MartinSchafferer/Sensorik_MarsRover/5. Fotos/Photo 02.02.19, 16 32 19.jpg

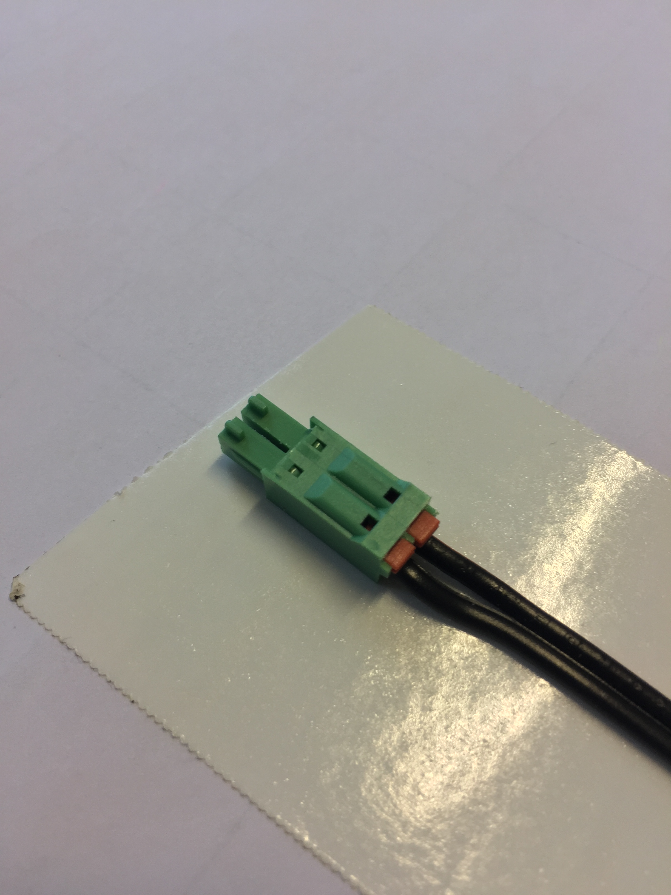
5. Fotos/Photo 02.02.19, 16 32 19.jpg
