MartinSchafferer/Sensorik_MarsRover/3. Elektronik/Rover/Datasheets_extLibraries/DCConverter/Links.txt

https://katalog.we-online.de/de/pm/MAGIC-FDSM
https://katalog.we-online.de/de/pm/MAGIC-VDRM
https://www.mouser.at/ProductDetail/Murata-Power-Solutions/OKI-78SR-5-15-W36HE-C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
https://www.mouser.at/Power/DC-DC-Converters/Non-Isolated-DC-DC-Converters/_/N-brvxx?P=1yzvr6d
