MartinSchafferer/Sensorik_MarsRover/3. Elektronik/Rover/Datasheets_extLibraries/Gyro/Links.txt

https://at.rs-online.com/web/p/products/8837948/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
https://www.invensense.com/products/motion-tracking/6-axis/mpu-6050/
https://electronics.semaf.at/Triple-Axis-Accelerometer-and-Gyro-Breakout-MPU6050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
