MartinSchafferer/Sensorik_MarsRover/3. Elektronik/Rover/Datasheets_extLibraries/Linetracker/Links.txt

http://sensorkit.en.joy-it.net/index.php?title=KY-033_Tracking_sensor_module
