MartinSchafferer/Sensorik_MarsRover/3. Elektronik/Rover/Datasheets_extLibraries/Capacitors/DCConverter/Links.txt

https://katalog.we-online.de/de/pbs/WCAP-CSGP-1210/885012109009?sid=e49973b58e#vs_ct:3
https://katalog.we-online.de/de/pbs/WCAP-ASLU/865090245005?sid=fa7994bd28
https://katalog.we-online.de/de/pbs/WCAP-CSGP-1210/885012109013?sid=c01c210bf1#vs_ct:4
https://katalog.we-online.de/de/pbs/search/capacitors/1290754
