MartinSchafferer/Sensorik_MarsRover/3. Elektronik/Rover/Datasheets_extLibraries/DCSupplyConnector/Links.txt

https://katalog.we-online.de/de/em/TBL_5_00_102_6911027100XX
