MartinSchafferer/Sensorik_MarsRover/3. Elektronik/Rover/Datasheets_extLibraries/Resistors/DCConverter/Links.txt

https://katalog.we-online.de/de/pbs/WRIS-KSKE#vs_t1:1_ct:3
