MartinSchafferer/Sensorik_MarsRover/5. Fotos/Blockschaltbild_01.jpg

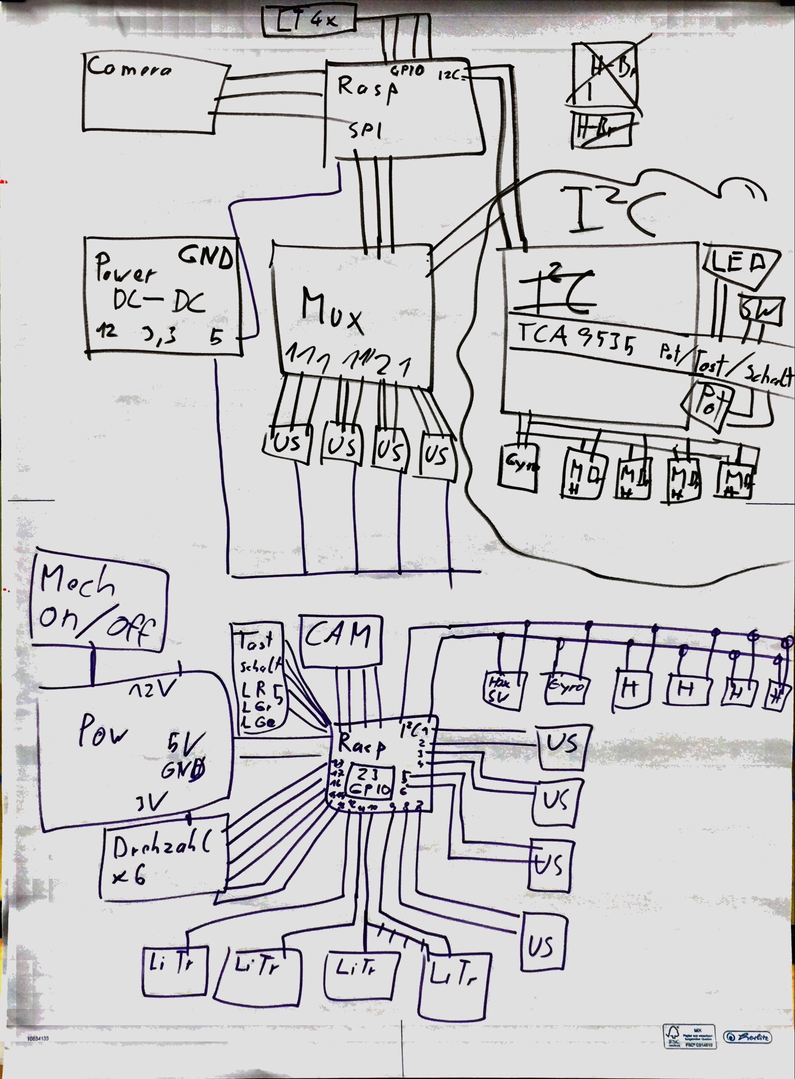
5. Fotos/Blockschaltbild_01.jpg
