MartinSchafferer/Sensorik_MarsRover/5. Fotos/Flipchart_01.jpg

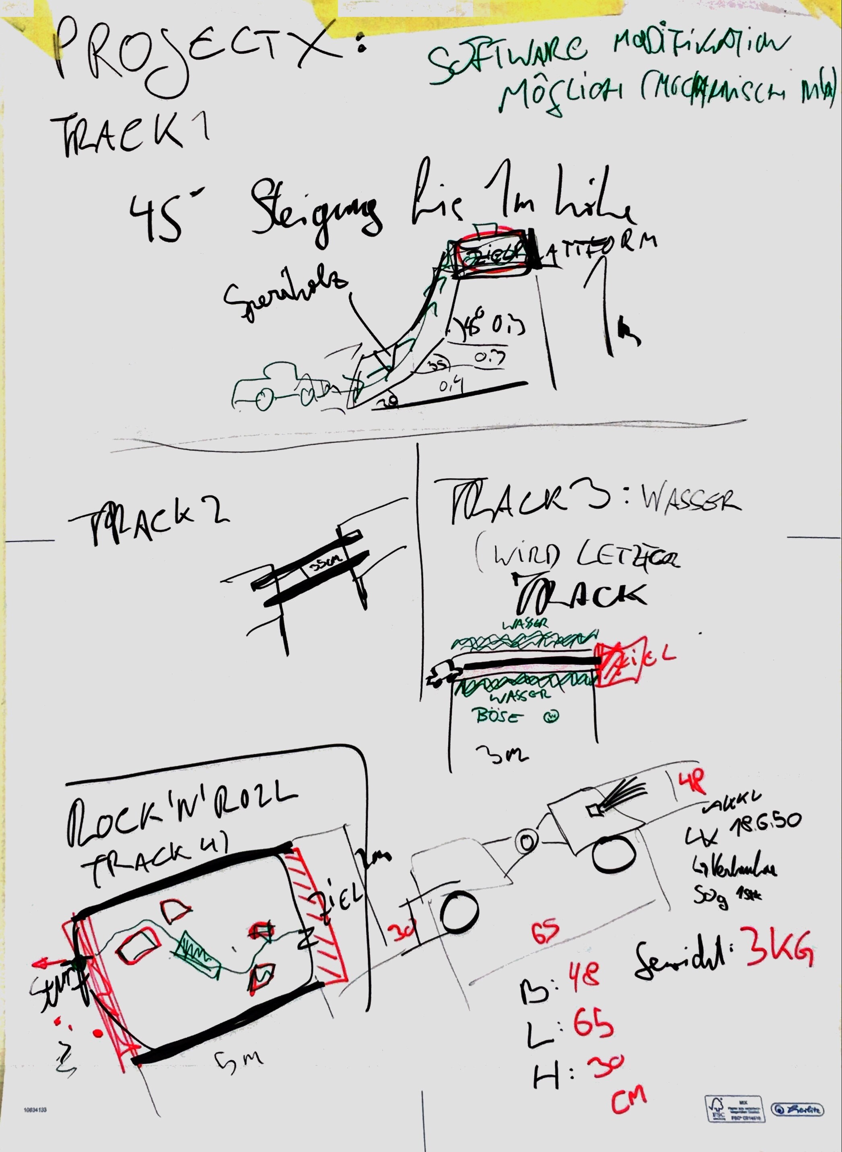
5. Fotos/Flipchart_01.jpg
