MartinSchafferer/Sensorik_MarsRover/5. Fotos/Flipchart_02.jpg

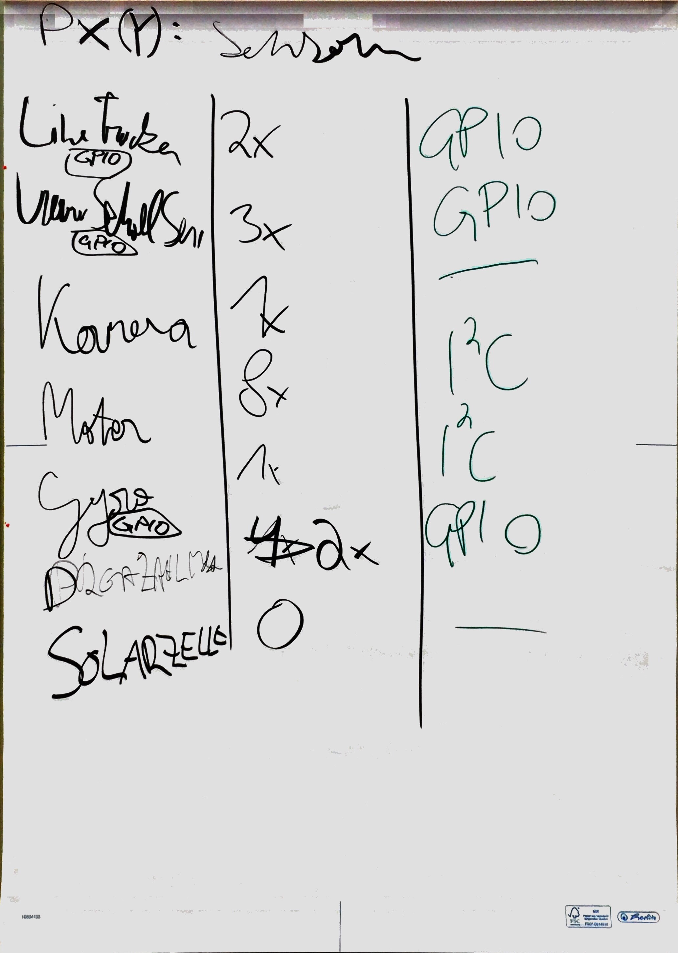
5. Fotos/Flipchart_02.jpg
