MartinSchafferer/Sensorik_MarsRover/5. Fotos/Flipchart_04.jpg

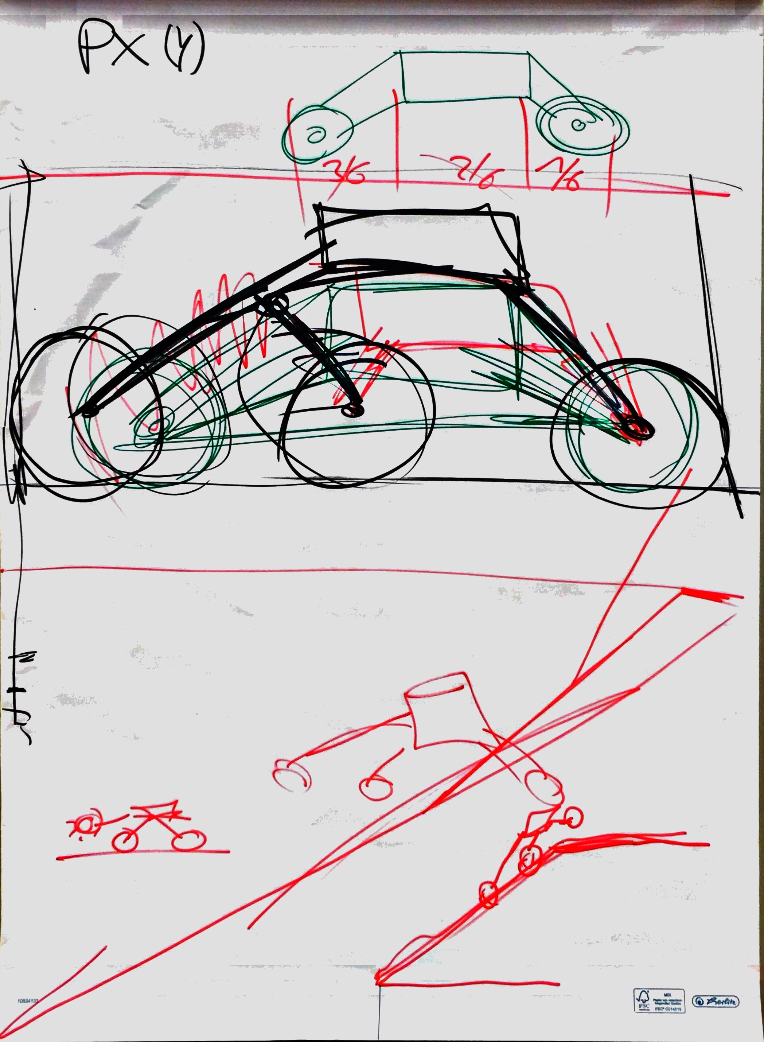
5. Fotos/Flipchart_04.jpg
