MartinSchafferer/Sensorik_MarsRover/5. Fotos/MarsRoverGesamt.PNG

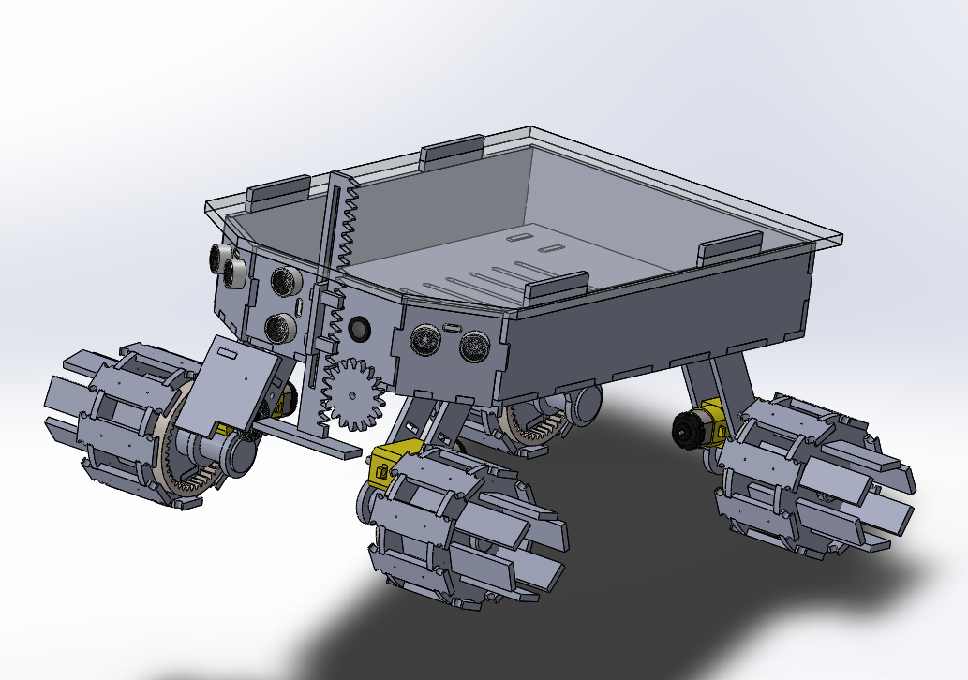
5. Fotos/MarsRoverGesamt.PNG
