MartinSchafferer/Sensorik_MarsRover/5. Fotos/Photo 02.02.19, 16 26 04.jpg

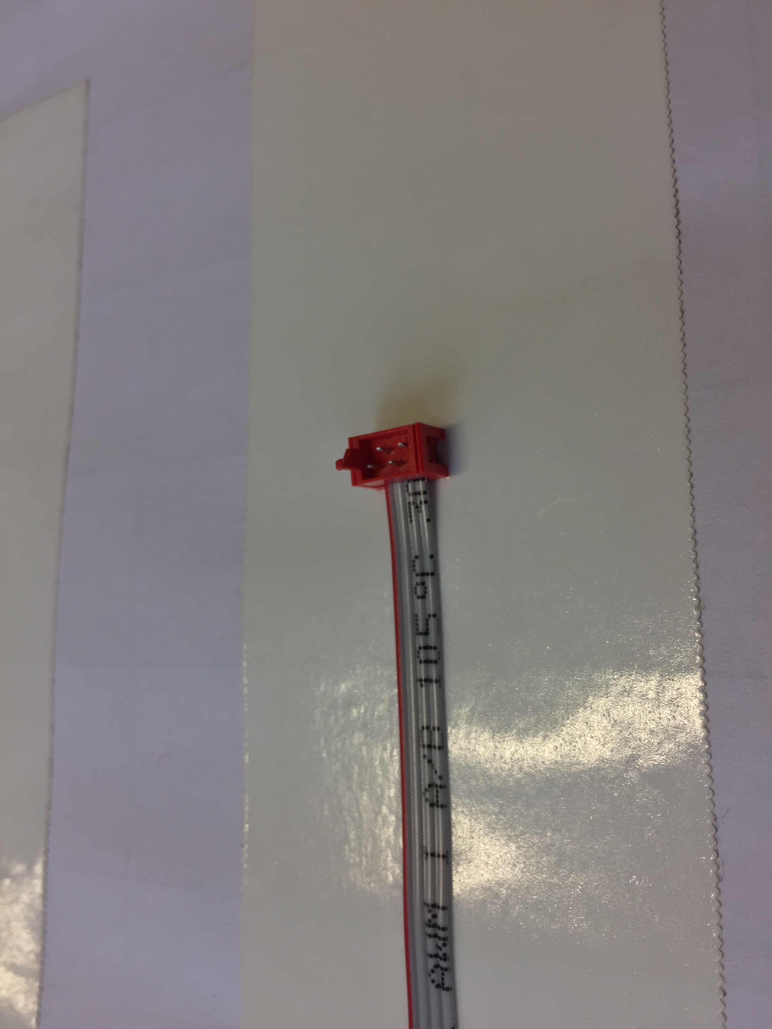
5. Fotos/Photo 02.02.19, 16 26 04.jpg
