MartinSchafferer/Sensorik_MarsRover/5. Fotos/Photo 02.02.19, 16 36 40.jpg

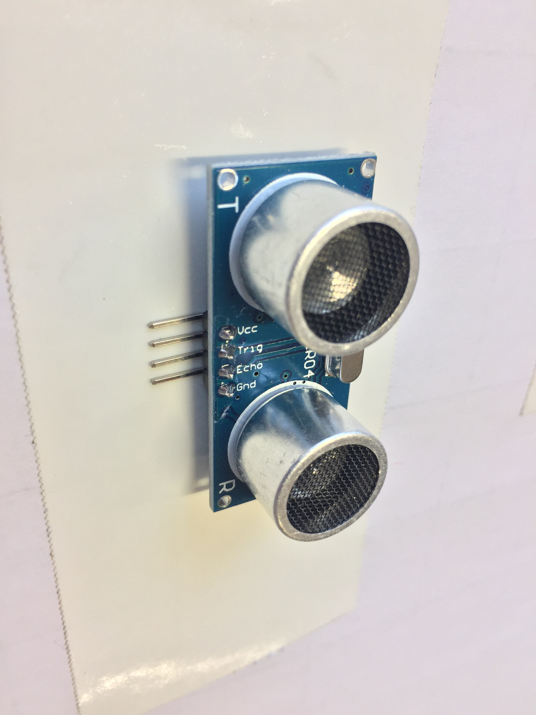
5. Fotos/Photo 02.02.19, 16 36 40.jpg
