MartinSchafferer/Sensorik_MarsRover/5. Fotos/Photo 02.02.19, 18 21 54.jpg

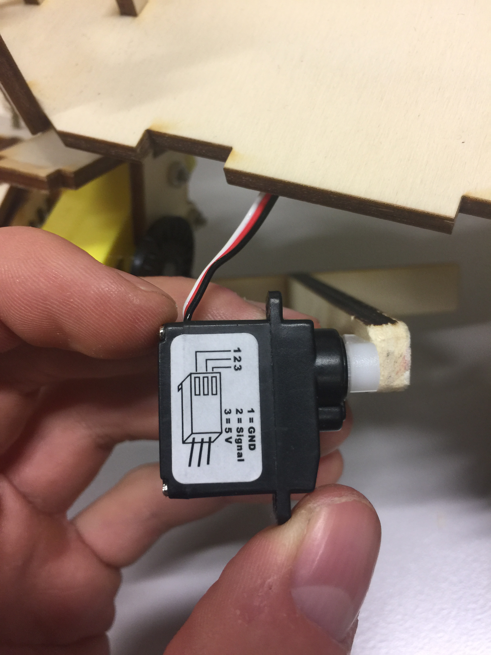
5. Fotos/Photo 02.02.19, 18 21 54.jpg
