MartinSchafferer/Sensorik_MarsRover/5. Fotos/WhatsApp Image 2019-01-25 at 15.22.44.jpeg

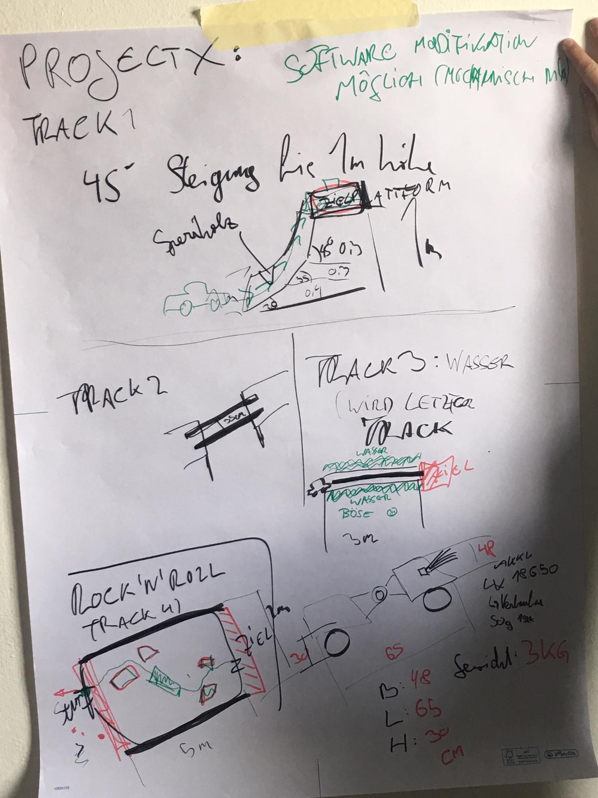
5. Fotos/WhatsApp Image 2019-01-25 at 15.22.44.jpeg
