MartinSchafferer/Sensorik_MarsRover/5. Fotos/WhatsApp Image 2019-02-08 at 19.00.05.jpeg

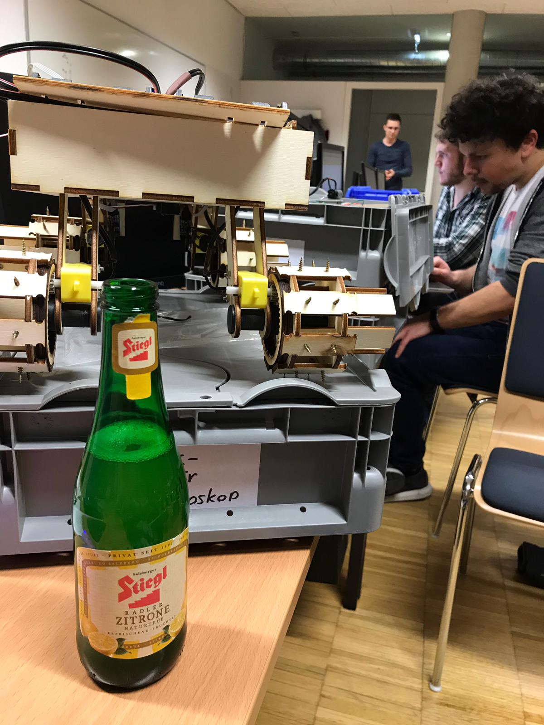
5. Fotos/WhatsApp Image 2019-02-08 at 19.00.05.jpeg
