MartinSchafferer/Sensorik_MarsRover/2. Konstruktion/CAD/Track 2.SLDASM

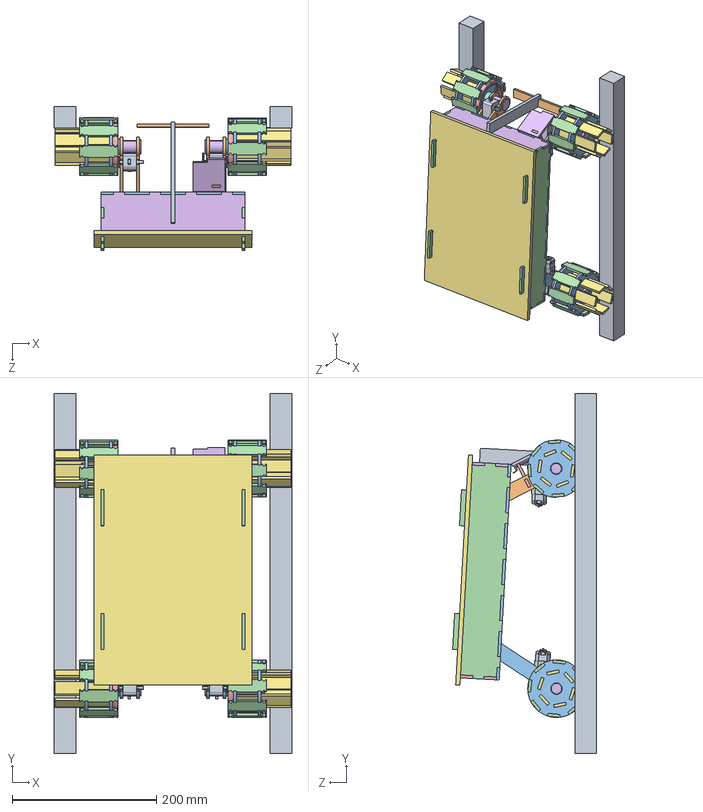
[picture p39: CAD file, 2019-12-10]
2. Konstruktion/CAD/Track 2.SLDASM
330.0 x 500.0 x 199.7 mm
Brücke
Radaufhängung x 4
Radfelge x 8
Radauflager x 32
internal spur gear_iso x 4
Lagerbolzen x 4
Radverlängerung x 24
Abstandshülse x 4
Motor x 4
Zahnrad_klein x 4
Gehäuseunterteil
Gehäuse_seite x 2
Gehause_hinten
Gehause_vorne
Optoacoplador LM393
Lochscheibe
Linetracker_Stange
Linetrackerhalter
Radaufhängung_hinten x 4
Antriebswelle
Distanzhalter
Wasserschutz
Deckel
