MartinSchafferer/Sensorik_MarsRover/2. Konstruktion/CAD/Bewegungsaufbau.SLDASM

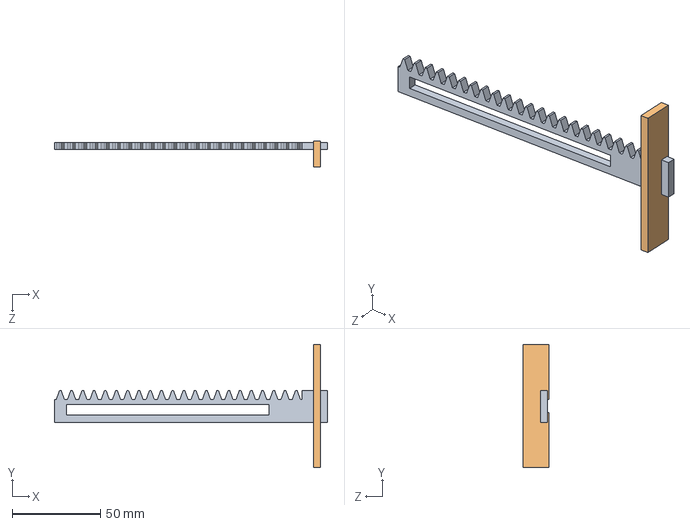
[picture p40: CAD file, 2019-12-10]
2. Konstruktion/CAD/Bewegungsaufbau.SLDASM
155.0 x 70.0 x 15.0 mm
Bewegungsstange
Linetrackerhalter
