MartinSchafferer/Sensorik_MarsRover/2. Konstruktion/CAD/Track 1.SLDASM

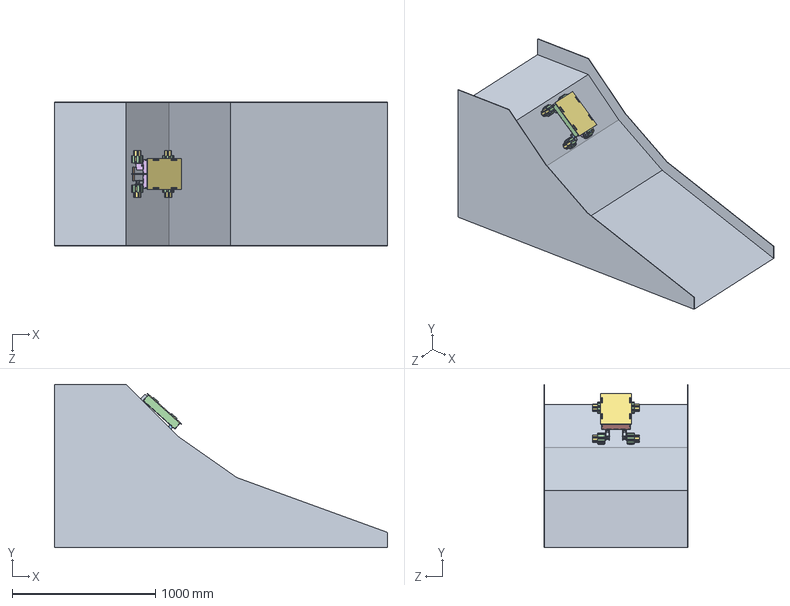
[picture p41: CAD file, 2019-12-10]
2. Konstruktion/CAD/Track 1.SLDASM
2327.4 x 1141.4 x 1008.0 mm
Rampe_Track1
Radaufhängung x 4
Radfelge x 8
Radauflager x 32
internal spur gear_iso x 4
Lagerbolzen x 4
Radverlängerung x 24
Abstandshülse x 4
Motor x 4
Zahnrad_klein x 4
Gehäuseunterteil
Gehäuse_seite x 2
Gehause_hinten
Gehause_vorne
Optoacoplador LM393
Lochscheibe
Linetracker_Stange
Linetrackerhalter
Radaufhängung_hinten x 4
Antriebswelle
Distanzhalter
Wasserschutz
Deckel
