MartinSchafferer/Sensorik_MarsRover/2. Konstruktion/CAD/Gehäuse.SLDASM

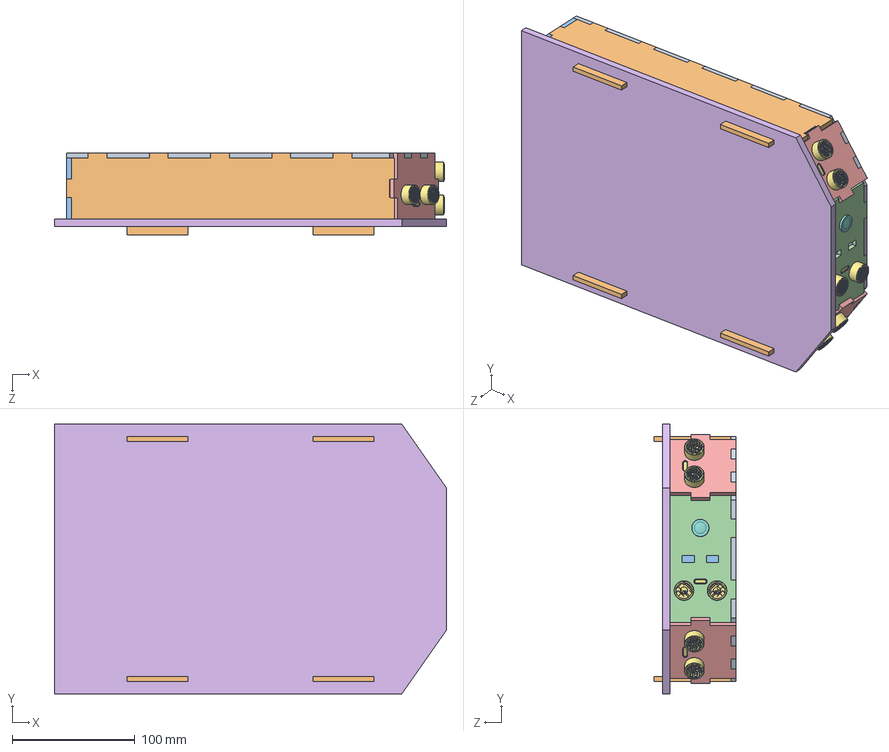
[picture p42: CAD file, 2019-12-10]
2. Konstruktion/CAD/Gehäuse.SLDASM
320.0 x 220.0 x 67.0 mm
Gehäuseunterteil
Gehäuse_seite x 2
Gehause_hinten
Gehause_vorne
Seitenteil_Gehäuse x 2
Deckel
Ultrasonic HCSR04 x 3
CAMERA PI COM LENTE
