MartinSchafferer/Sensorik_MarsRover/2. Konstruktion/CAD/Rad_gesamt.SLDASM

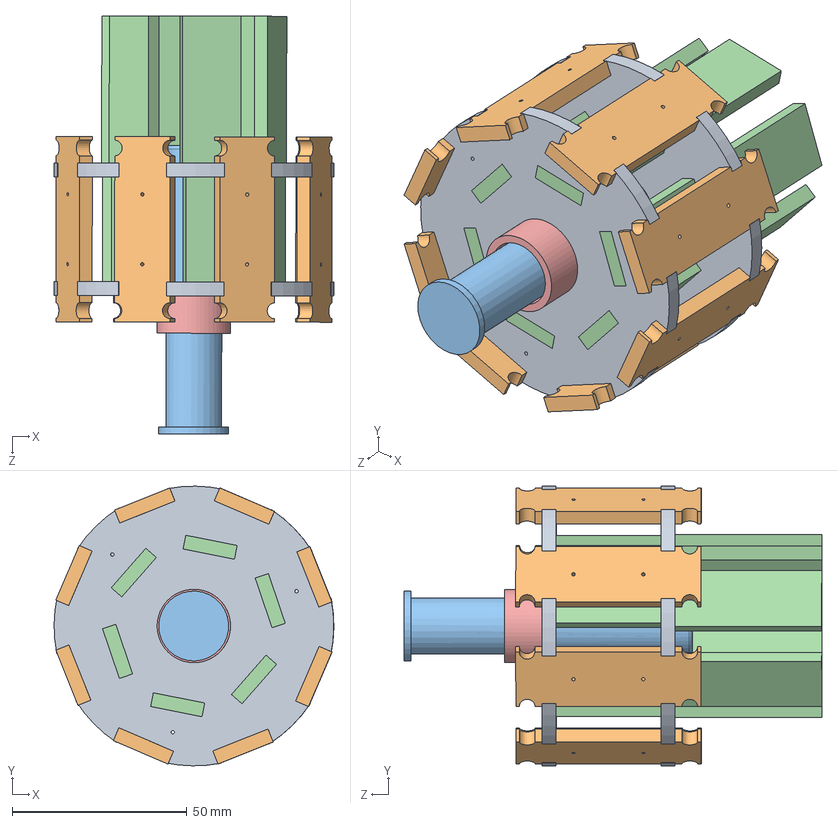
[picture p43: CAD file, 2019-12-10]
2. Konstruktion/CAD/Rad_gesamt.SLDASM
80.1 x 80.0 x 119.6 mm
Radfelge x 2
Radauflager x 8
Lagerbolzen
Radverlängerung x 6
Abstandshülse
