MartinSchafferer/Sensorik_MarsRover/2. Konstruktion/CAD/Linetracker_gesamt.SLDASM

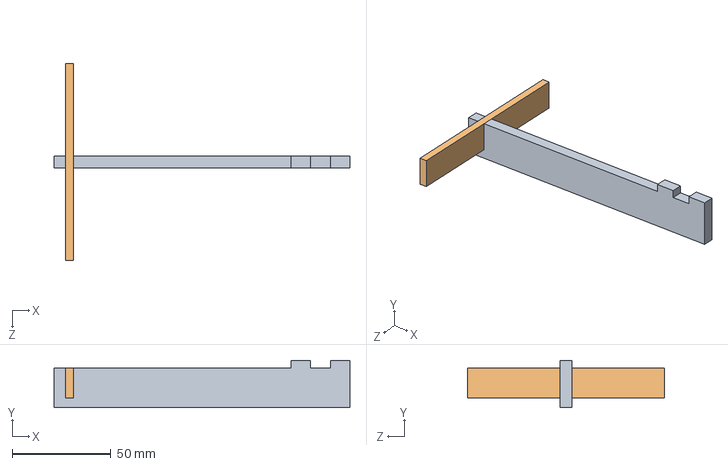
[picture p44: CAD file, 2019-12-10]
2. Konstruktion/CAD/Linetracker_gesamt.SLDASM
150.0 x 24.0 x 100.0 mm
Linetracker_Stange
Linetrackerhalter
