MartinSchafferer/Sensorik_MarsRover/2. Konstruktion/CAD/DXF Datei/Passlehre/Passungslehre.DXF

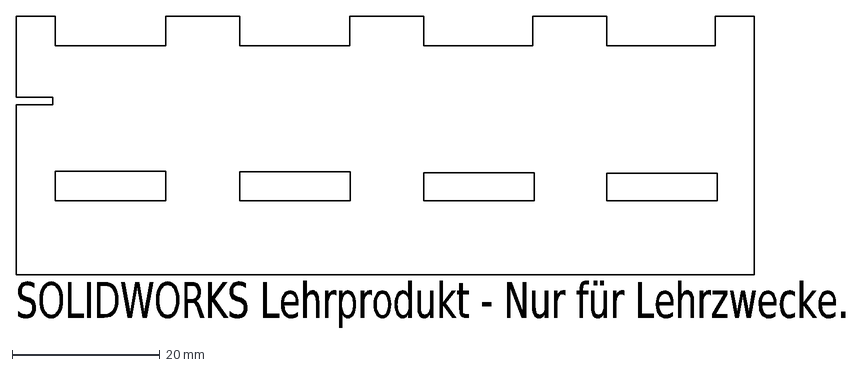
[picture p45: CAD file, 2019-12-10]
2. Konstruktion/CAD/DXF Datei/Passlehre/Passungslehre.DXF
SOLIDWORKS Lehrprodukt - Nur für Lehrzwecke.
