MartinSchafferer/Sensorik_MarsRover/2. Konstruktion/CAD/DXF Datei/Radaufhängung_hinten.DXF

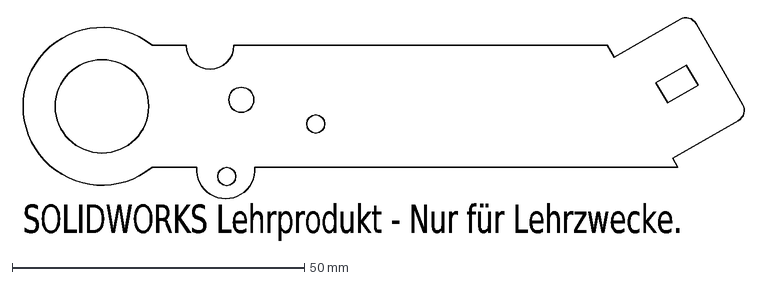
[picture p46: CAD file, 2019-12-10]
2. Konstruktion/CAD/DXF Datei/Radaufhängung_hinten.DXF
SOLIDWORKS Lehrprodukt - Nur für Lehrzwecke.
