MartinSchafferer/Sensorik_MarsRover/2. Konstruktion/CAD/Führungsstifte.SLDPRT

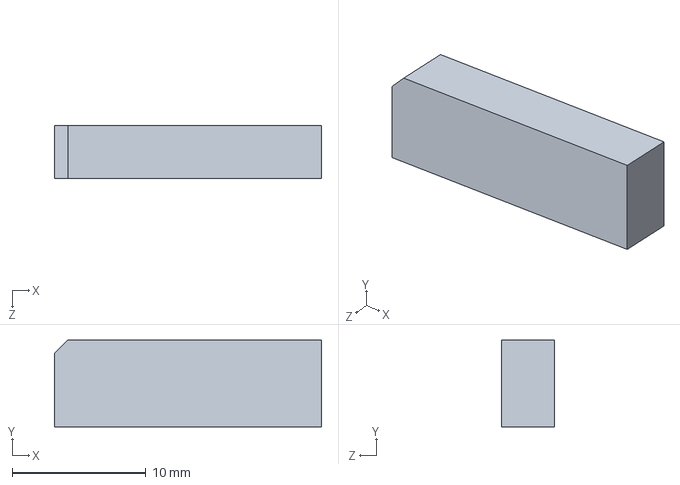
[picture p47: CAD file, 2019-12-10]
2. Konstruktion/CAD/Führungsstifte.SLDPRT
20.0 x 6.50 x 4.00 mm
