MartinSchafferer/Sensorik_MarsRover/2. Konstruktion/CAD/DXF Datei/Passlehre/Passungslehre2.DXF

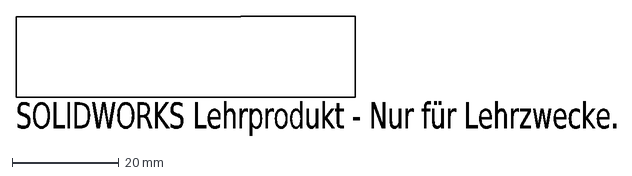
[picture p48: CAD file, 2019-12-10]
2. Konstruktion/CAD/DXF Datei/Passlehre/Passungslehre2.DXF
SOLIDWORKS Lehrprodukt - Nur für Lehrzwecke.
