MartinSchafferer/Sensorik_MarsRover/2. Konstruktion/CAD/DXF Datei/Radauflager.DXF

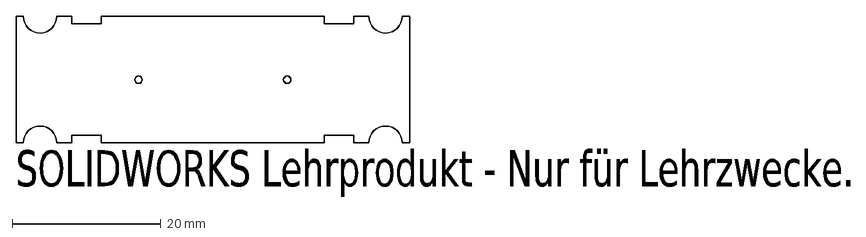
[picture p49: CAD file, 2019-12-10]
2. Konstruktion/CAD/DXF Datei/Radauflager.DXF
SOLIDWORKS Lehrprodukt - Nur für Lehrzwecke.
