MartinSchafferer/Sensorik_MarsRover/2. Konstruktion/CAD/Führungsschiene.SLDPRT

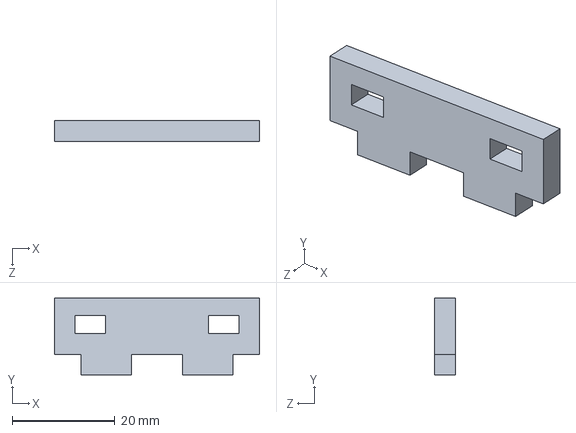
[picture p50: CAD file, 2019-12-10]
2. Konstruktion/CAD/Führungsschiene.SLDPRT
40.0 x 15.0 x 4.00 mm
