MartinSchafferer/Sensorik_MarsRover/2. Konstruktion/CAD/DXF Datei/Gehause_hinten.DXF

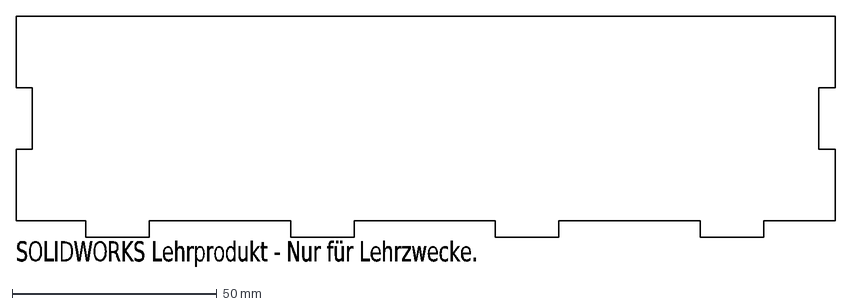
[picture p51: CAD file, 2019-12-10]
2. Konstruktion/CAD/DXF Datei/Gehause_hinten.DXF
SOLIDWORKS Lehrprodukt - Nur für Lehrzwecke.
