MartinSchafferer/Sensorik_MarsRover/2. Konstruktion/CAD/DXF Datei/Passlehre/Passungslehre3.DXF

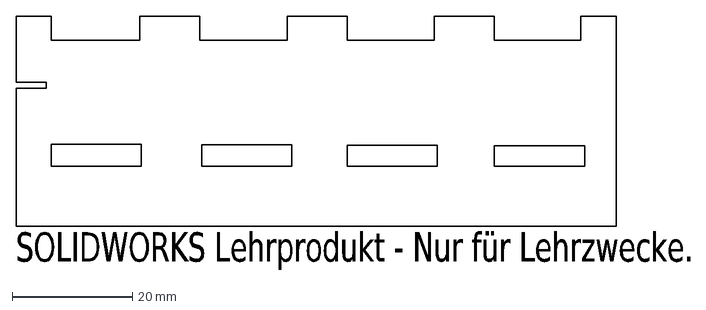
[picture p52: CAD file, 2019-12-10]
2. Konstruktion/CAD/DXF Datei/Passlehre/Passungslehre3.DXF
SOLIDWORKS Lehrprodukt - Nur für Lehrzwecke.
