MartinSchafferer/Sensorik_MarsRover/2. Konstruktion/CAD/Rampe_Track1.SLDPRT

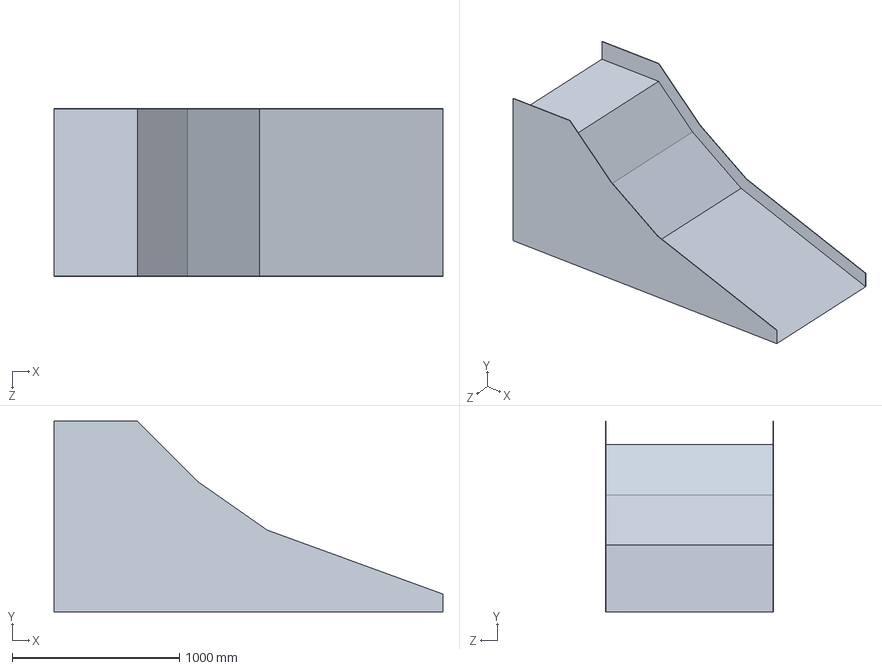
[picture p53: CAD file, 2019-12-10]
2. Konstruktion/CAD/Rampe_Track1.SLDPRT
2327.4 x 1141.4 x 1008.0 mm
