MartinSchafferer/Sensorik_MarsRover/2. Konstruktion/CAD/DXF Datei/Führungsschiene.DXF

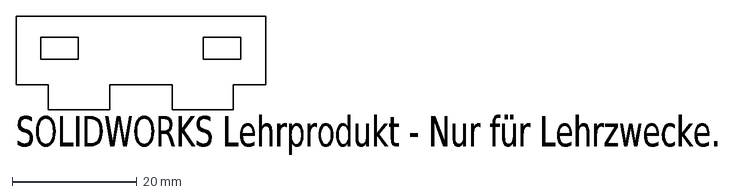
[picture p54: CAD file, 2019-12-10]
2. Konstruktion/CAD/DXF Datei/Führungsschiene.DXF
SOLIDWORKS Lehrprodukt - Nur für Lehrzwecke.
