MartinSchafferer/Sensorik_MarsRover/2. Konstruktion/CAD/Optoacoplador LM393.SLDPRT

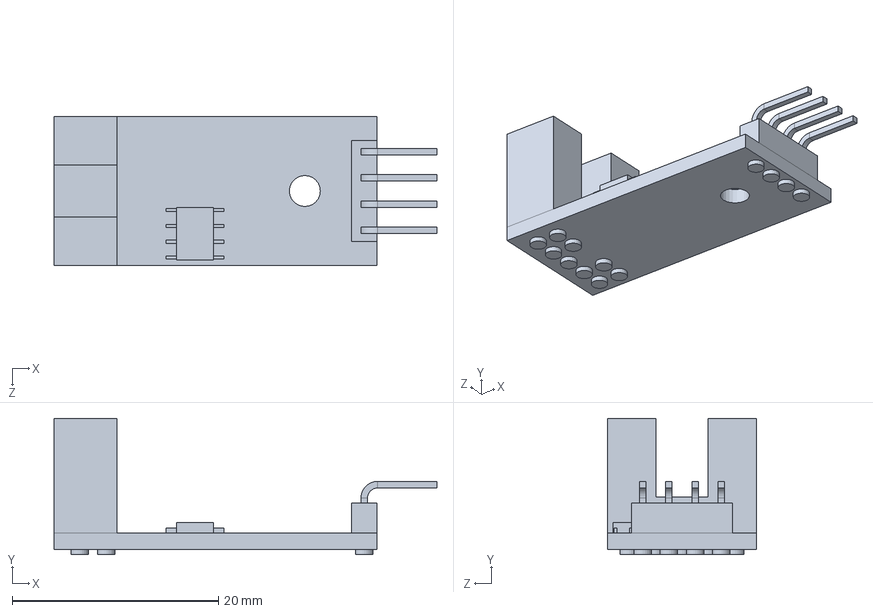
[picture p55: CAD file, 2019-12-10]
2. Konstruktion/CAD/Optoacoplador LM393.SLDPRT
37.1 x 13.2 x 14.4 mm
