MartinSchafferer/Sensorik_MarsRover/2. Konstruktion/CAD/DXF Datei/Seitenteil_Gehäuse.DXF

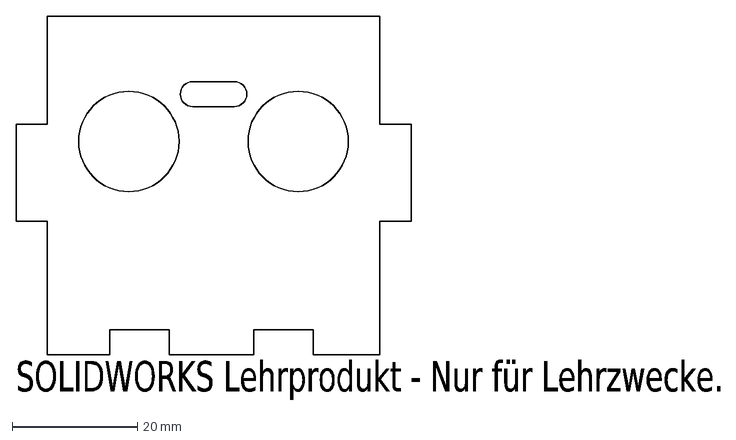
[picture p56: CAD file, 2019-12-10]
2. Konstruktion/CAD/DXF Datei/Seitenteil_Gehäuse.DXF
SOLIDWORKS Lehrprodukt - Nur für Lehrzwecke.
