MartinSchafferer/Sensorik_MarsRover/2. Konstruktion/CAD/Motor.SLDPRT

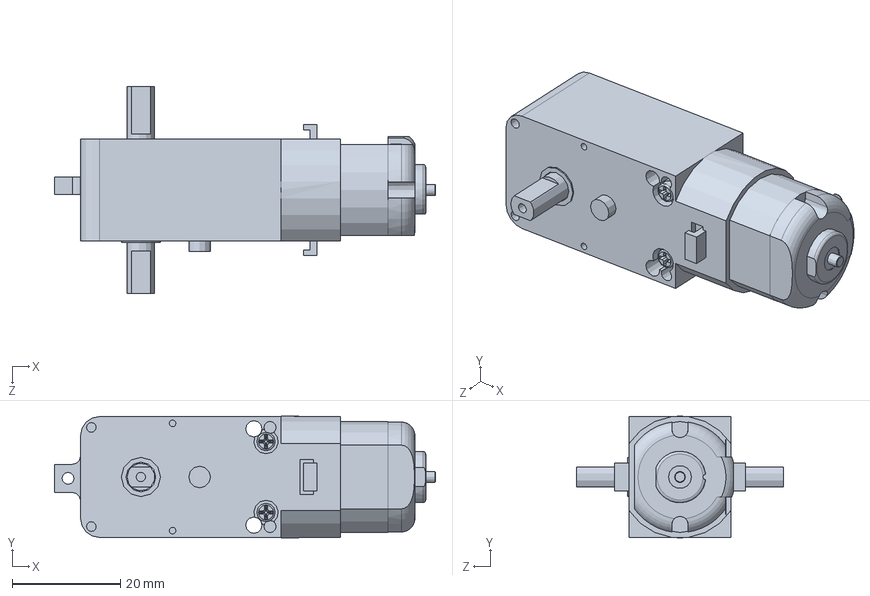
[picture p57: CAD file, 2019-12-10]
2. Konstruktion/CAD/Motor.SLDPRT
70.3 x 22.5 x 38.2 mm
