MartinSchafferer/Sensorik_MarsRover/2. Konstruktion/CAD/DXF Datei/Linetracker_Stange.DXF

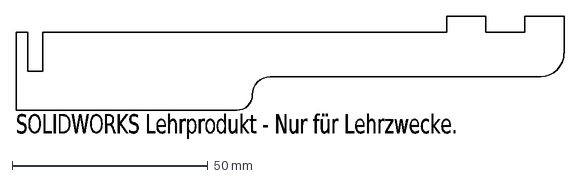
[picture p58: CAD file, 2019-12-10]
2. Konstruktion/CAD/DXF Datei/Linetracker_Stange.DXF
SOLIDWORKS Lehrprodukt - Nur für Lehrzwecke.
