MartinSchafferer/Sensorik_MarsRover/2. Konstruktion/CAD/Radaufhängung_hinten.SLDPRT

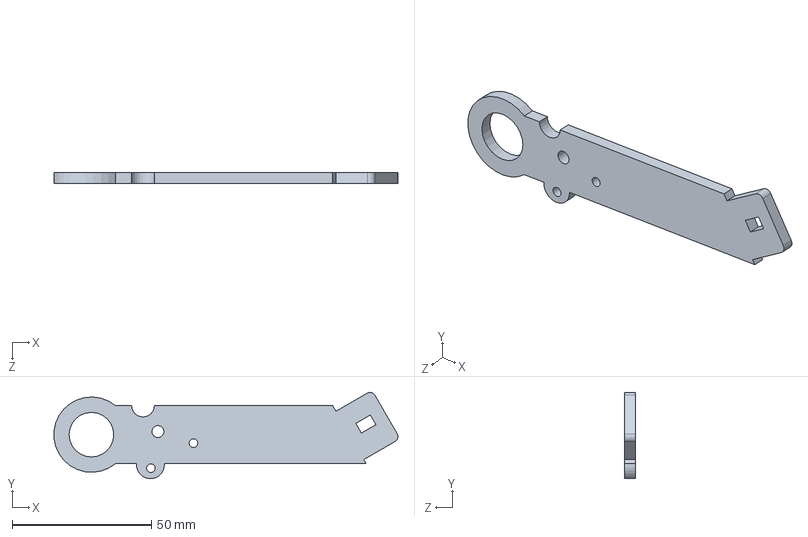
[picture p59: CAD file, 2019-12-10]
2. Konstruktion/CAD/Radaufhängung_hinten.SLDPRT
123.4 x 30.9 x 4.00 mm
