MartinSchafferer/Sensorik_MarsRover/2. Konstruktion/CAD/DXF Datei/Linetrackerhalter.DXF

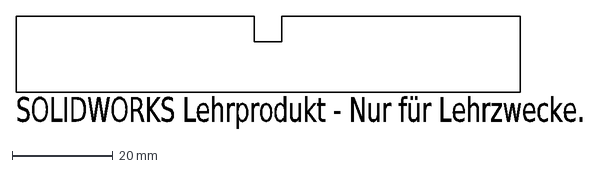
[picture p60: CAD file, 2019-12-10]
2. Konstruktion/CAD/DXF Datei/Linetrackerhalter.DXF
SOLIDWORKS Lehrprodukt - Nur für Lehrzwecke.
