MartinSchafferer/Sensorik_MarsRover/2. Konstruktion/CAD/ZweiterBoden.SLDPRT

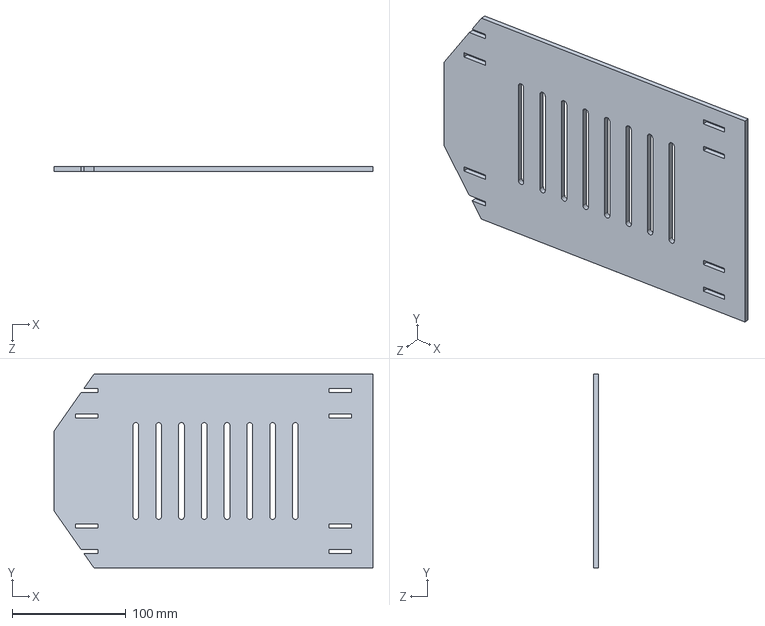
[picture p61: CAD file, 2019-12-10]
2. Konstruktion/CAD/ZweiterBoden.SLDPRT
280.0 x 170.0 x 4.00 mm
