MartinSchafferer/Sensorik_MarsRover/2. Konstruktion/CAD/DXF Datei/Gehause_vorne.DXF

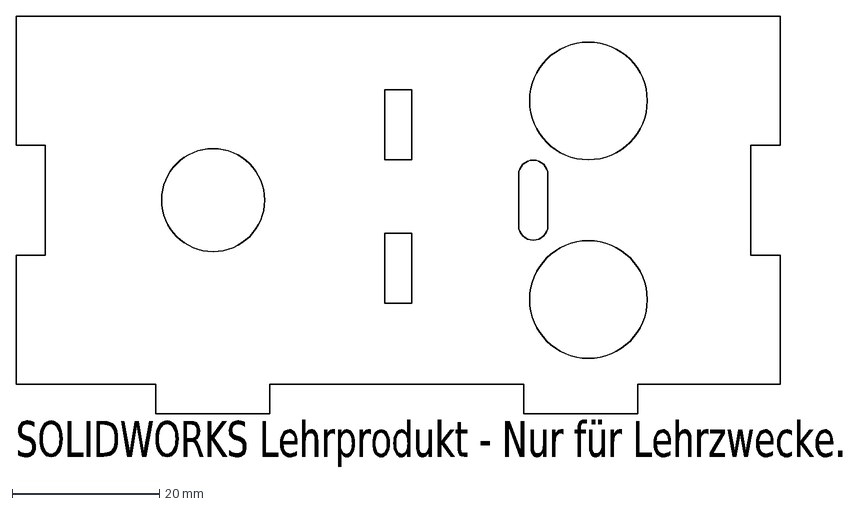
[picture p62: CAD file, 2019-12-10]
2. Konstruktion/CAD/DXF Datei/Gehause_vorne.DXF
SOLIDWORKS Lehrprodukt - Nur für Lehrzwecke.
