MartinSchafferer/Sensorik_MarsRover/2. Konstruktion/CAD/DXF Datei/Deckel.DXF

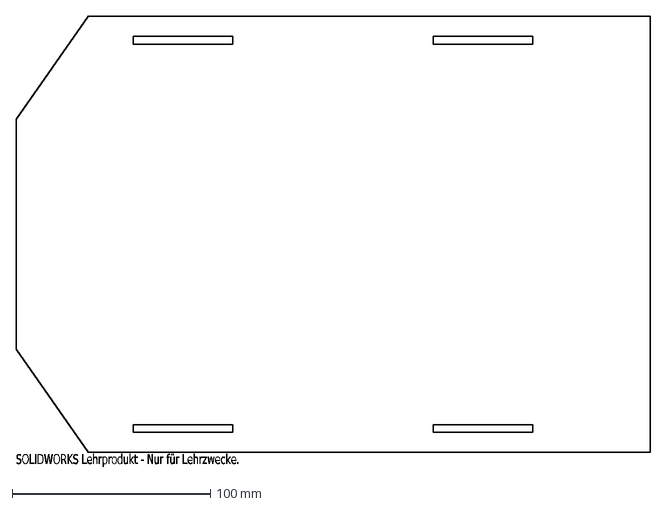
[picture p63: CAD file, 2019-12-10]
2. Konstruktion/CAD/DXF Datei/Deckel.DXF
SOLIDWORKS Lehrprodukt - Nur für Lehrzwecke.
