MartinSchafferer/Sensorik_MarsRover/2. Konstruktion/CAD/Ultrasonic HCSR04.SLDPRT

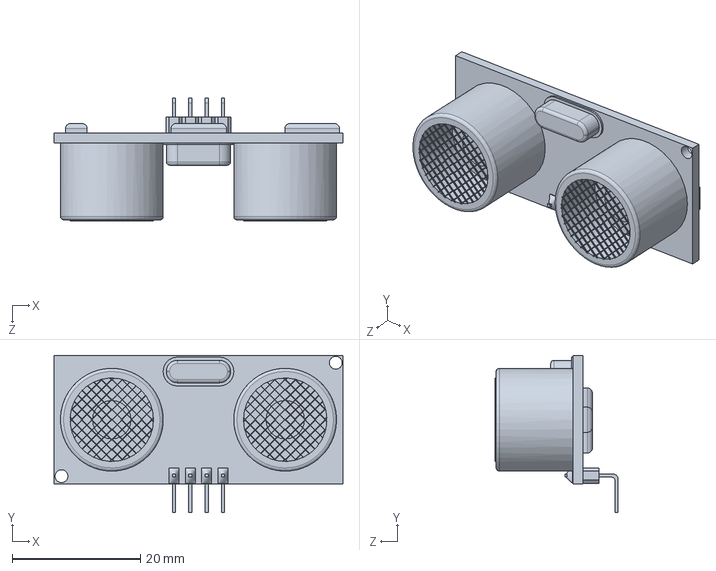
[picture p64: CAD file, 2019-12-10]
2. Konstruktion/CAD/Ultrasonic HCSR04.SLDPRT
45.0 x 24.5 x 19.2 mm
