MartinSchafferer/Sensorik_MarsRover/2. Konstruktion/CAD/DXF Datei/Innenzahnrad.DXF

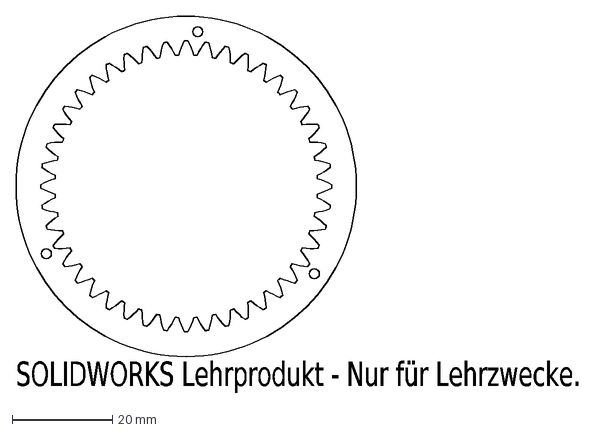
[picture p65: CAD file, 2019-12-10]
2. Konstruktion/CAD/DXF Datei/Innenzahnrad.DXF
SOLIDWORKS Lehrprodukt - Nur für Lehrzwecke.
