MartinSchafferer/Sensorik_MarsRover/2. Konstruktion/CAD/Deckel.SLDPRT

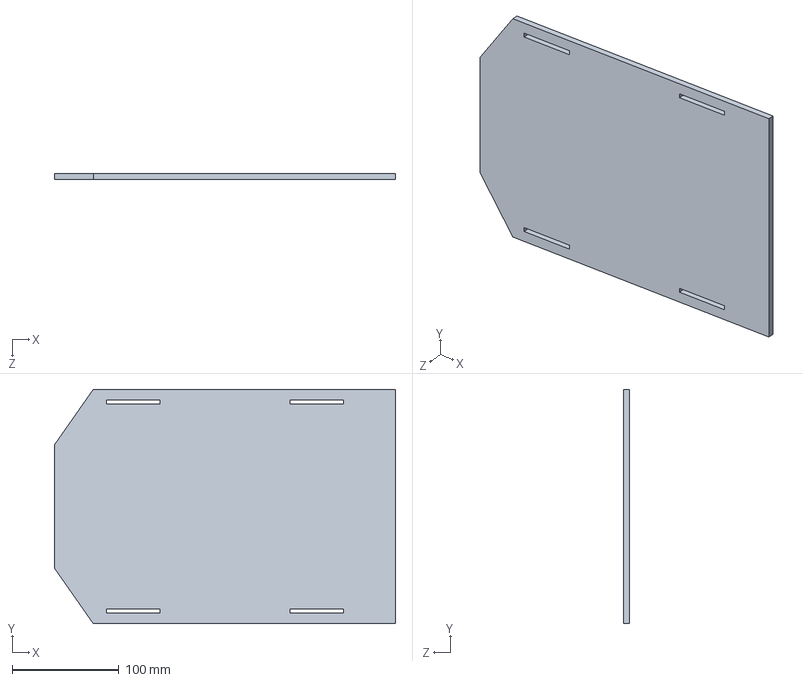
[picture p66: CAD file, 2019-12-10]
2. Konstruktion/CAD/Deckel.SLDPRT
320.0 x 220.0 x 6.00 mm
