MartinSchafferer/Sensorik_MarsRover/2. Konstruktion/CAD/DXF Datei/Radaufhaengung.DXF

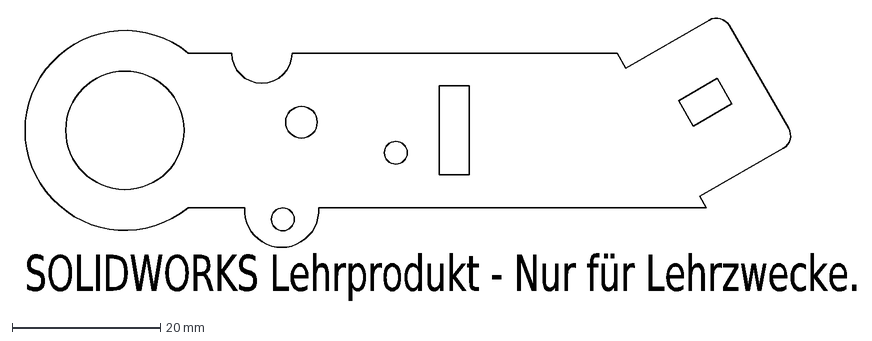
[picture p67: CAD file, 2019-12-10]
2. Konstruktion/CAD/DXF Datei/Radaufhaengung.DXF
SOLIDWORKS Lehrprodukt - Nur für Lehrzwecke.
