MartinSchafferer/Sensorik_MarsRover/2. Konstruktion/CAD/DXF Datei/PassHalterung.DXF

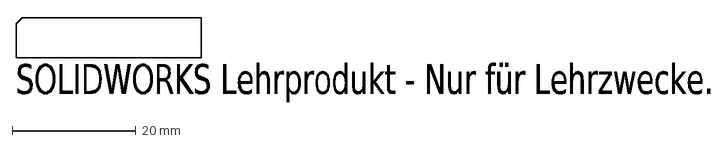
[picture p68: CAD file, 2019-12-10]
2. Konstruktion/CAD/DXF Datei/PassHalterung.DXF
SOLIDWORKS Lehrprodukt - Nur für Lehrzwecke.
