MartinSchafferer/Sensorik_MarsRover/2. Konstruktion/CAD/Passungslehre.SLDPRT

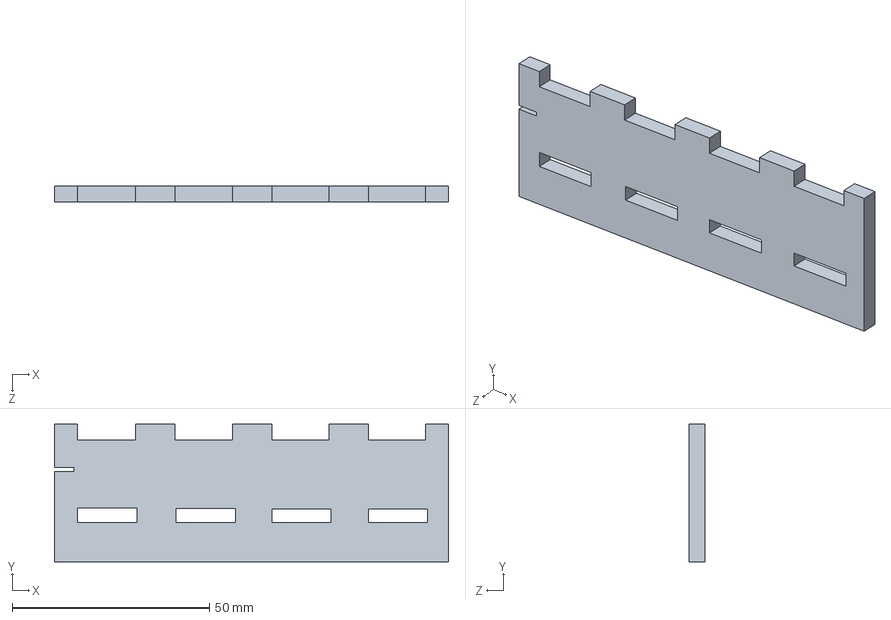
[picture p69: CAD file, 2019-12-10]
2. Konstruktion/CAD/Passungslehre.SLDPRT
100.0 x 35.0 x 4.00 mm
