MartinSchafferer/Sensorik_MarsRover/2. Konstruktion/CAD/DXF Datei/Radaufhängung.DXF

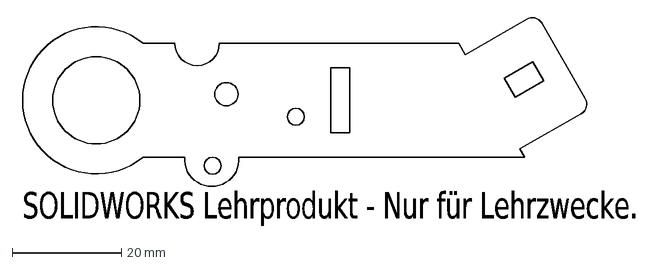
[picture p70: CAD file, 2019-12-10]
2. Konstruktion/CAD/DXF Datei/Radaufhängung.DXF
SOLIDWORKS Lehrprodukt - Nur für Lehrzwecke.
