MartinSchafferer/Sensorik_MarsRover/2. Konstruktion/CAD/Linetrackerhalter.SLDPRT

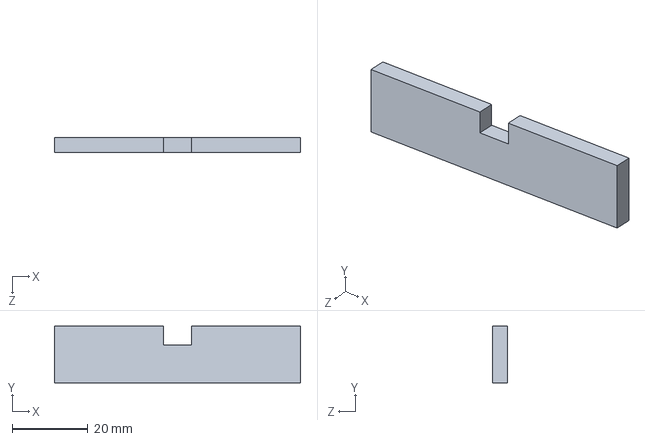
[picture p71: CAD file, 2019-12-10]
2. Konstruktion/CAD/Linetrackerhalter.SLDPRT
65.0 x 15.0 x 4.00 mm
