MartinSchafferer/Sensorik_MarsRover/2. Konstruktion/CAD/DXF Datei/Zahnrad_Sensoren.DXF

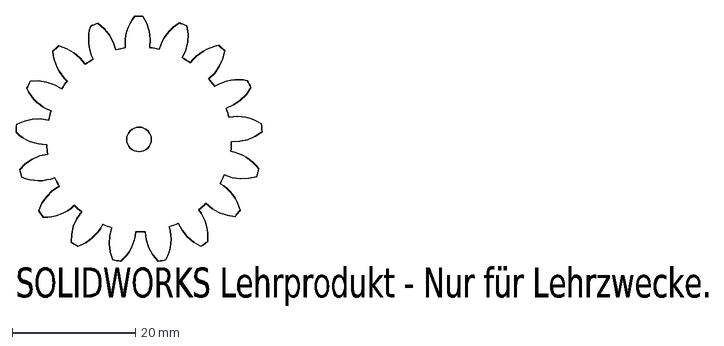
[picture p72: CAD file, 2019-12-10]
2. Konstruktion/CAD/DXF Datei/Zahnrad_Sensoren.DXF
SOLIDWORKS Lehrprodukt - Nur für Lehrzwecke.
