MartinSchafferer/Sensorik_MarsRover/2. Konstruktion/CAD/Maximalmasse.SLDPRT

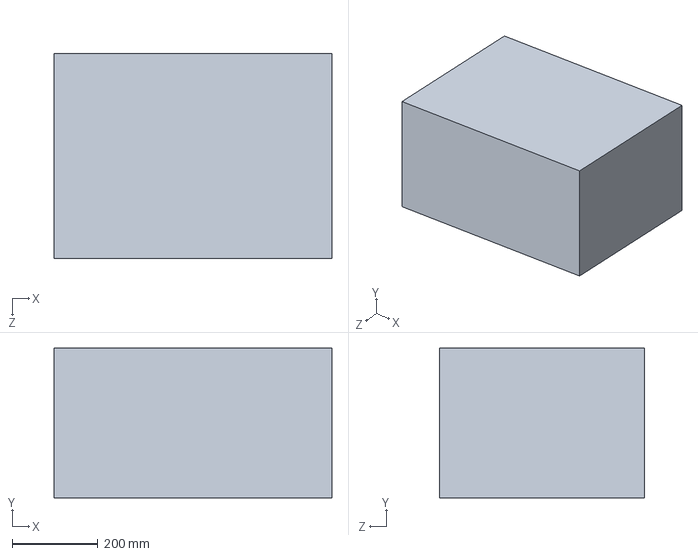
[picture p73: CAD file, 2019-12-10]
2. Konstruktion/CAD/Maximalmasse.SLDPRT
650.0 x 350.0 x 480.0 mm
