MartinSchafferer/Sensorik_MarsRover/2. Konstruktion/CAD/Bewegungsstange.SLDPRT

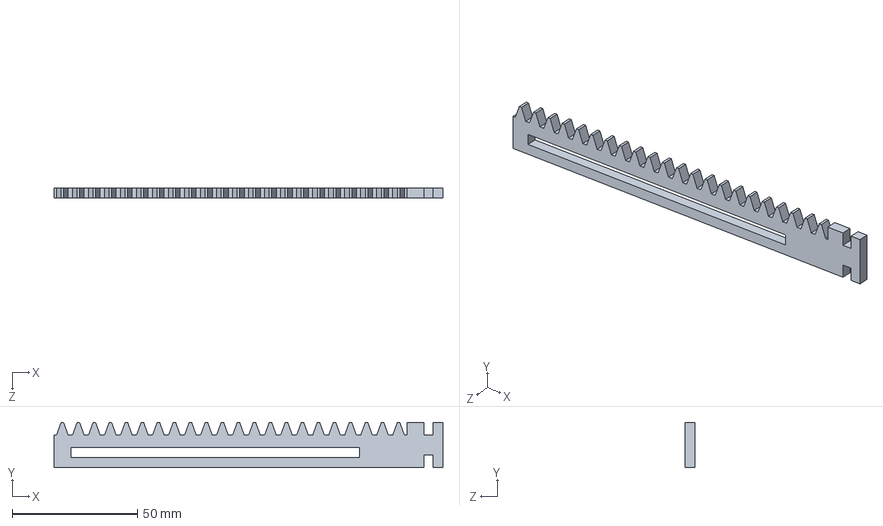
[picture p74: CAD file, 2019-12-10]
2. Konstruktion/CAD/Bewegungsstange.SLDPRT
155.0 x 18.0 x 4.00 mm
