MartinSchafferer/Sensorik_MarsRover/2. Konstruktion/CAD/DXF Datei/Radfelge.DXF

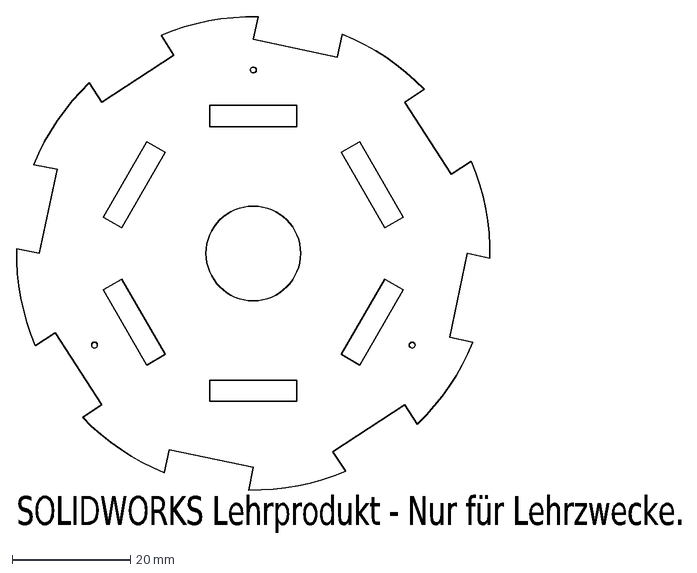
[picture p75: CAD file, 2019-12-10]
2. Konstruktion/CAD/DXF Datei/Radfelge.DXF
SOLIDWORKS Lehrprodukt - Nur für Lehrzwecke.
