MartinSchafferer/Sensorik_MarsRover/2. Konstruktion/CAD/DXF Datei/Zahnrad_klein.DXF

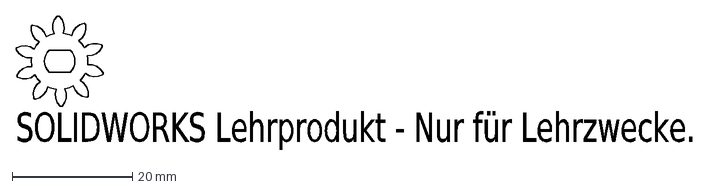
[picture p76: CAD file, 2019-12-10]
2. Konstruktion/CAD/DXF Datei/Zahnrad_klein.DXF
SOLIDWORKS Lehrprodukt - Nur für Lehrzwecke.
