MartinSchafferer/Sensorik_MarsRover/2. Konstruktion/CAD/PassHalterung.SLDPRT

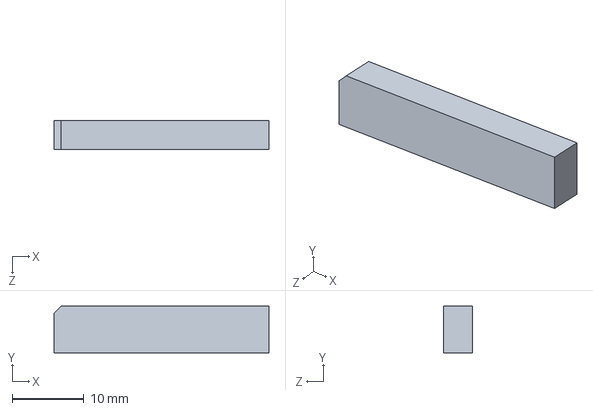
[picture p77: CAD file, 2019-12-10]
2. Konstruktion/CAD/PassHalterung.SLDPRT
30.0 x 6.50 x 4.00 mm
