MartinSchafferer/Sensorik_MarsRover/2. Konstruktion/CAD/DXF Datei/Distanzhalter.DXF

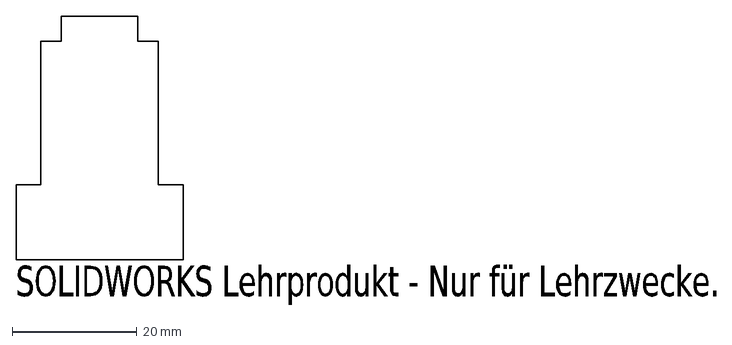
[picture p78: CAD file, 2019-12-10]
2. Konstruktion/CAD/DXF Datei/Distanzhalter.DXF
SOLIDWORKS Lehrprodukt - Nur für Lehrzwecke.
