MartinSchafferer/Sensorik_MarsRover/2. Konstruktion/CAD/Gehause_vorne.SLDPRT

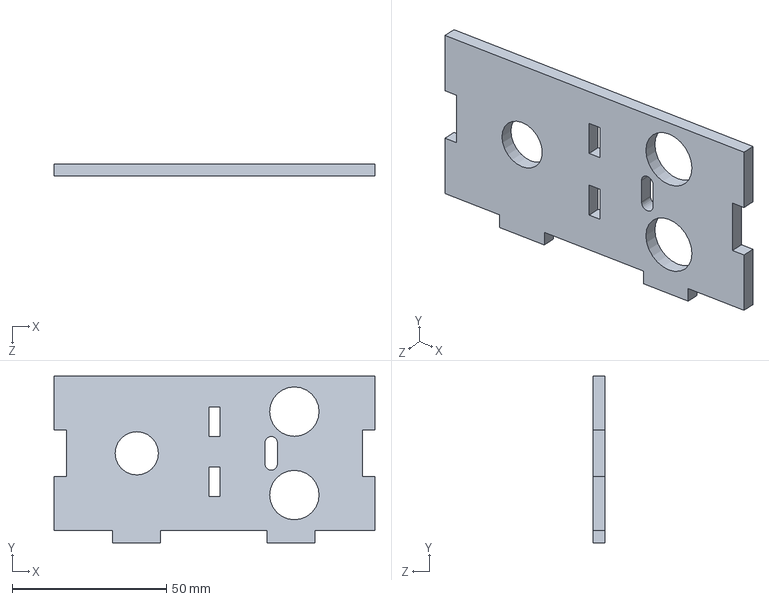
[picture p79: CAD file, 2019-12-10]
2. Konstruktion/CAD/Gehause_vorne.SLDPRT
103.9 x 54.0 x 4.00 mm
