MartinSchafferer/Sensorik_MarsRover/2. Konstruktion/CAD/DXF Datei/Führungsstifte.DXF

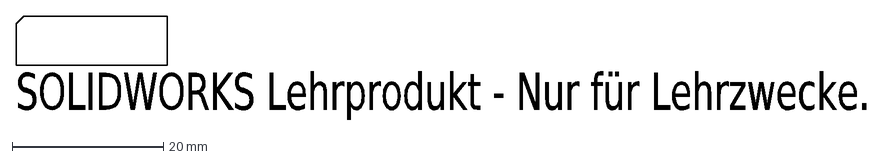
[picture p80: CAD file, 2019-12-10]
2. Konstruktion/CAD/DXF Datei/Führungsstifte.DXF
SOLIDWORKS Lehrprodukt - Nur für Lehrzwecke.
