MartinSchafferer/Sensorik_MarsRover/2. Konstruktion/CAD/DXF Datei/Linetrackerhalter_klein.DXF

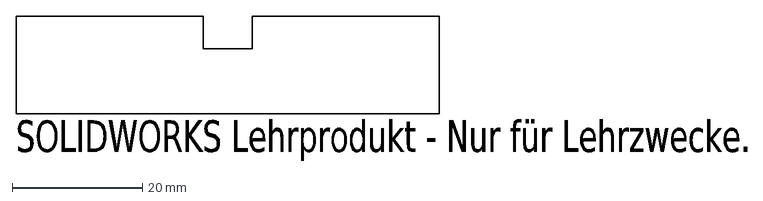
[picture p81: CAD file, 2019-12-10]
2. Konstruktion/CAD/DXF Datei/Linetrackerhalter_klein.DXF
SOLIDWORKS Lehrprodukt - Nur für Lehrzwecke.
