MartinSchafferer/Sensorik_MarsRover/2. Konstruktion/CAD/Lagerbolzen.SLDPRT

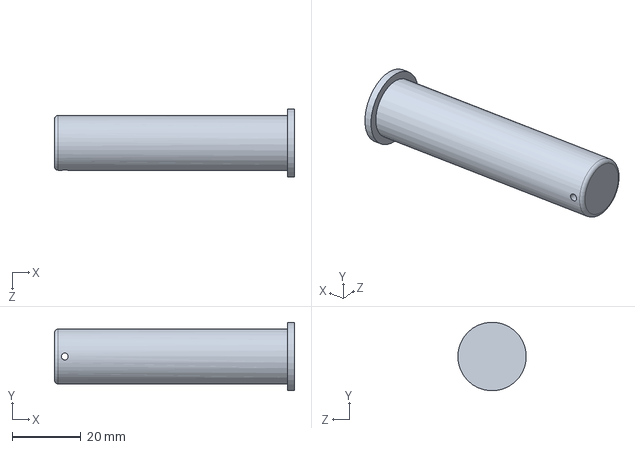
[picture p82: CAD file, 2019-12-10]
2. Konstruktion/CAD/Lagerbolzen.SLDPRT
70.0 x 20.0 x 20.0 mm
