MartinSchafferer/Sensorik_MarsRover/2. Konstruktion/CAD/Antriebswelle.SLDPRT

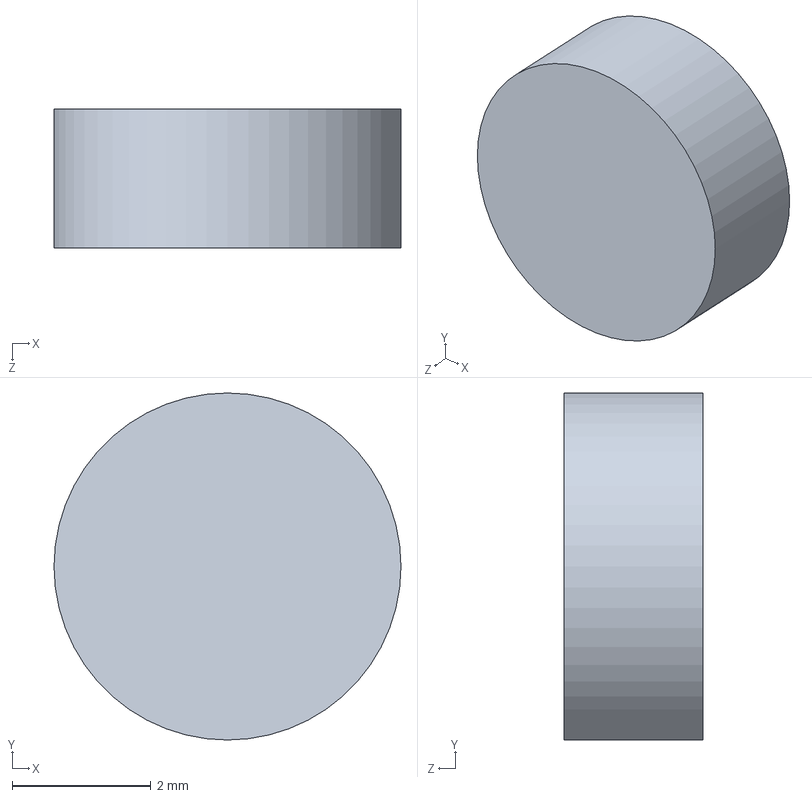
[picture p83: CAD file, 2019-12-10]
2. Konstruktion/CAD/Antriebswelle.SLDPRT
5.00 x 5.00 x 2.00 mm
