MartinSchafferer/Sensorik_MarsRover/2. Konstruktion/CAD/DXF Datei/Radverlängerung.DXF

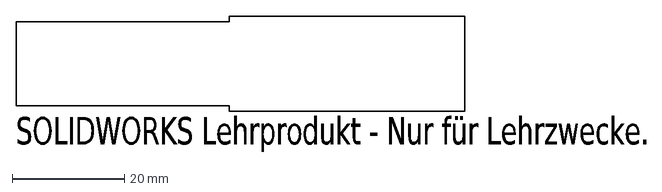
[picture p84: CAD file, 2019-12-10]
2. Konstruktion/CAD/DXF Datei/Radverlängerung.DXF
SOLIDWORKS Lehrprodukt - Nur für Lehrzwecke.
