MartinSchafferer/Sensorik_MarsRover/2. Konstruktion/CAD/Distanzhalter.SLDPRT

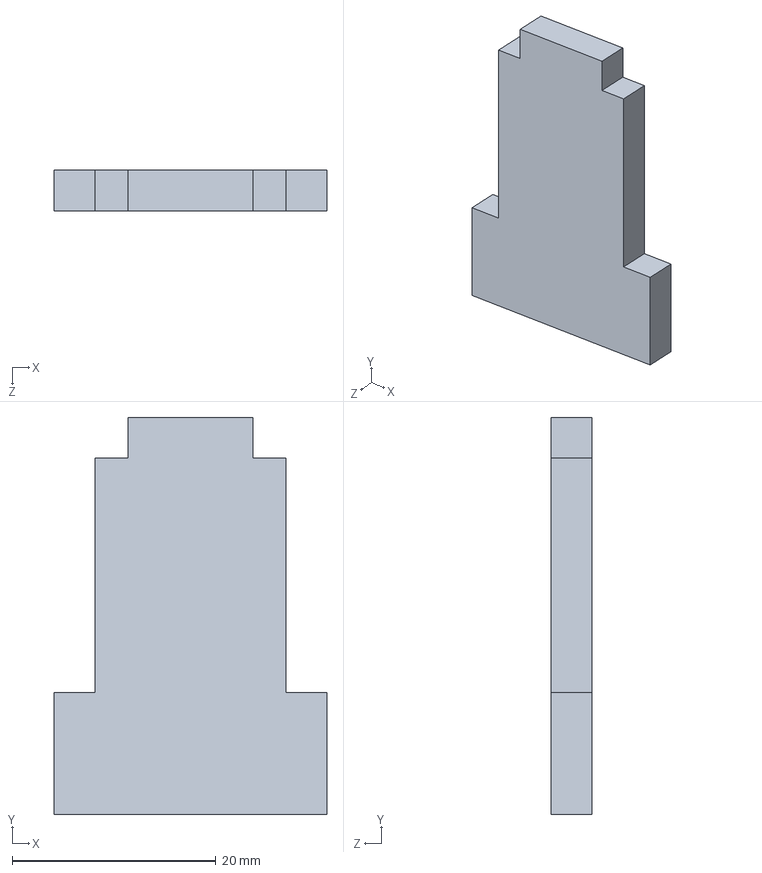
[picture p85: CAD file, 2019-12-10]
2. Konstruktion/CAD/Distanzhalter.SLDPRT
26.8 x 39.0 x 4.00 mm
