MartinSchafferer/Sensorik_MarsRover/2. Konstruktion/CAD/DXF Datei/Bewegungsstange.DXF

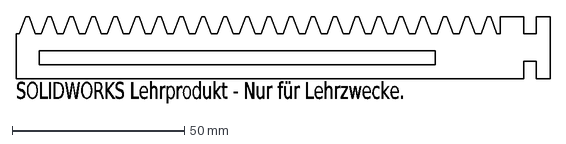
[picture p86: CAD file, 2019-12-10]
2. Konstruktion/CAD/DXF Datei/Bewegungsstange.DXF
SOLIDWORKS Lehrprodukt - Nur für Lehrzwecke.
