MartinSchafferer/Sensorik_MarsRover/2. Konstruktion/CAD/DXF Datei/Gehäuse_seite.DXF

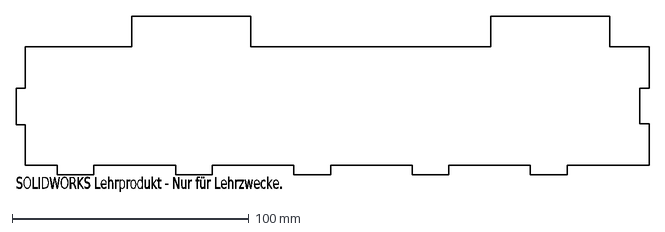
[picture p87: CAD file, 2019-12-10]
2. Konstruktion/CAD/DXF Datei/Gehäuse_seite.DXF
SOLIDWORKS Lehrprodukt - Nur für Lehrzwecke.
