MartinSchafferer/Sensorik_MarsRover/2. Konstruktion/CAD/Linetracker_Stange.SLDPRT

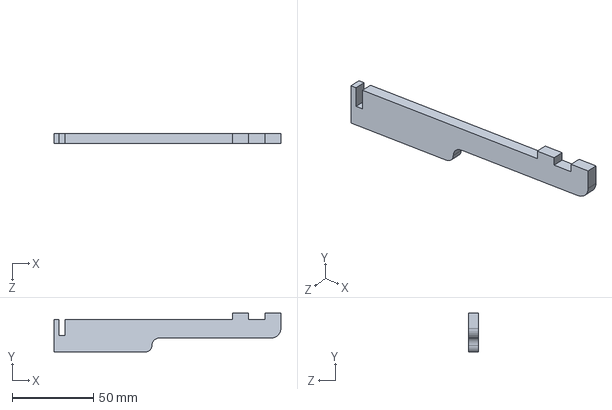
[picture p88: CAD file, 2019-12-10]
2. Konstruktion/CAD/Linetracker_Stange.SLDPRT
140.0 x 24.0 x 6.00 mm
