MartinSchafferer/Sensorik_MarsRover/2. Konstruktion/CAD/DXF Datei/Gehäuseunterteil.DXF

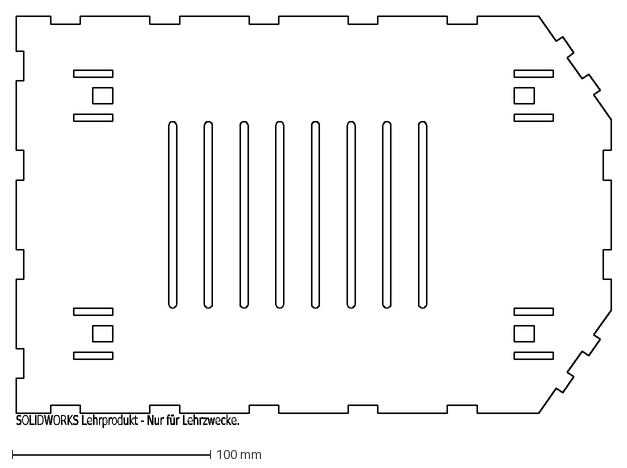
[picture p89: CAD file, 2019-12-10]
2. Konstruktion/CAD/DXF Datei/Gehäuseunterteil.DXF
SOLIDWORKS Lehrprodukt - Nur für Lehrzwecke.
