MartinSchafferer/Sensorik_MarsRover/2. Konstruktion/CAD/Innenzahnrad.SLDPRT

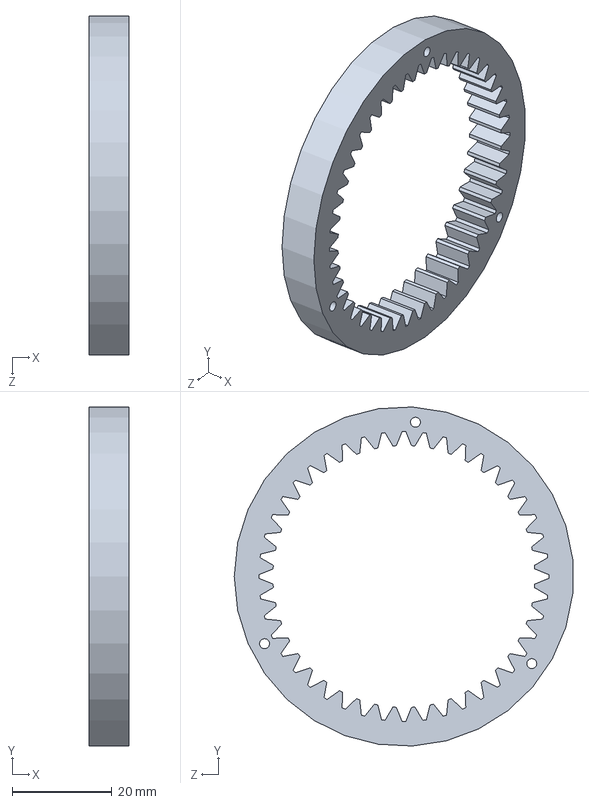
[picture p90: CAD file, 2019-12-10]
2. Konstruktion/CAD/Innenzahnrad.SLDPRT
8.00 x 67.9 x 67.8 mm
