MartinSchafferer/Sensorik_MarsRover/2. Konstruktion/CAD/DXF Datei/ZweiterBoden.DXF

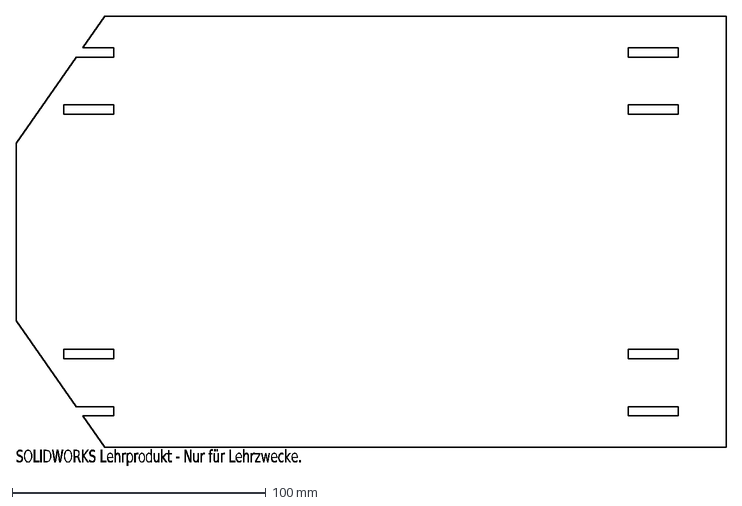
[picture p91: CAD file, 2019-12-10]
2. Konstruktion/CAD/DXF Datei/ZweiterBoden.DXF
SOLIDWORKS Lehrprodukt - Nur für Lehrzwecke.
