MartinSchafferer/Sensorik_MarsRover/2. Konstruktion/CAD/DXF Datei/Wasserschutz.DXF

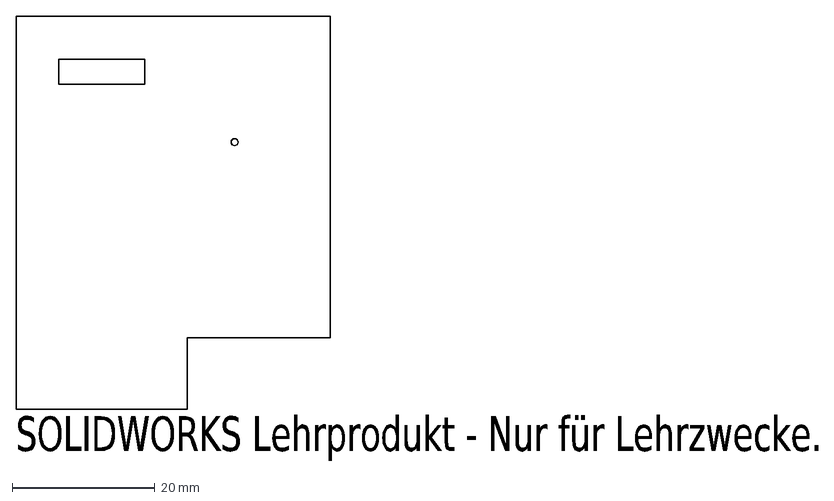
[picture p92: CAD file, 2019-12-10]
2. Konstruktion/CAD/DXF Datei/Wasserschutz.DXF
SOLIDWORKS Lehrprodukt - Nur für Lehrzwecke.
