MartinSchafferer/Sensorik_MarsRover/2. Konstruktion/CAD/Gehause_hinten.SLDPRT

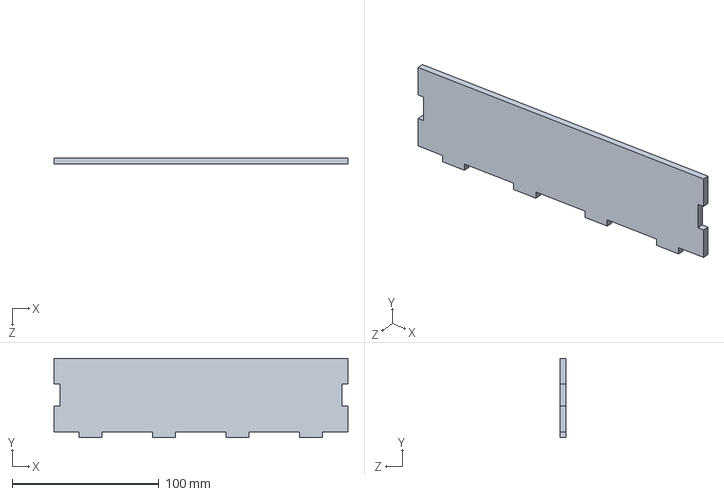
[picture p93: CAD file, 2019-12-10]
2. Konstruktion/CAD/Gehause_hinten.SLDPRT
200.0 x 54.0 x 4.00 mm
