MartinSchafferer/Sensorik_MarsRover/2. Konstruktion/CAD/Abstandshülse.SLDPRT

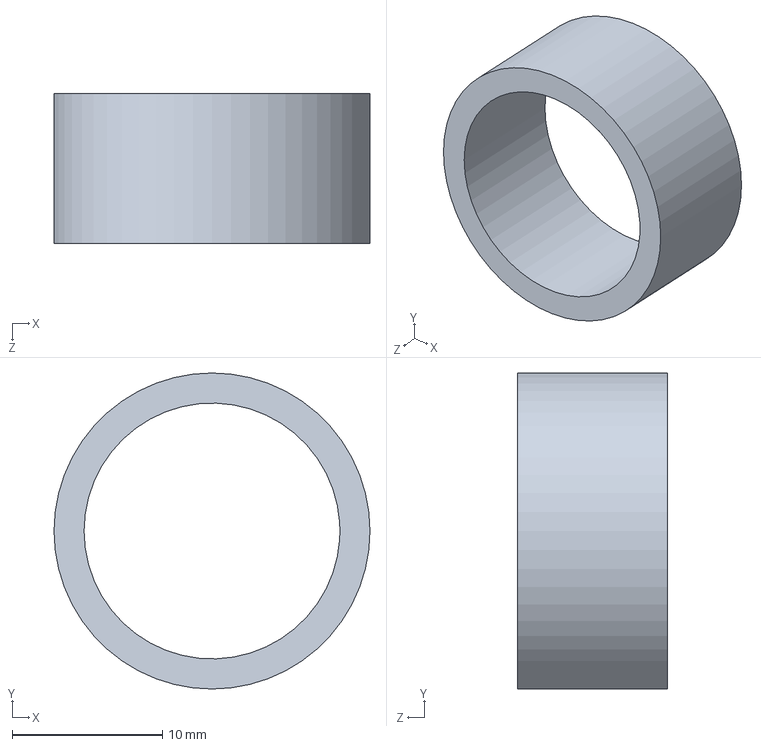
[picture p94: CAD file, 2019-12-10]
2. Konstruktion/CAD/Abstandshülse.SLDPRT
21.0 x 21.0 x 10.0 mm
