MartinSchafferer/Sensorik_MarsRover/2. Konstruktion/CAD/Radfelge.SLDPRT

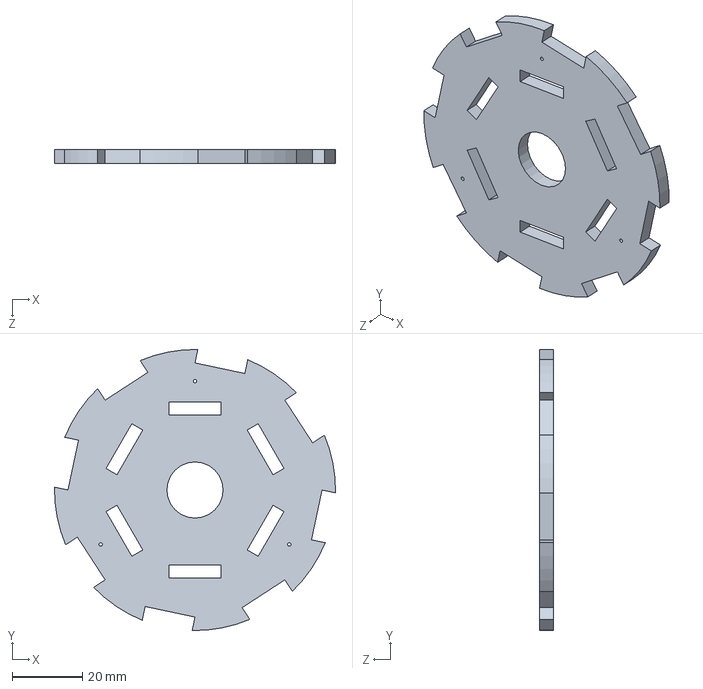
[picture p95: CAD file, 2019-12-10]
2. Konstruktion/CAD/Radfelge.SLDPRT
80.0 x 80.0 x 4.00 mm
