MartinSchafferer/Sensorik_MarsRover/2. Konstruktion/CAD/Wasserschutz.SLDPRT

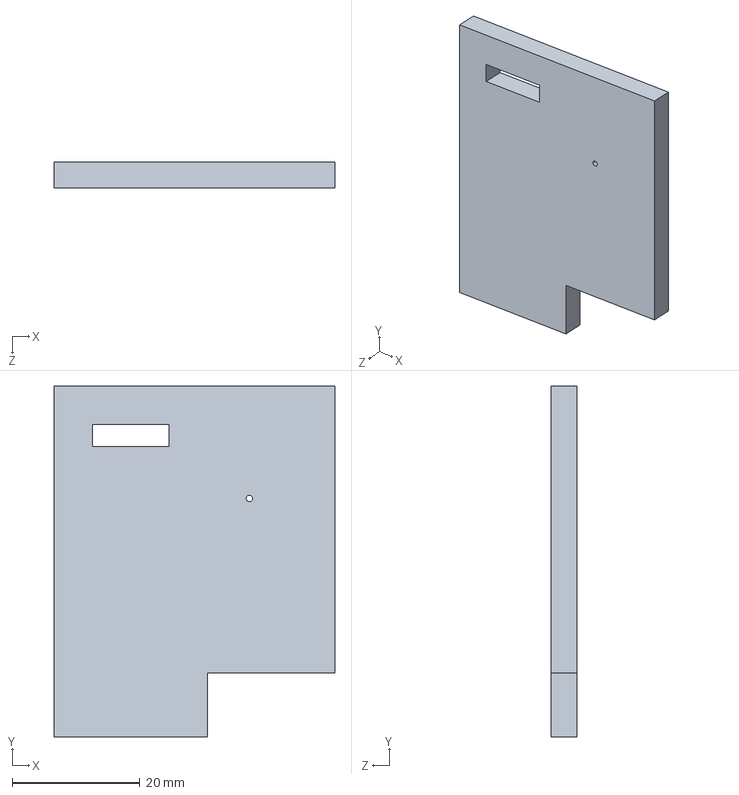
[picture p96: CAD file, 2019-12-10]
2. Konstruktion/CAD/Wasserschutz.SLDPRT
44.0 x 55.0 x 4.00 mm
