MartinSchafferer/Sensorik_MarsRover/2. Konstruktion/CAD/Gehäuse_seite.SLDPRT

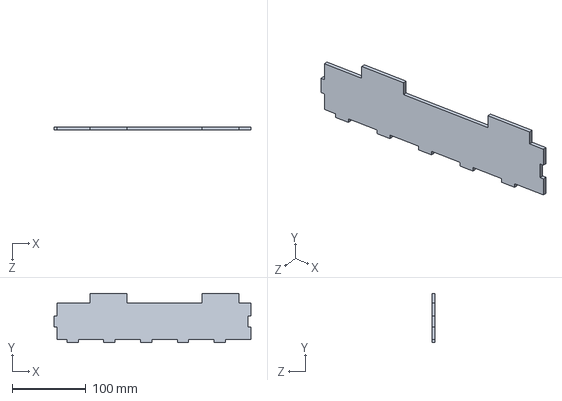
[picture p97: CAD file, 2019-12-10]
2. Konstruktion/CAD/Gehäuse_seite.SLDPRT
267.6 x 67.0 x 4.00 mm
