MartinSchafferer/Sensorik_MarsRover/2. Konstruktion/CAD/CAMERA PI COM LENTE.SLDPRT

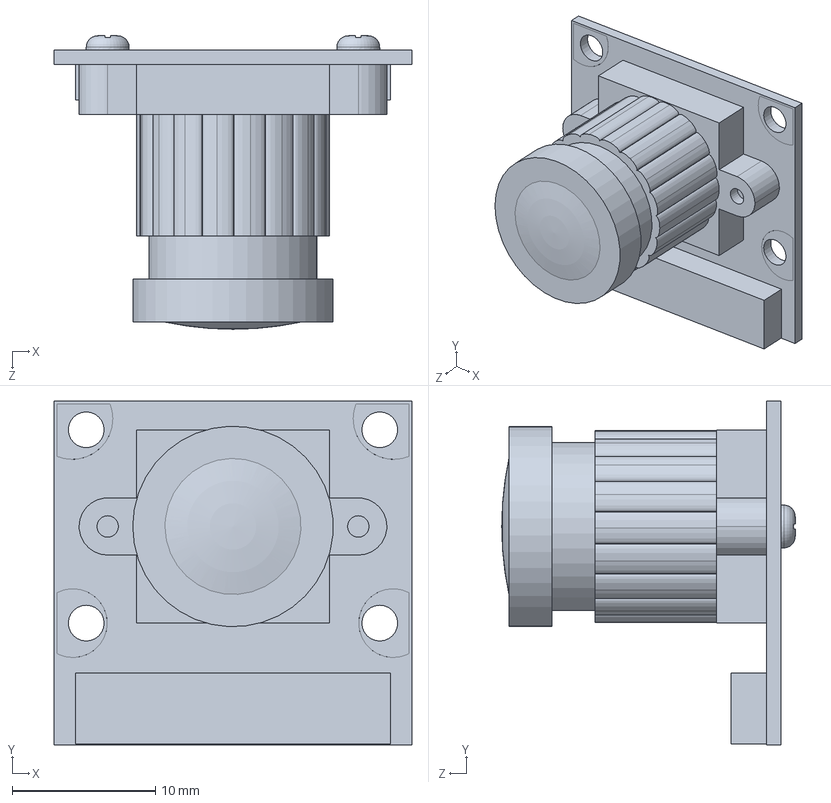
[picture p98: CAD file, 2019-12-10]
2. Konstruktion/CAD/CAMERA PI COM LENTE.SLDPRT
25.0 x 24.0 x 20.5 mm
