MartinSchafferer/Sensorik_MarsRover/2. Konstruktion/CAD/Gehäuseunterteil.SLDPRT

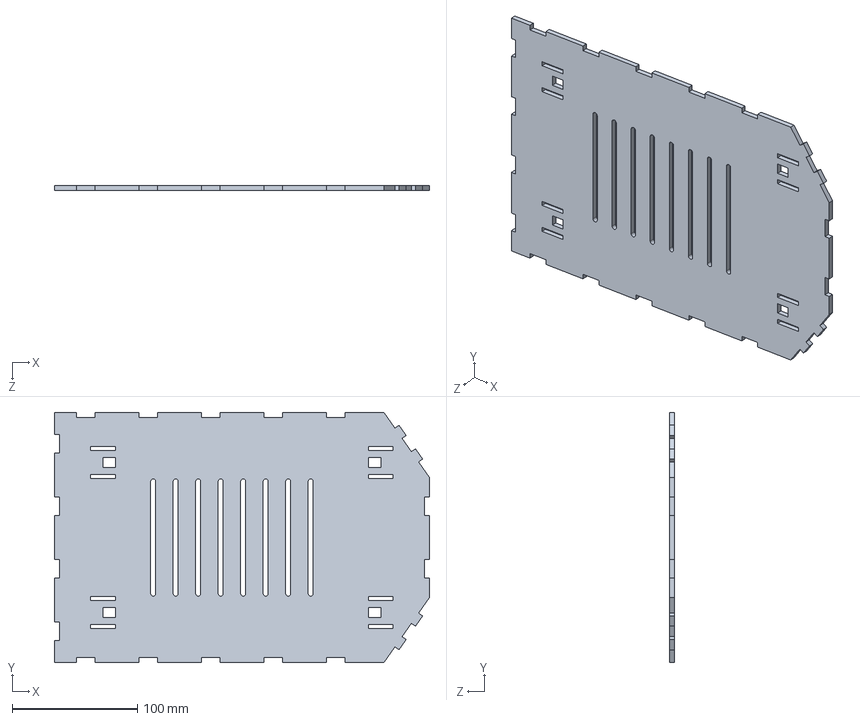
[picture p99: CAD file, 2019-12-10]
2. Konstruktion/CAD/Gehäuseunterteil.SLDPRT
300.0 x 200.0 x 4.00 mm
