MartinSchafferer/Sensorik_MarsRover/2. Konstruktion/CAD/spur gear_iso_geaendert.sldprt

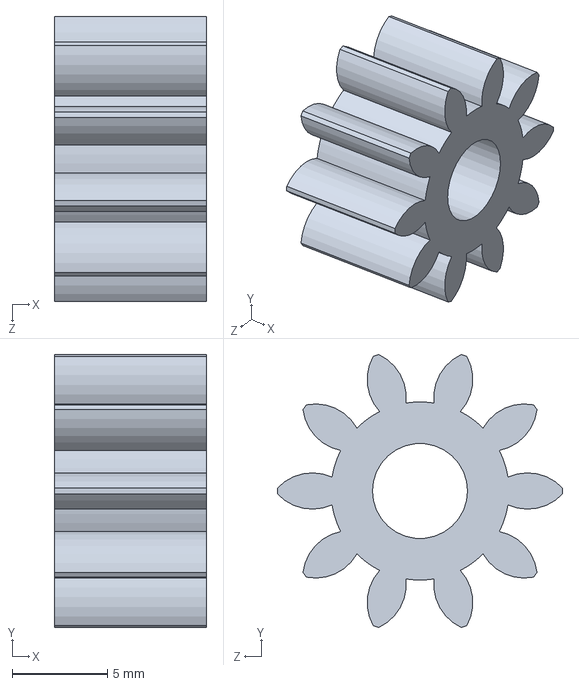
[picture p100: CAD file, 2019-12-10]
2. Konstruktion/CAD/spur gear_iso_geaendert.sldprt
8.00 x 14.4 x 15.0 mm
