MartinSchafferer/Sensorik_MarsRover/2. Konstruktion/CAD/Lochscheibe.SLDPRT

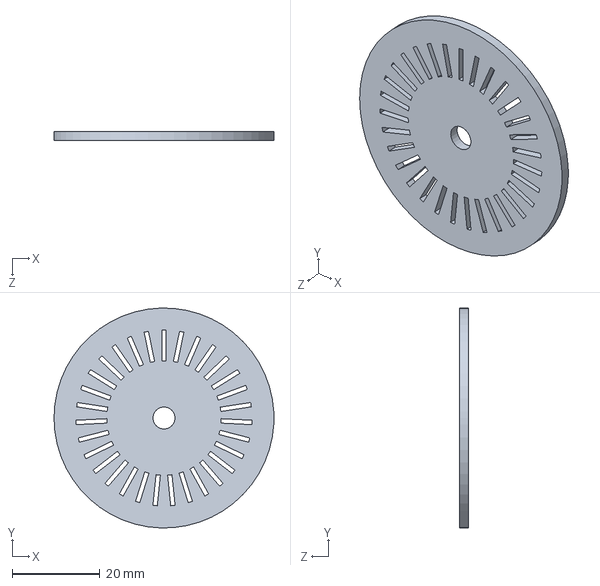
[picture p101: CAD file, 2019-12-10]
2. Konstruktion/CAD/Lochscheibe.SLDPRT
50.0 x 50.0 x 2.00 mm
