MartinSchafferer/Sensorik_MarsRover/2. Konstruktion/CAD/Radauflager.SLDPRT

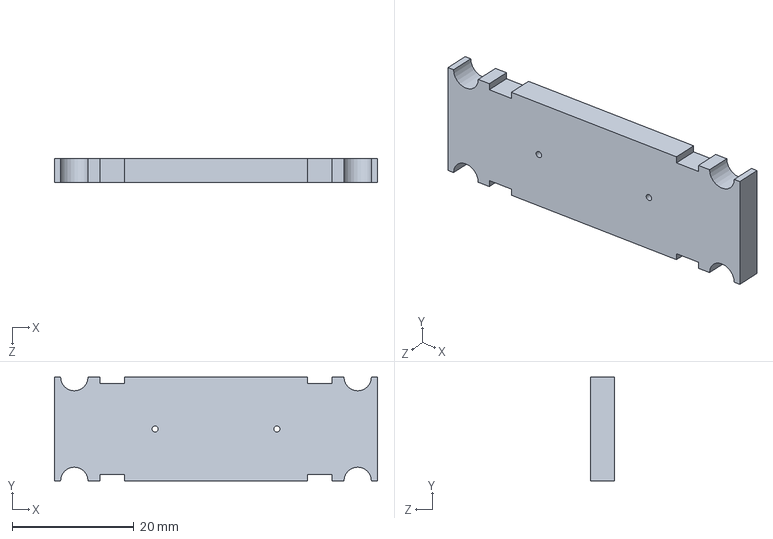
[picture p102: CAD file, 2019-12-10]
2. Konstruktion/CAD/Radauflager.SLDPRT
53.0 x 17.0 x 4.00 mm
