MartinSchafferer/Sensorik_MarsRover/2. Konstruktion/CAD/Zahnrad_Sensoren.SLDPRT

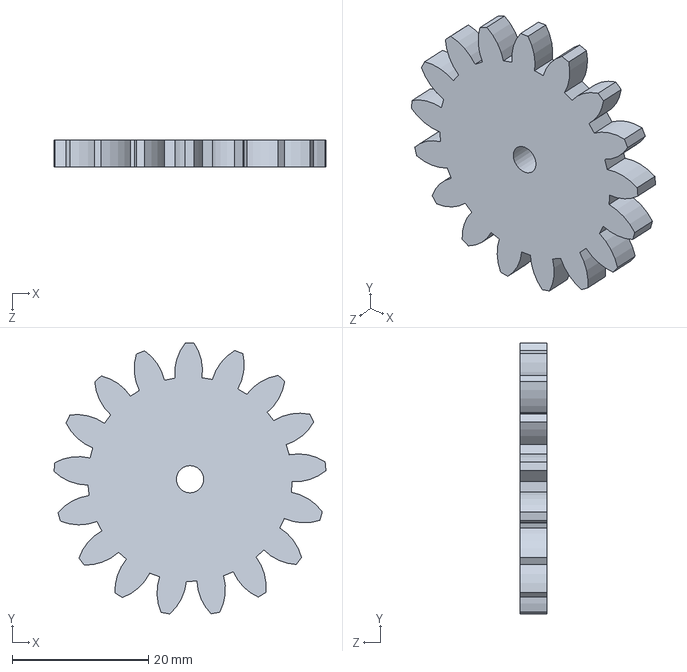
[picture p103: CAD file, 2019-12-10]
2. Konstruktion/CAD/Zahnrad_Sensoren.SLDPRT
39.9 x 39.8 x 4.00 mm
