MartinSchafferer/Sensorik_MarsRover/2. Konstruktion/CAD/Passungslehre2.SLDPRT

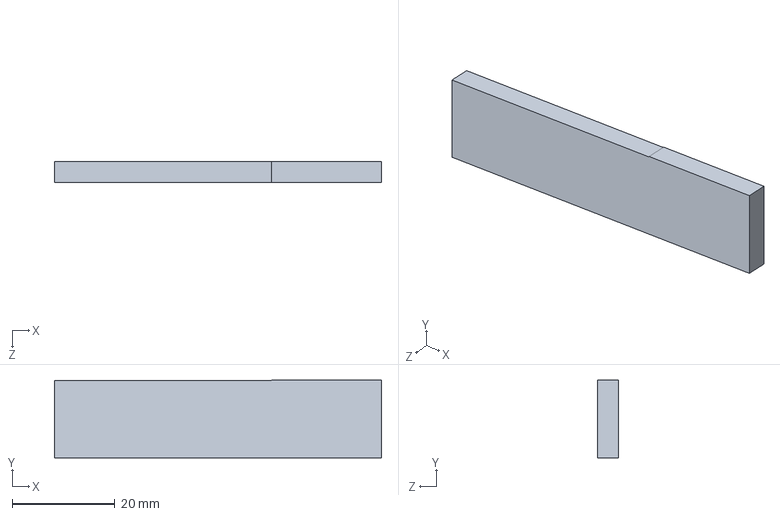
[picture p104: CAD file, 2019-12-10]
2. Konstruktion/CAD/Passungslehre2.SLDPRT
63.5 x 15.1 x 4.00 mm
