MartinSchafferer/Sensorik_MarsRover/2. Konstruktion/CAD/Brücke.SLDPRT

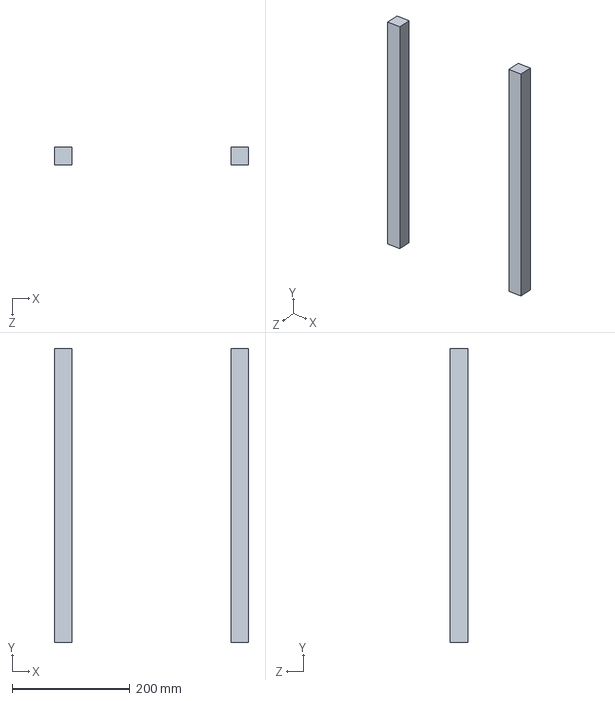
[picture p105: CAD file, 2019-12-10]
2. Konstruktion/CAD/Brücke.SLDPRT
330.0 x 500.0 x 30.0 mm
