MartinSchafferer/Sensorik_MarsRover/2. Konstruktion/CAD/Radaufhängung.SLDPRT

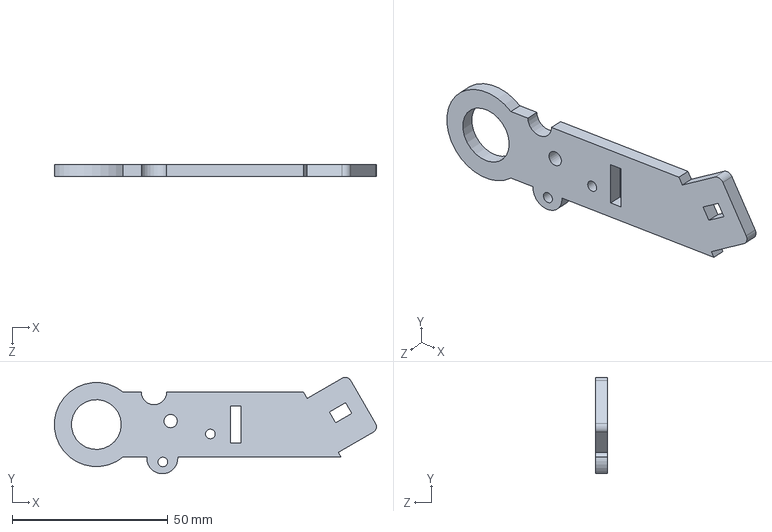
[picture p106: CAD file, 2019-12-10]
2. Konstruktion/CAD/Radaufhängung.SLDPRT
103.4 x 30.9 x 4.00 mm
