MartinSchafferer/Sensorik_MarsRover/2. Konstruktion/CAD/Radverlängerung.SLDPRT

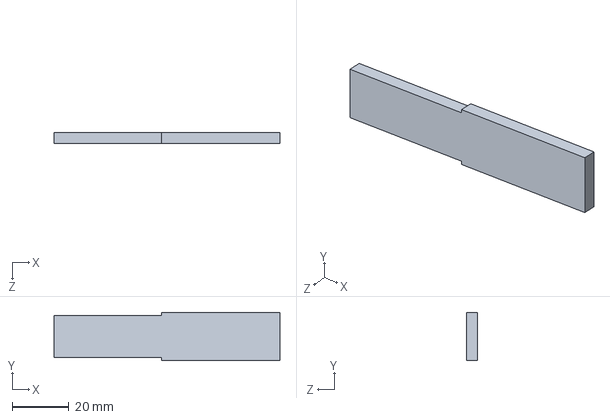
[picture p107: CAD file, 2019-12-10]
2. Konstruktion/CAD/Radverlängerung.SLDPRT
80.0 x 17.0 x 4.00 mm
