MartinSchafferer/Sensorik_MarsRover/2. Konstruktion/CAD/Seitenteil_Gehäuse.SLDPRT

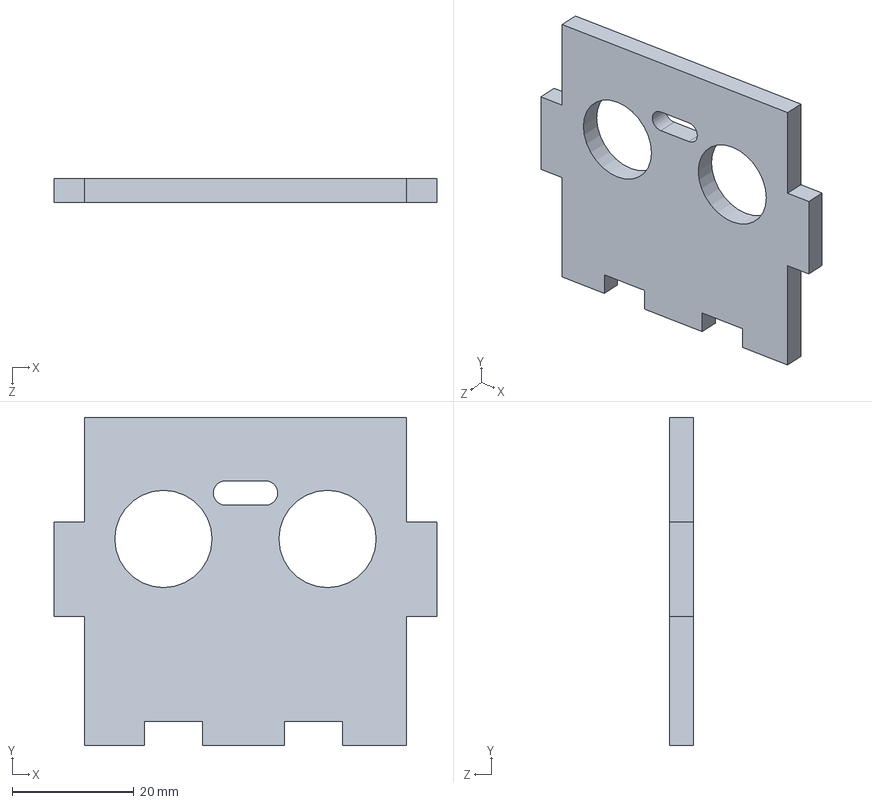
[picture p108: CAD file, 2019-12-10]
2. Konstruktion/CAD/Seitenteil_Gehäuse.SLDPRT
63.0 x 54.0 x 4.00 mm
