MartinSchafferer/Sensorik_MarsRover/(list of files, cad)

Other CAD files:
2. Konstruktion/CAD/Zahnrad_klein.SLDPRT
2. Konstruktion/CAD/Abstandshülse.SLDDRW
2. Konstruktion/CAD/Lagerbolzen.SLDDRW
2. Konstruktion/CAD/Marsrover_gesamt.SLDDRW
