MartinSchafferer/Sensorik_MarsRover/5. Fotos/Lochbild-Platinenmontage.jpg

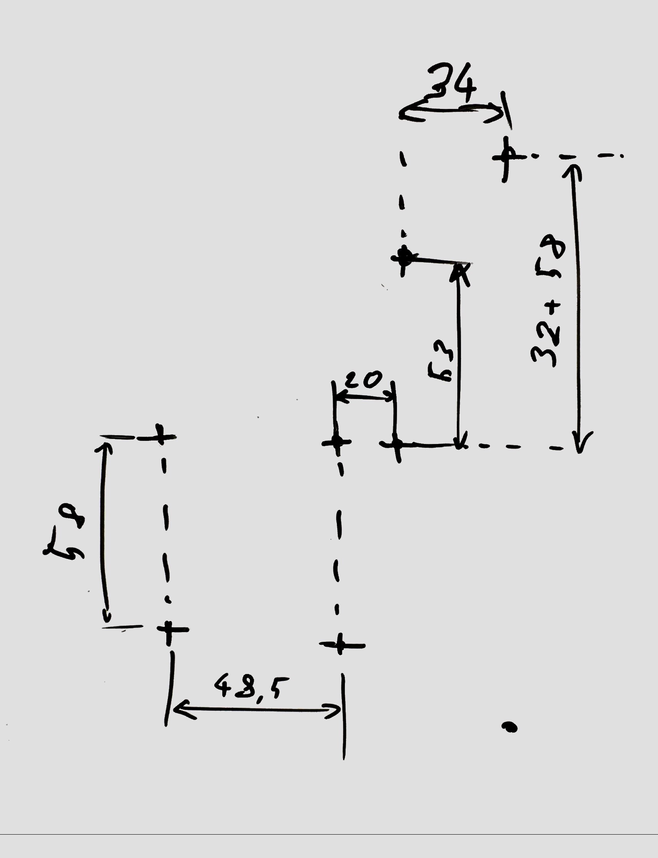
5. Fotos/Lochbild-Platinenmontage.jpg
