MartinSchafferer/Sensorik_MarsRover/Projektplan Mars Rover Challenge.pdf

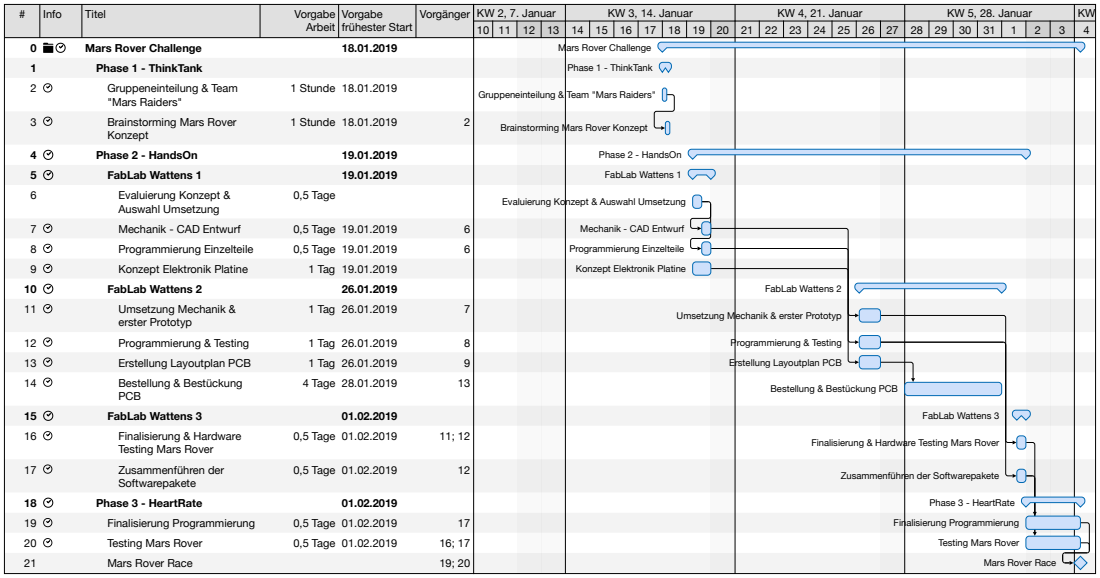
[picture p110: page 1]
Info; Titel; Vorgabe; Arbeit; Vorgabe frühester Start; Vorgänger; KW 2, 7. Januar; KW 3, 14. Januar; KW 4, 21. Januar; KW 5, 28. Januar; KW 6, 4. Februar

0 Mars Rover Challenge 18.01.2019 | Mars Rover Challenge
1 Phase 1 - ThinkTank | | Phase 1 - ThinkTank
2 Gruppeneinteilung & Team 1 Stunde 18.01.2019 "Mars Raiders" | Gruppeneinteilung & Team "Mars Raiders"

3 Brainstorming Mars Rover 1 Stunde 18.01.2019 2 Konzept | Brainstorming Mars Rover Konzept

4 Phase 2 - HandsOn 19.01.2019 | | Phase 2 - HandsOn
5 FabLab Wattens 1 19.01.2019 | | FabLab Wattens 1
6 Evaluierung Konzept & 0,5 Tage Auswahl Umsetzung | Evaluierung Konzept & Auswahl Umsetzung

7 Mechanik - CAD Entwurf 0,5 Tage 19.01.2019 6 | | Mechanik - CAD Entwurf
8 Programmierung Einzelteile 0,5 Tage 19.01.2019 6 | | Programmierung Einzelteile
9 Konzept Elektronik Platine 1 Tag 19.01.2019 | | Konzept Elektronik Platine
10 FabLab Wattens 2 26.01.2019 | | | FabLab Wattens 2
11 Umsetzung Mechanik & 1 Tag 26.01.2019 7 erster Prototyp | | Umsetzung Mechanik & erster Prototyp

12 Programmierung & Testing 1 Tag 26.01.2019 8 | | Programmierung & Testing
13 Erstellung Layoutplan PCB 1 Tag 26.01.2019 9 | | Erstellung Layoutplan PCB
14 Bestellung & Bestückung 4 Tage 28.01.2019 13 PCB | | | Bestellung & Bestückung PCB

15 FabLab Wattens 3 01.02.2019 | | | | FabLab Wattens 3
16 Finalisierung & Hardware 0,5 Tage 01.02.2019 11; 12 Testing Mars Rover | | | Finalisierung & Hardware Testing Mars Rover

17 Zusammenführen der 0,5 Tage 01.02.2019 12 Softwarepakete | | | Zusammenführen der Softwarepakete

18 Phase 3 - HeartRate 01.02.2019 | | | | Phase 3 - HeartRate
19 Finalisierung Programmierung 0,5 Tage 01.02.2019 17 | | | Finalisierung Programmierung
20 Testing Mars Rover 0,5 Tage 01.02.2019 16; 17 | | | | Testing Mars Rover
21 Mars Rover Race 19; 20 | | | | Mars Rover Race
