MartinSchafferer/Sensorik_MarsRover/2. Konstruktion/CAD/PDFs/Abstandshülse.PDF

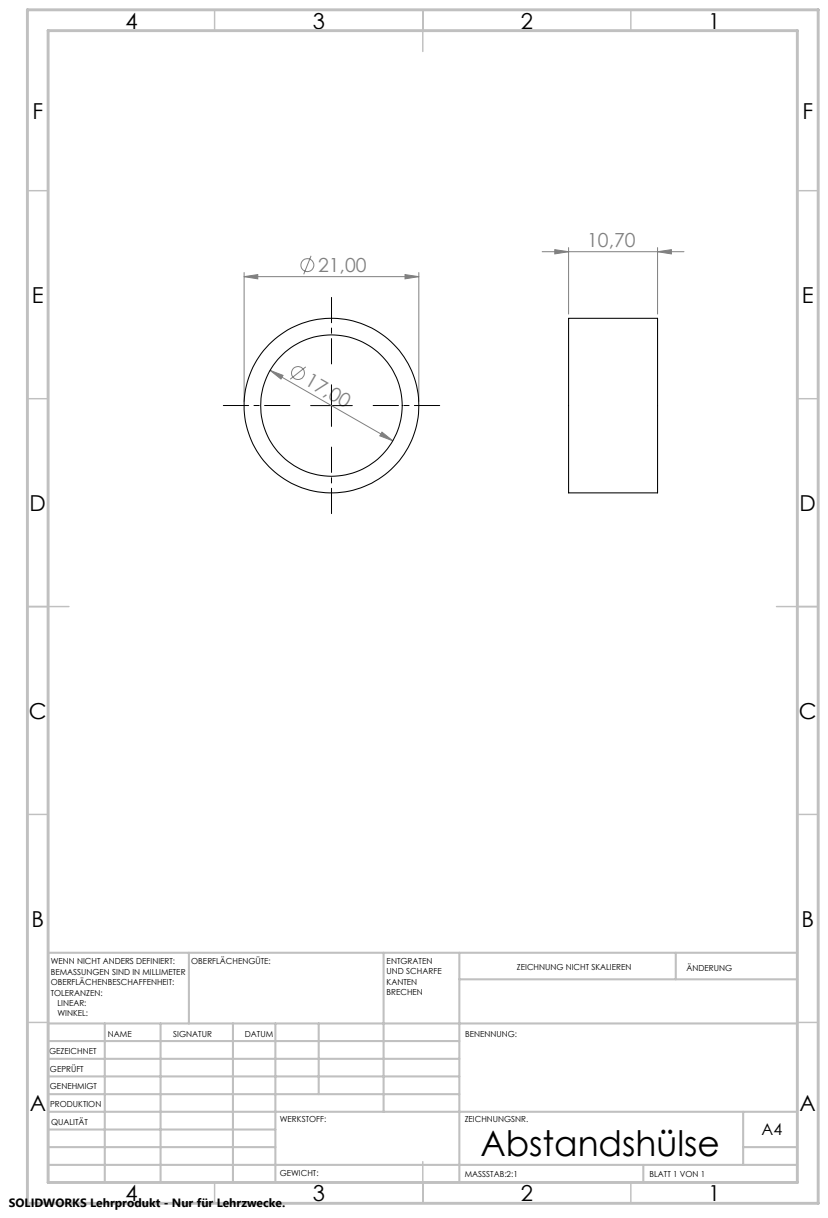
[picture p111: page 1]
MASSSTAB:2:1; BLATT 1 VON 1; ZEICHNUNG NICHT SKALIEREN; ÄNDERUNG; UND SCHARFE; WENN NICHT ANDERS DEFINIERT:; OBERFLÄCHENGÜTE:

BEMASSUNGEN SIND IN MILLIMETER
OBERFLÄCHENBESCHAFFENHEIT:
TOLERANZEN:
LINEAR:
WINKEL:

NAME | SIGNATUR | DATUM | | | | BENENNUNG:
QUALITÄT | | | | WERKSTOFF: | ZEICHNUNGSNR. Abstandshülse GEWICHT: | A4

GEZEICHNET
GEPRÜFT
GENEHMIGT
PRODUKTION

SOLIDWORKS Lehrprodukt - Nur für Lehrzwecke.
