MartinSchafferer/Sensorik_MarsRover/3. Elektronik/Rover/MarsRover/Rover_PCB_2019-02-01.brd

## EAGLE design 3. Elektronik/Rover/MarsRover/Rover_PCB_2019-02-01.brd (2019-12-10)

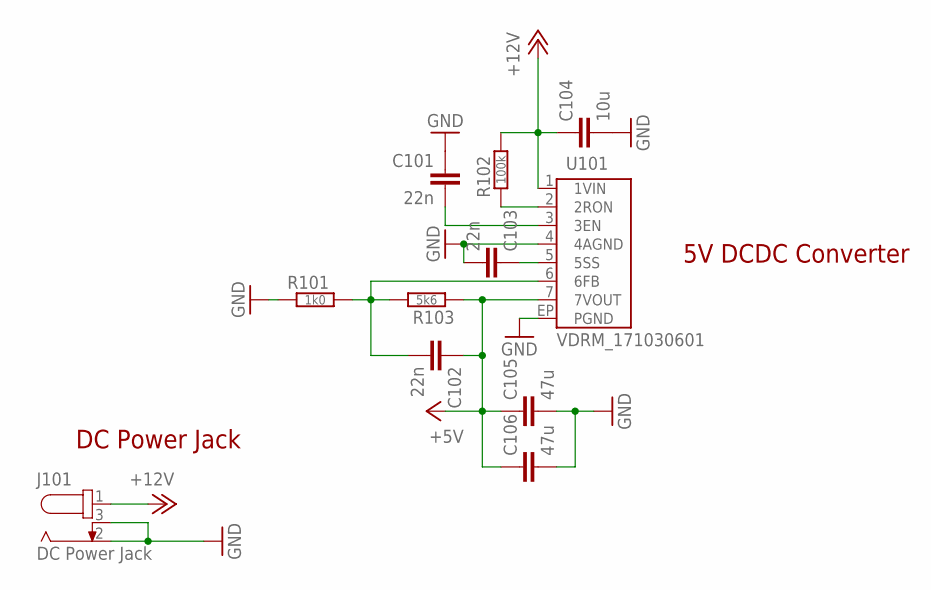
[picture p112: schematic Rover_PCB_2019-02-01.sch, sheet 1]

Parts:
C101, C102, C103: 22n; CAPC2012X95N
C104: 10u; CAP-US1210-EU3225
C105, C106: 47u; CAP-US1210-EU3225
J101: DC Power Jack; 69410X105102
R101: 1k0; RESC2012X50N
R102: 100k; RESC2012X50N
R103: 5k6; RESC2012X50N
U101: VDRM_171030601; VDRM_7PIN-PFM

Connections:
+5V: C102.1, C105.1, C106.1, R103.1, U101.7 (7VOUT); also elsewhere on the board
+12V: C104.1, J101.1, R102.2, U101.1 (1VIN); also elsewhere on the board
GND: C101.1, C103.2, C104.2, C105.2, C106.2, J101.2, J101.3, R101.1, U101.4 (4AGND), U101.EP (PGND); also elsewhere on the board
unnamed: R102.1, U101.2 (2RON)
unnamed: C103.1, U101.5 (5SS)
unnamed: C102.2, R101.2, R103.2, U101.6 (6FB)
unnamed: C101.2, U101.3 (3EN)

Notes on the sheet:
5V DCDC Converter
DC Power Jack

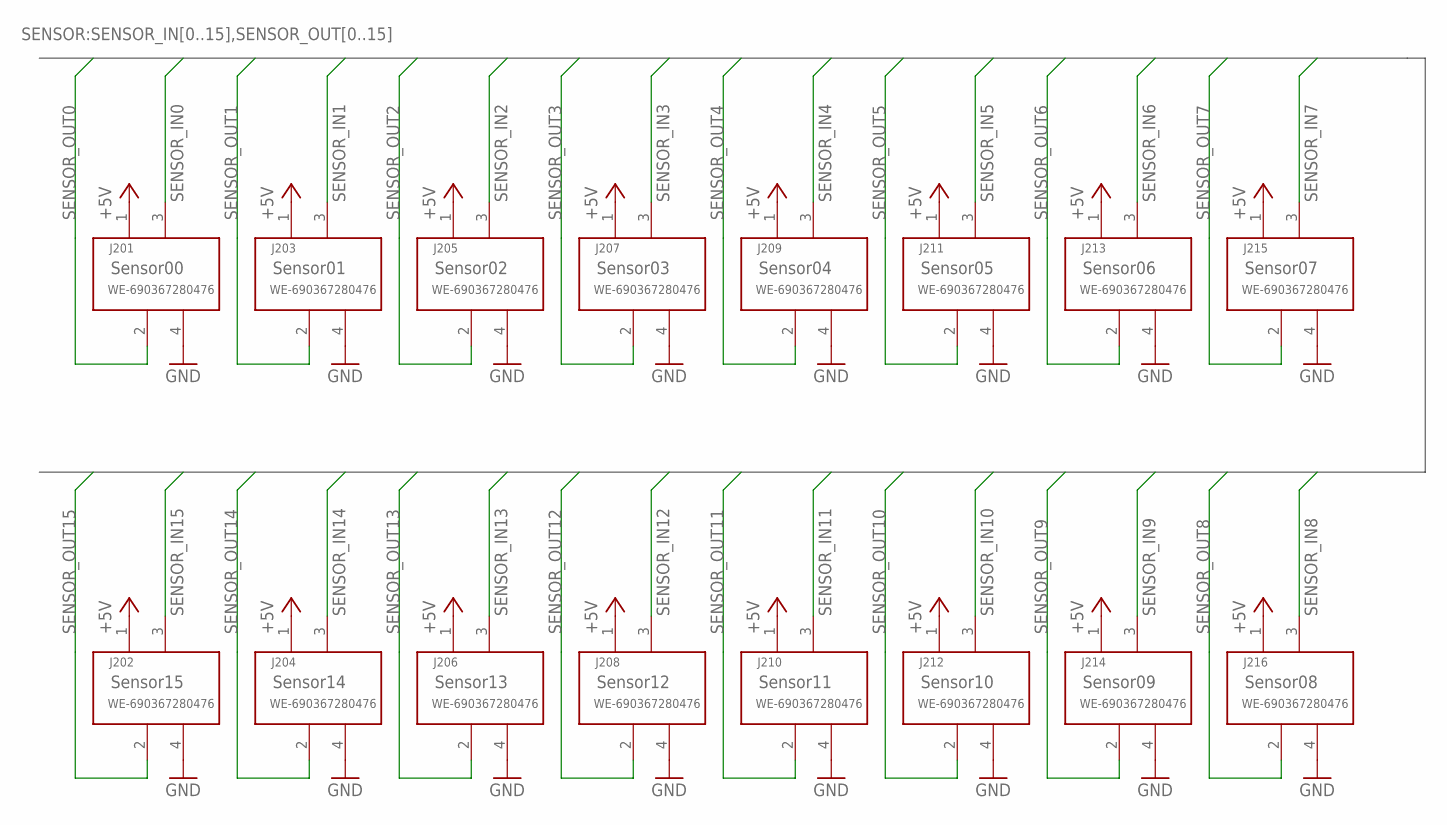
[picture p113: schematic Rover_PCB_2019-02-01.sch, sheet 2]

Parts:
J201, J202, J203, J204, J205, J206, J207, J208, J209, J210, J211, J212, J213, J214, J215, J216: WE-690367280476; 690367280476

Connections:
+5V: J201.1 (4), J202.1 (4), J203.1 (4), J204.1 (4), J205.1 (4), J206.1 (4), J207.1 (4), J208.1 (4), J209.1 (4), J210.1 (4), J211.1 (4), J212.1 (4), J213.1 (4), J214.1 (4), J215.1 (4), J216.1 (4); also elsewhere on the board
GND: J201.4 (1), J202.4 (1), J203.4 (1), J204.4 (1), J205.4 (1), J206.4 (1), J207.4 (1), J208.4 (1), J209.4 (1), J210.4 (1), J211.4 (1), J212.4 (1), J213.4 (1), J214.4 (1), J215.4 (1), J216.4 (1); also elsewhere on the board
SENSOR_IN0: J201.3 (2); also elsewhere on the board
SENSOR_IN1: J203.3 (2); also elsewhere on the board
SENSOR_IN2: J205.3 (2); also elsewhere on the board
SENSOR_IN3: J207.3 (2); also elsewhere on the board
SENSOR_IN4: J209.3 (2); also elsewhere on the board
SENSOR_IN5: J211.3 (2); also elsewhere on the board
SENSOR_IN6: J213.3 (2); also elsewhere on the board
SENSOR_IN7: J215.3 (2); also elsewhere on the board
SENSOR_IN8: J216.3 (2); also elsewhere on the board
SENSOR_IN9: J214.3 (2); also elsewhere on the board
SENSOR_IN10: J212.3 (2); also elsewhere on the board
SENSOR_IN11: J210.3 (2); also elsewhere on the board
SENSOR_IN12: J208.3 (2); also elsewhere on the board
SENSOR_IN13: J206.3 (2); also elsewhere on the board
SENSOR_IN14: J204.3 (2); also elsewhere on the board
SENSOR_IN15: J202.3 (2); also elsewhere on the board
SENSOR_OUT0: J201.2 (3); also elsewhere on the board
SENSOR_OUT1: J203.2 (3); also elsewhere on the board
SENSOR_OUT2: J205.2 (3); also elsewhere on the board
SENSOR_OUT3: J207.2 (3); also elsewhere on the board
SENSOR_OUT4: J209.2 (3); also elsewhere on the board
SENSOR_OUT5: J211.2 (3); also elsewhere on the board
SENSOR_OUT6: J213.2 (3); also elsewhere on the board
SENSOR_OUT7: J215.2 (3); also elsewhere on the board
SENSOR_OUT8: J216.2 (3); also elsewhere on the board
SENSOR_OUT9: J214.2 (3); also elsewhere on the board
SENSOR_OUT10: J212.2 (3); also elsewhere on the board
SENSOR_OUT11: J210.2 (3); also elsewhere on the board
SENSOR_OUT12: J208.2 (3); also elsewhere on the board
SENSOR_OUT13: J206.2 (3); also elsewhere on the board
SENSOR_OUT14: J204.2 (3); also elsewhere on the board
SENSOR_OUT15: J202.2 (3); also elsewhere on the board

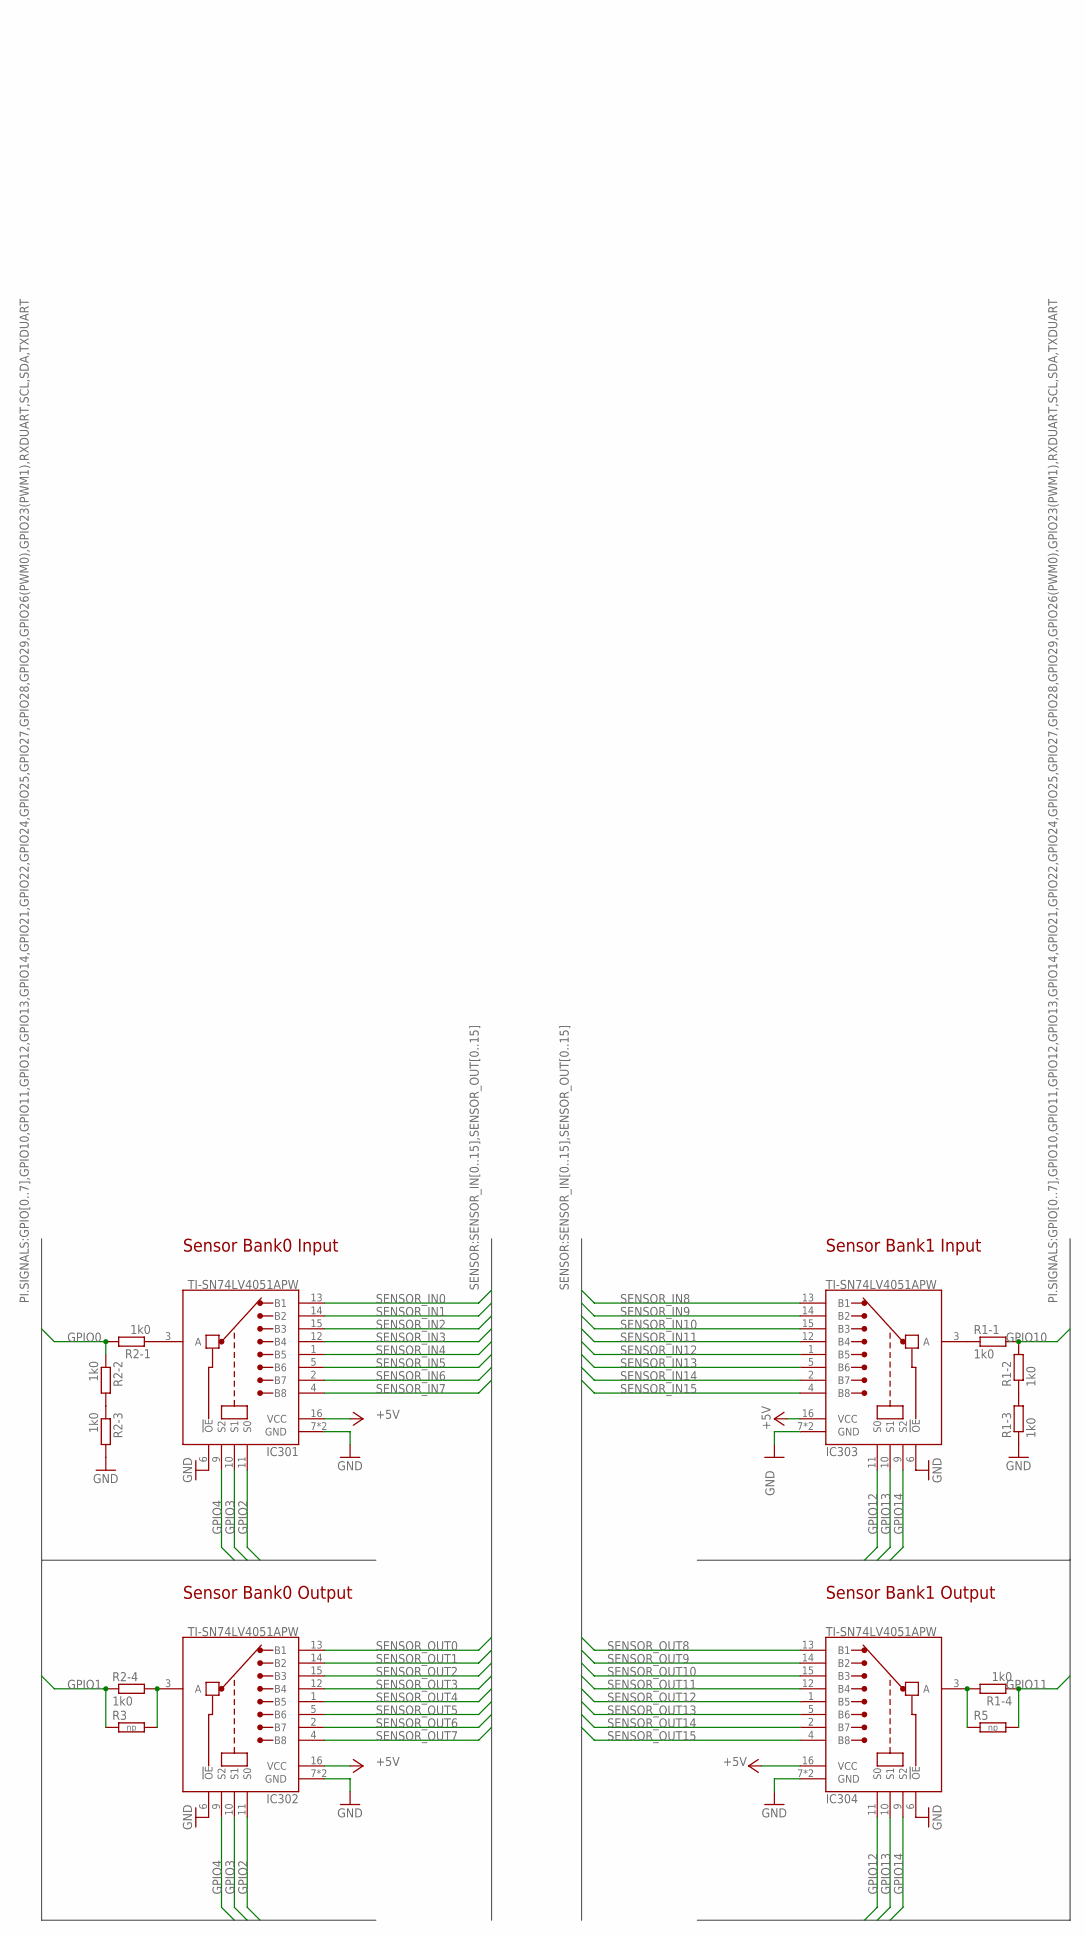
[picture p114: schematic Rover_PCB_2019-02-01.sch, sheet 3]

Parts:
IC301, IC302, IC303, IC304: TI-SN74LV4051APW; SOP16P65_500X640X120L62X24L
R1, R2: 1k0; CAPCAF80P160X320X70-8L
R3, R5: np; RESC2012X50N

Connections:
+5V: IC301.16 (VCC), IC302.16 (VCC), IC303.16 (VCC), IC304.16 (VCC); also elsewhere on the board
GND: IC301.6 (!OE), IC301.7 (GND), IC301.8 (GND), IC302.6 (!OE), IC302.7 (GND), IC302.8 (GND), IC303.6 (!OE), IC303.7 (GND), IC303.8 (GND), IC304.6 (!OE), IC304.7 (GND), IC304.8 (GND), R1.3 (1), R2.6 (2); also elsewhere on the board
GPIO0: R2.2 (1), R2.8 (2); also elsewhere on the board
GPIO1: R2.4 (1), R3.1; also elsewhere on the board
GPIO2: IC301.11 (S0), IC302.11 (S0); also elsewhere on the board
GPIO3: IC301.10 (S1), IC302.10 (S1); also elsewhere on the board
GPIO4: IC301.9 (S2), IC302.9 (S2); also elsewhere on the board
GPIO10: R1.7 (2), R1.8 (2); also elsewhere on the board
GPIO11: R1.4 (1), R5.2; also elsewhere on the board
GPIO12: IC303.11 (S0), IC304.11 (S0); also elsewhere on the board
GPIO13: IC303.10 (S1), IC304.10 (S1); also elsewhere on the board
GPIO14: IC303.9 (S2), IC304.9 (S2); also elsewhere on the board
unnamed: R1.2 (1), R1.6 (2)
unnamed: IC302.3 (A), R2.5 (2), R3.2
unnamed: IC304.3 (A), R1.5 (2), R5.1
unnamed: R2.3 (1), R2.7 (2)
unnamed: IC301.3 (A), R2.1
unnamed: IC303.3 (A), R1.1
SENSOR_IN0: IC301.13 (B1); also elsewhere on the board
SENSOR_IN1: IC301.14 (B2); also elsewhere on the board
SENSOR_IN2: IC301.15 (B3); also elsewhere on the board
SENSOR_IN3: IC301.12 (B4); also elsewhere on the board
SENSOR_IN4: IC301.1 (B5); also elsewhere on the board
SENSOR_IN5: IC301.5 (B6); also elsewhere on the board
SENSOR_IN6: IC301.2 (B7); also elsewhere on the board
SENSOR_IN7: IC301.4 (B8); also elsewhere on the board
SENSOR_IN8: IC303.13 (B1); also elsewhere on the board
SENSOR_IN9: IC303.14 (B2); also elsewhere on the board
SENSOR_IN10: IC303.15 (B3); also elsewhere on the board
SENSOR_IN11: IC303.12 (B4); also elsewhere on the board
SENSOR_IN12: IC303.1 (B5); also elsewhere on the board
SENSOR_IN13: IC303.5 (B6); also elsewhere on the board
SENSOR_IN14: IC303.2 (B7); also elsewhere on the board
SENSOR_IN15: IC303.4 (B8); also elsewhere on the board
SENSOR_OUT0: IC302.13 (B1); also elsewhere on the board
SENSOR_OUT1: IC302.14 (B2); also elsewhere on the board
SENSOR_OUT2: IC302.15 (B3); also elsewhere on the board
SENSOR_OUT3: IC302.12 (B4); also elsewhere on the board
SENSOR_OUT4: IC302.1 (B5); also elsewhere on the board
SENSOR_OUT5: IC302.5 (B6); also elsewhere on the board
SENSOR_OUT6: IC302.2 (B7); also elsewhere on the board
SENSOR_OUT7: IC302.4 (B8); also elsewhere on the board
SENSOR_OUT8: IC304.13 (B1); also elsewhere on the board
SENSOR_OUT9: IC304.14 (B2); also elsewhere on the board
SENSOR_OUT10: IC304.15 (B3); also elsewhere on the board
SENSOR_OUT11: IC304.12 (B4); also elsewhere on the board
SENSOR_OUT12: IC304.1 (B5); also elsewhere on the board
SENSOR_OUT13: IC304.5 (B6); also elsewhere on the board
SENSOR_OUT14: IC304.2 (B7); also elsewhere on the board
SENSOR_OUT15: IC304.4 (B8); also elsewhere on the board

Notes on the sheet:
Sensor Bank0 Input
Sensor Bank0 Output
Sensor Bank1 Input
Sensor Bank1 Output

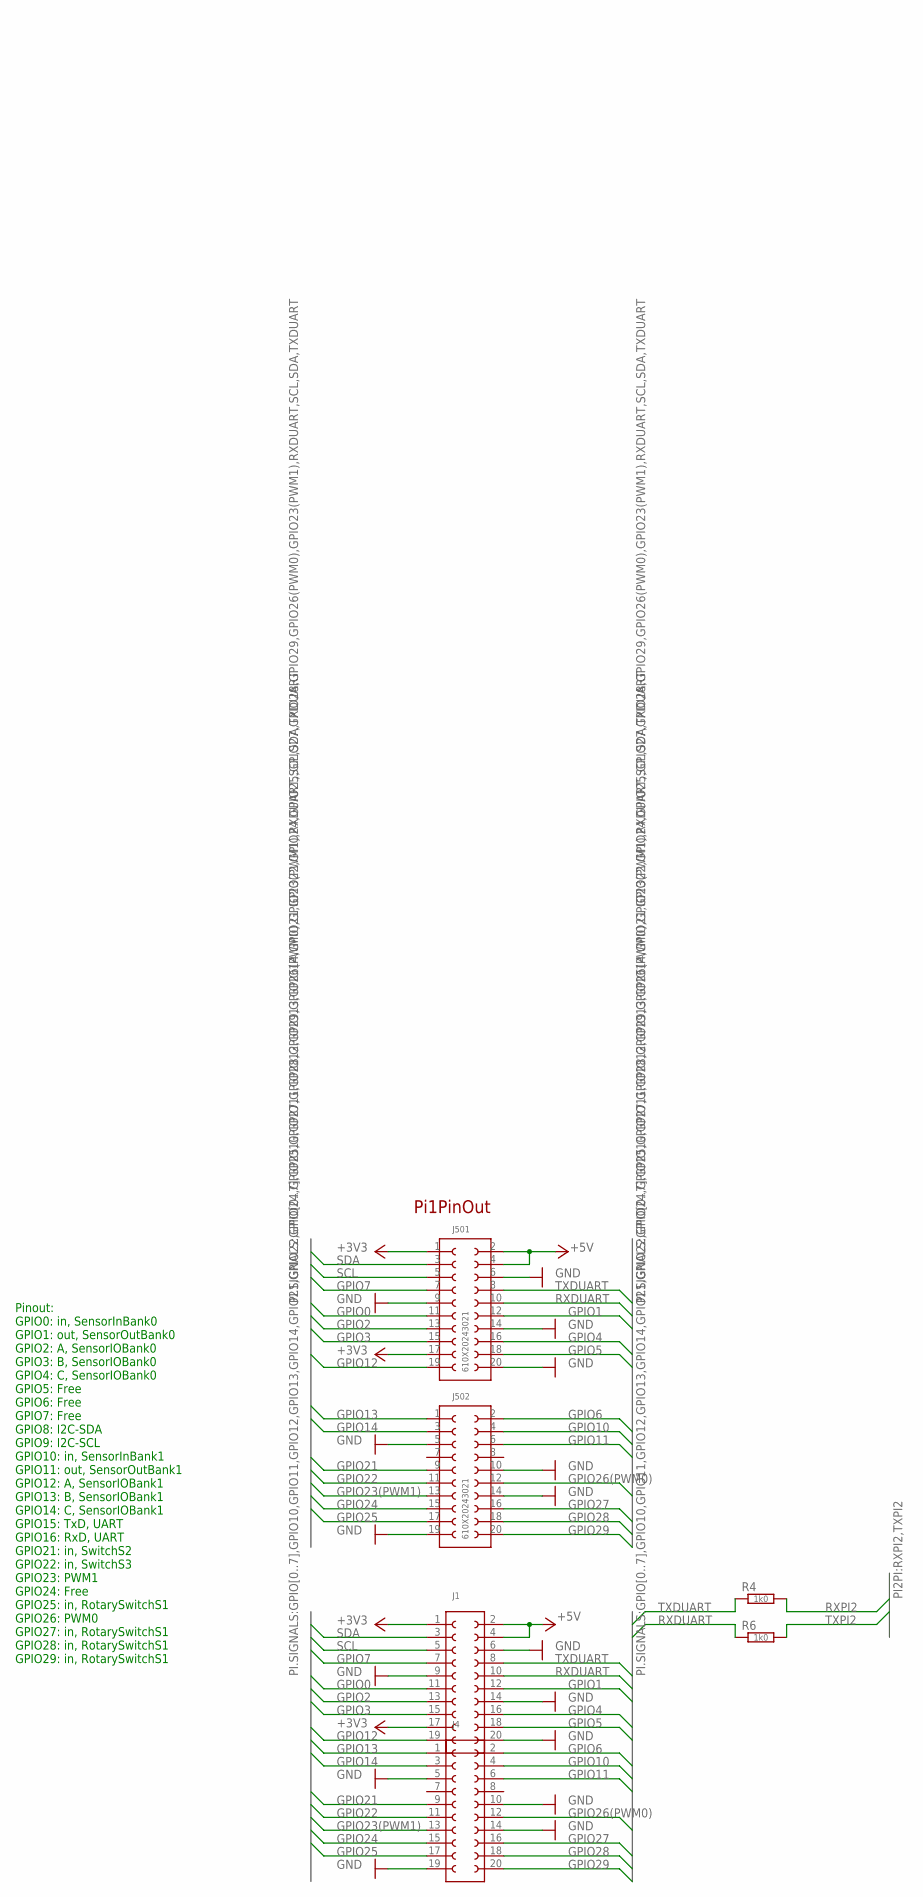
[picture p115: schematic Rover_PCB_2019-02-01.sch, sheet 4]

Parts:
J1, J4: 610X2021121
J501, J502: 610X20243021
R4, R6: 1k0; RESC2012X50N

Connections:
+3V3: J1.1, J1.17 (9), J501.1 (20), J501.17 (12); also elsewhere on the board
+5V: J1.2 (20), J1.4 (19), J501.2 (1), J501.4 (2); also elsewhere on the board
GND: J1.6 (18), J1.9 (5), J1.14, J1.20 (11), J4.5 (3), J4.10 (16), J4.14, J4.19 (10), J501.6 (3), J501.9 (16), J501.14 (7), J501.20 (10), J502.5 (18), J502.10 (5), J502.14 (7), J502.19 (11); also elsewhere on the board
GPIO0: J1.11 (6), J501.11 (15); also elsewhere on the board
GPIO1: J1.12 (15), J501.12 (6); also elsewhere on the board
GPIO2: J1.13 (7), J501.13 (14); also elsewhere on the board
GPIO3: J1.15 (8), J501.15 (13); also elsewhere on the board
GPIO4: J1.16 (13), J501.16 (8); also elsewhere on the board
GPIO5: J1.18 (12), J501.18 (9)
GPIO6: J4.2 (20), J502.2 (1)
GPIO7: J1.7 (4), J501.7 (17)
GPIO10: J4.4 (19), J502.4 (2); also elsewhere on the board
GPIO11: J4.6 (18), J502.6 (3); also elsewhere on the board
GPIO12: J1.19 (10), J501.19 (11); also elsewhere on the board
GPIO13: J4.1, J502.1 (20); also elsewhere on the board
GPIO14: J4.3 (2), J502.3 (19); also elsewhere on the board
GPIO21: J4.9 (5), J502.9 (16); also elsewhere on the board
GPIO22: J4.11 (6), J502.11 (15); also elsewhere on the board
GPIO23(PWM1): J4.13 (7), J502.13 (14); also elsewhere on the board
GPIO24: J4.15 (8), J502.15 (13)
GPIO25: J4.17 (9), J502.17 (12); also elsewhere on the board
GPIO26(PWM0): J4.12 (15), J502.12 (6); also elsewhere on the board
GPIO27: J4.16 (13), J502.16 (8); also elsewhere on the board
GPIO28: J4.18 (12), J502.18 (9); also elsewhere on the board
GPIO29: J4.20 (11), J502.20 (10); also elsewhere on the board
RXDUART: J1.10 (16), J501.10 (5), R6.1
RXPI2: R4.2; also elsewhere on the board
SCL: J1.5 (3), J501.5 (18); also elsewhere on the board
SDA: J1.3 (2), J501.3 (19); also elsewhere on the board
TXDUART: J1.8 (17), J501.8 (4), R4.1
TXPI2: R6.2; also elsewhere on the board

Notes on the sheet:
Pi1PinOut
Pinout: GPIO0: in, SensorInBank0 GPIO1: out, SensorOutBank0 GPIO2: A, SensorIOBank0 GPIO3: B, SensorIOBank0 GPIO4: C, SensorIOBank0 GPIO5: Free GPIO6: Free GPIO7: Free GPIO8: I2C-SDA GPIO9: I2C-SCL GPIO10: in, SensorInBank1 GPIO11: out, SensorOutBank1 GPIO12: A, SensorIOBank1 GPIO13: B, SensorIOBan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

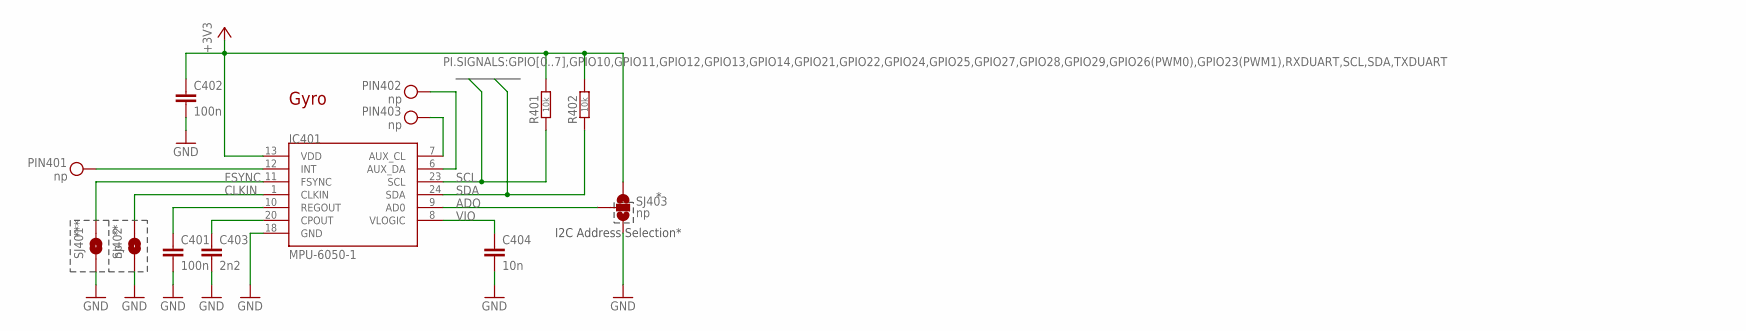
[picture p116: schematic Rover_PCB_2019-02-01.sch, sheet 5]

Parts:
C401, C402: 100n; CAPC2012X95N
C403: 2n2; CAPC2012X95N
C404: 10n; CAPC2012X95N
IC401: MPU-6050-1; QFN-24-4MM2
PIN401, PIN402, PIN403: np; SOLDER_PIN_0.5
R401, R402: 10k; RESC2012X50N
SJ401, SJ402: np; SJ_2S-TRACE
SJ403: np; SJ_3_PASTE1&2

Connections:
+3V3: C402.1, IC401.13 (VDD), R401.2, R402.2, SJ403.1; also elsewhere on the board
ADO: IC401.9 (AD0), SJ403.2
CLKIN: IC401.1 (CLKIN), SJ402.2
FSYNC: IC401.11 (FSYNC), SJ401.2
GND: C401.2, C402.2, C403.2, C404.2, IC401.18 (GND), SJ401.1, SJ402.1, SJ403.3; also elsewhere on the board
INT: IC401.12 (INT), PIN401._
unnamed: C403.1, IC401.20 (CPOUT)
unnamed: IC401.6 (AUX_DA), PIN402._
unnamed: C401.1, IC401.10 (REGOUT)
unnamed: IC401.7 (AUX_CL), PIN403._
SCL: IC401.23 (SCL), R401.1; also elsewhere on the board
SDA: IC401.24 (SDA), R402.1; also elsewhere on the board
VIO: C404.1, IC401.8 (VLOGIC)

Notes on the sheet:
I2C Address Selection*
***
Gyro

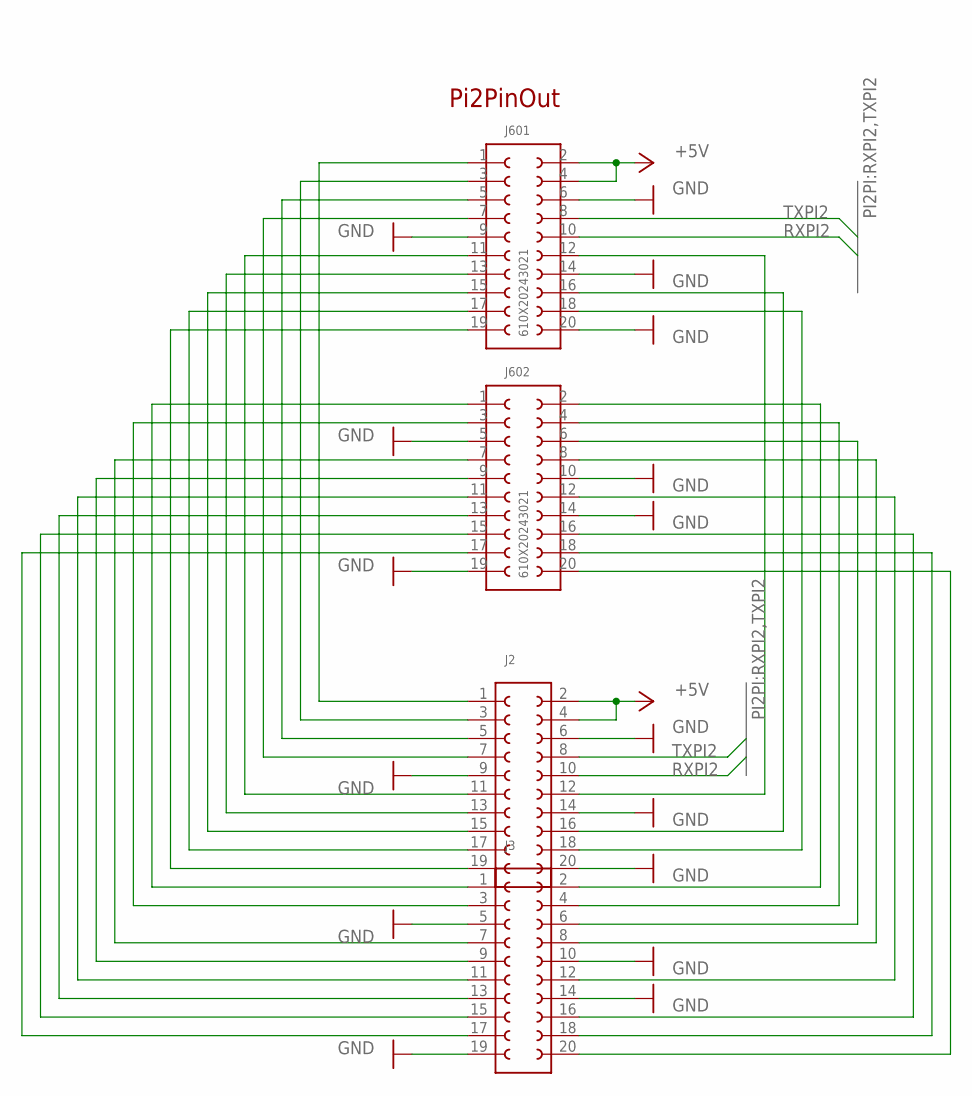
[picture p117: schematic Rover_PCB_2019-02-01.sch, sheet 6]

Parts:
J2, J3: 610X2021121
J601, J602: 610X20243021

Connections:
+5V: J2.2 (20), J2.4 (19), J601.2 (1), J601.4 (2); also elsewhere on the board
GND: J2.6 (18), J2.9 (5), J2.14, J2.20 (11), J3.5 (3), J3.10 (16), J3.14, J3.19 (10), J601.6 (3), J601.9 (16), J601.14 (7), J601.20 (10), J602.5 (18), J602.10 (5), J602.14 (7), J602.19 (11); also elsewhere on the board
unnamed: J3.11 (6), J602.11 (15)
unnamed: J3.13 (7), J602.13 (14)
unnamed: J3.15 (8), J602.15 (13)
unnamed: J3.17 (9), J602.17 (12)
unnamed: J2.16 (13), J601.16 (8)
unnamed: J2.12 (15), J601.12 (6)
unnamed: J2.18 (12), J601.18 (9)
unnamed: J3.2 (20), J602.2 (1)
unnamed: J3.4 (19), J602.4 (2)
unnamed: J3.6 (18), J602.6 (3)
unnamed: J3.8 (17), J602.8 (4)
unnamed: J3.12 (15), J602.12 (6)
unnamed: J2.3 (2), J601.3 (19)
unnamed: J2.5 (3), J601.5 (18)
unnamed: J2.7 (4), J601.7 (17)
unnamed: J2.11 (6), J601.11 (15)
unnamed: J2.13 (7), J601.13 (14)
unnamed: J2.15 (8), J601.15 (13)
unnamed: J2.1, J601.1 (20)
unnamed: J2.19 (10), J601.19 (11)
unnamed: J3.1, J602.1 (20)
unnamed: J3.3 (2), J602.3 (19)
unnamed: J3.7 (4), J602.7 (17)
unnamed: J3.9 (5), J602.9 (16)
unnamed: J3.16 (13), J602.16 (8)
unnamed: J3.18 (12), J602.18 (9)
unnamed: J3.20 (11), J602.20 (10)
unnamed: J2.17 (9), J601.17 (12)
RXPI2: J2.10 (16), J601.10 (5); also elsewhere on the board
TXPI2: J2.8 (17), J601.8 (4); also elsewhere on the board

Notes on the sheet:
Pi2PinOut

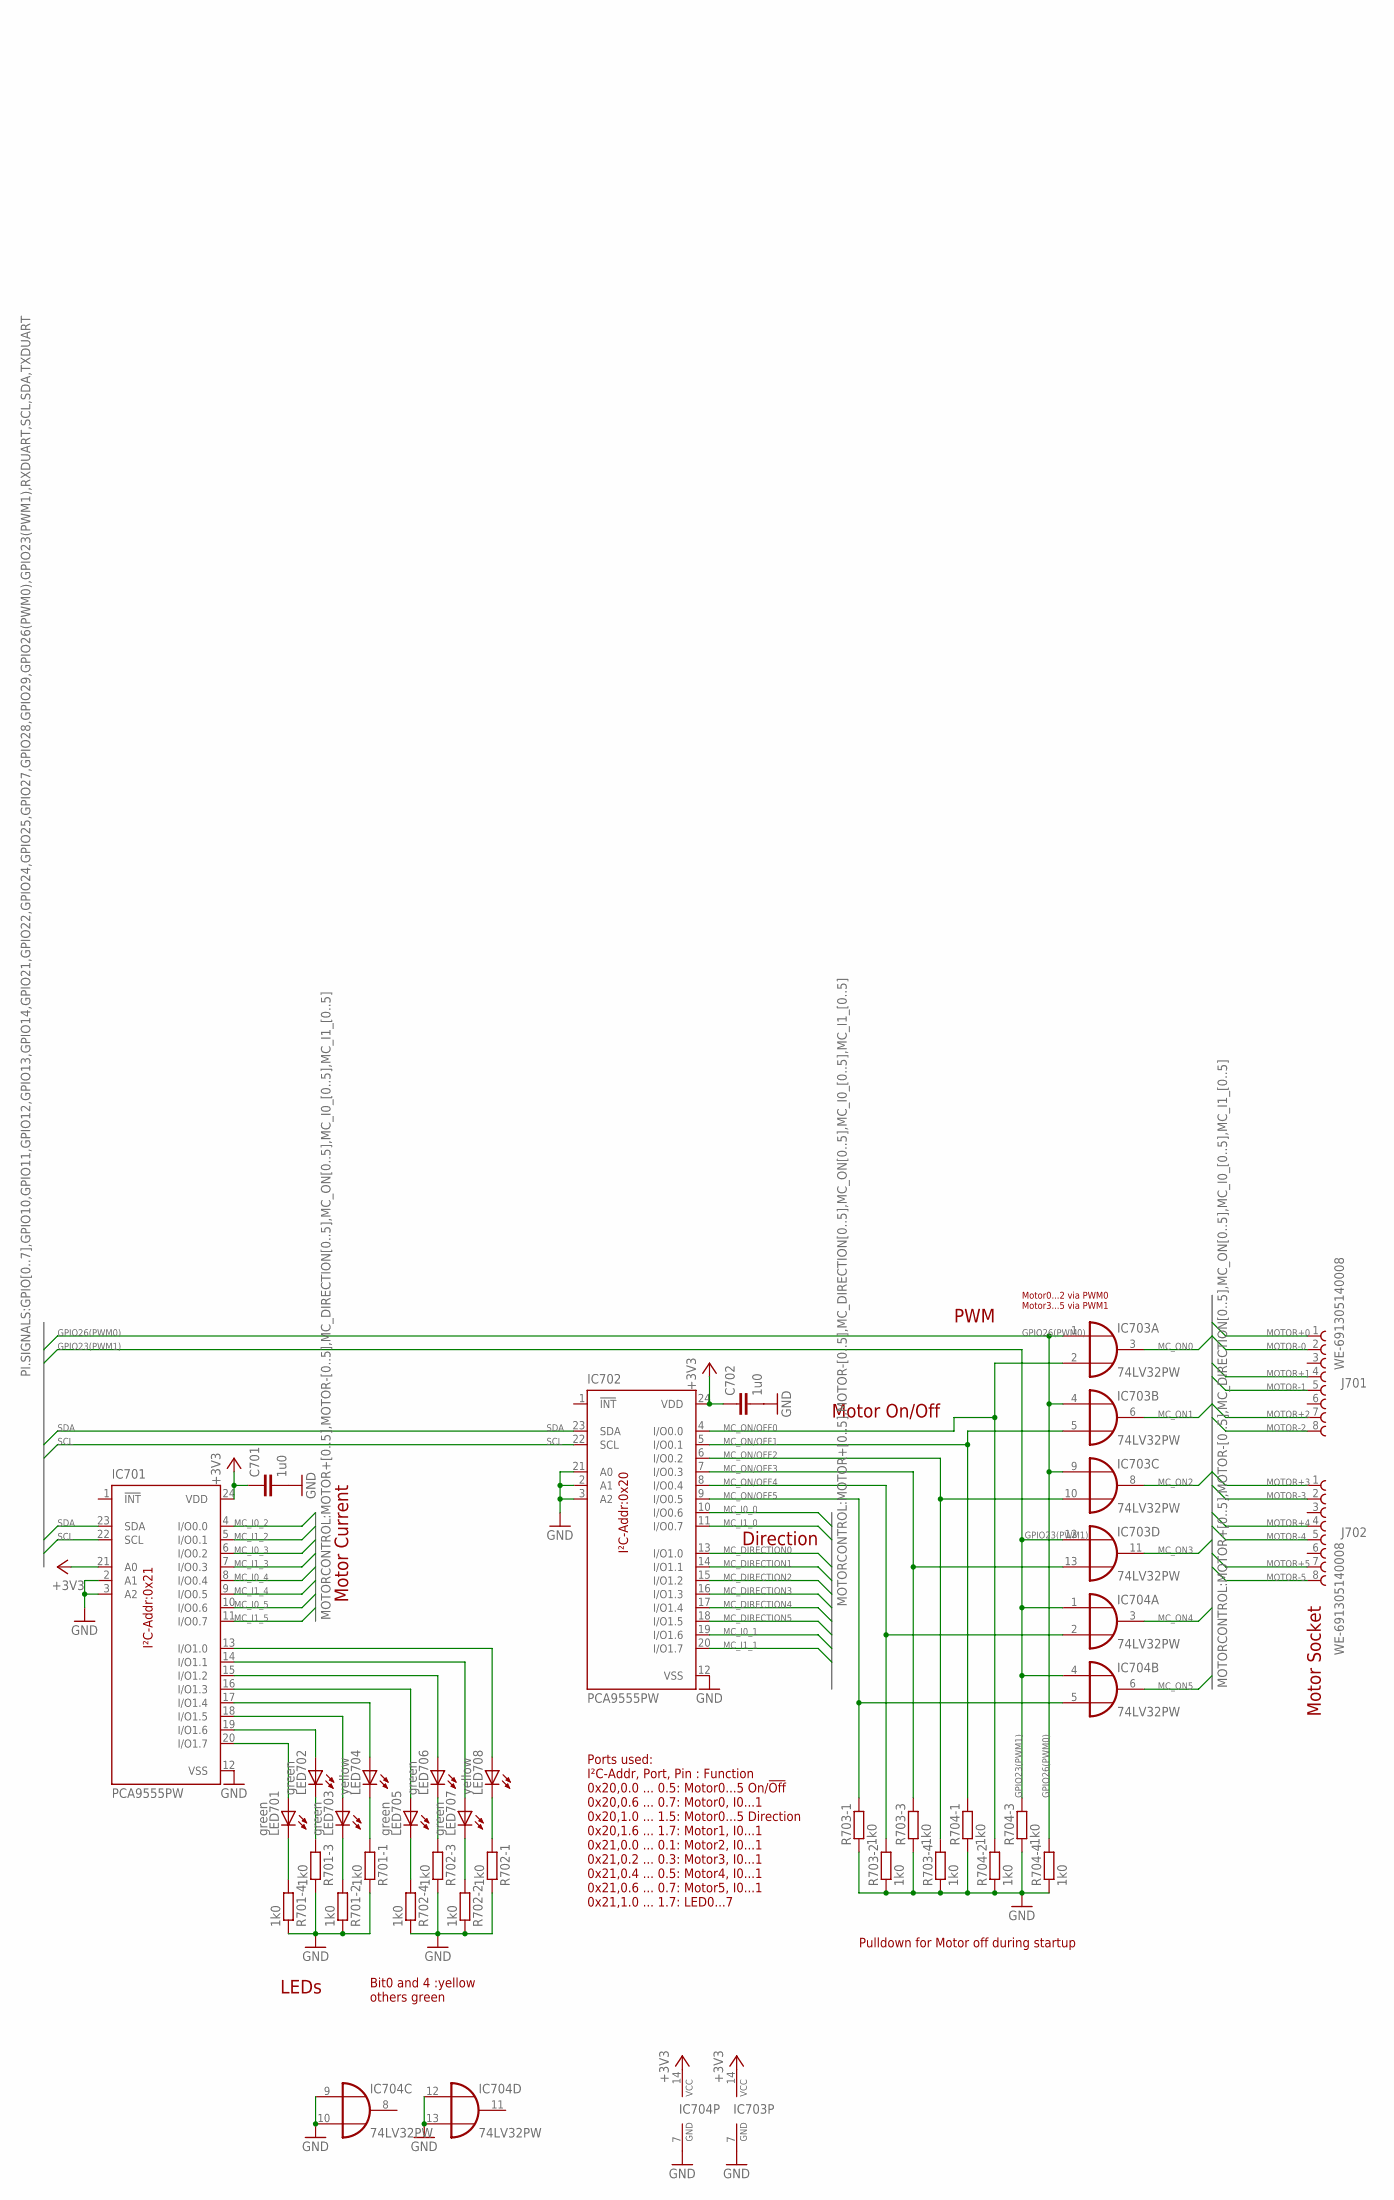
[picture p118: schematic Rover_PCB_2019-02-01.sch, sheet 7]

Parts:
C701, C702: 1u0; CAPC2012X95N
IC701, IC702: PCA9555PW; TSSOP24
IC703, IC704: 74LV32PW; SOP14P65_500X640X120L62X24L
J701, J702: WE-691305140008; 691305140008
LED701, LED702, LED703, LED705, LED706, LED707: green; LED-0603
LED704, LED708: yellow; LED-0603
R701, R702, R703, R704: 1k0; CAPCAF80P160X320X70-8L

Connections:
+3V3: C701.1, C702.1, IC701.21 (A0), IC701.24 (VDD), IC702.24 (VDD), IC703.14 (VCC), IC704.14 (VCC); also elsewhere on the board
GND: C701.2, C702.2, IC701.2 (A1), IC701.3 (A2), IC701.12 (VSS), IC702.2 (A1), IC702.3 (A2), IC702.12 (VSS), IC702.21 (A0), IC703.7 (GND), IC704.7 (GND), IC704.9 (I0), IC704.10 (I1), IC704.12 (I0), IC704.13 (I1), R701.1, R701.2 (1), R701.3 (1), R701.4 (1), R702.1, R702.2 (1), R702.3 (1), R702.4 (1), R703.1, R703.2 (1), R703.3 (1), R703.4 (1), R704.1, R704.2 (1), R704.3 (1), R704.4 (1); also elsewhere on the board
GPIO23(PWM1): IC703.12 (I0), IC704.1 (I0), IC704.4 (I0), R704.6 (2); also elsewhere on the board
GPIO26(PWM0): IC703.1 (I0), IC703.4 (I0), IC703.9 (I0), R704.5 (2); also elsewhere on the board
MC_DIRECTION0: IC702.13 (I/O1.0); also elsewhere on the board
MC_DIRECTION1: IC702.14 (I/O1.1); also elsewhere on the board
MC_DIRECTION2: IC702.15 (I/O1.2); also elsewhere on the board
MC_DIRECTION3: IC702.16 (I/O1.3); also elsewhere on the board
MC_DIRECTION4: IC702.17 (I/O1.4); also elsewhere on the board
MC_DIRECTION5: IC702.18 (I/O1.5); also elsewhere on the board
MC_I0_0: IC702.10 (I/O0.6); also elsewhere on the board
MC_I0_1: IC702.19 (I/O1.6); also elsewhere on the board
MC_I0_2: IC701.4 (I/O0.0); also elsewhere on the board
MC_I0_3: IC701.6 (I/O0.2); also elsewhere on the board
MC_I0_4: IC701.8 (I/O0.4); also elsewhere on the board
MC_I0_5: IC701.10 (I/O0.6); also elsewhere on the board
MC_I1_0: IC702.11 (I/O0.7); also elsewhere on the board
MC_I1_1: IC702.20 (I/O1.7); also elsewhere on the board
MC_I1_2: IC701.5 (I/O0.1); also elsewhere on the board
MC_I1_3: IC701.7 (I/O0.3); also elsewhere on the board
MC_I1_4: IC701.9 (I/O0.5); also elsewhere on the board
MC_I1_5: IC701.11 (I/O0.7); also elsewhere on the board
MC_ON0: IC703.3 (O); also elsewhere on the board
MC_ON1: IC703.6 (O); also elsewhere on the board
MC_ON2: IC703.8 (O); also elsewhere on the board
MC_ON3: IC703.11 (O); also elsewhere on the board
MC_ON4: IC704.3 (O); also elsewhere on the board
MC_ON5: IC704.6 (O); also elsewhere on the board
MC_ON/OFF0: IC702.4 (I/O0.0), IC703.2 (I1), R704.7 (2)
MC_ON/OFF1: IC702.5 (I/O0.1), IC703.5 (I1), R704.8 (2)
MC_ON/OFF2: IC702.6 (I/O0.2), IC703.10 (I1), R703.5 (2)
MC_ON/OFF3: IC702.7 (I/O0.3), IC703.13 (I1), R703.6 (2)
MC_ON/OFF4: IC702.8 (I/O0.4), IC704.2 (I1), R703.7 (2)
MC_ON/OFF5: IC702.9 (I/O0.5), IC704.5 (I1), R703.8 (2)
MOTOR+0: J701.1 (8); also elsewhere on the board
MOTOR+1: J701.4 (5); also elsewhere on the board
MOTOR+2: J701.7 (2); also elsewhere on the board
MOTOR+3: J702.1 (8); also elsewhere on the board
MOTOR+4: J702.4 (5); also elsewhere on the board
MOTOR+5: J702.7 (2); also elsewhere on the board
MOTOR-0: J701.2 (7); also elsewhere on the board
MOTOR-1: J701.5 (4); also elsewhere on the board
MOTOR-2: J701.8 (1); also elsewhere on the board
MOTOR-3: J702.2 (7); also elsewhere on the board
MOTOR-4: J702.5 (4); also elsewhere on the board
MOTOR-5: J702.8 (1); also elsewhere on the board
unnamed: LED708.C, R702.8 (2)
unnamed: LED707.C, R702.7 (2)
unnamed: LED706.C, R702.6 (2)
unnamed: LED705.C, R702.5 (2)
unnamed: LED704.C, R701.8 (2)
unnamed: LED703.C, R701.7 (2)
unnamed: LED702.C, R701.6 (2)
unnamed: LED701.C, R701.5 (2)
unnamed: IC701.13 (I/O1.0), LED708.A
unnamed: IC701.14 (I/O1.1), LED707.A
unnamed: IC701.15 (I/O1.2), LED706.A
unnamed: IC701.16 (I/O1.3), LED705.A
unnamed: IC701.17 (I/O1.4), LED704.A
unnamed: IC701.18 (I/O1.5), LED703.A
unnamed: IC701.19 (I/O1.6), LED702.A
unnamed: IC701.20 (I/O1.7), LED701.A
SCL: IC701.22 (SCL), IC702.22 (SCL); also elsewhere on the board
SDA: IC701.23 (SDA), IC702.23 (SDA); also elsewhere on the board

Notes on the sheet:
PWM
Motor On/Off
Direction
Motor Current
LEDs
I²C-Addr:0x20
I²C-Addr:0x21
Ports used: I²C-Addr, Port, Pin : Function 0x20,0.0 ... 0.5: Motor0...5 On/!Off! 0x20,0.6 ... 0.7: Motor0, I0...1 0x20,1.0 ... 1.5: Motor0...5 Direction 0x20,1.6 ... 1.7: Motor1, I0...1 0x21,0.0 ... 0.1: Motor2, I0...1 0x21,0.2 ... 0.3: Motor3, I0...1 0x21,0.4 ... 0.5: Motor4, I0...1 0x21,0.6 ... 0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
Pulldown for Motor off during startup
Bit0 and 4 :yellow others green
Motor0...2 via PWM0 Motor3...5 via PWM1
Motor Socket
