MartinSchafferer/Sensorik_MarsRover/3. Elektronik/Rover/MarsRover/Rover_PCB_2019-02-01.brd

## EAGLE design 3. Elektronik/Rover/MarsRover/Rover_PCB_2019-02-01.brd (continued)

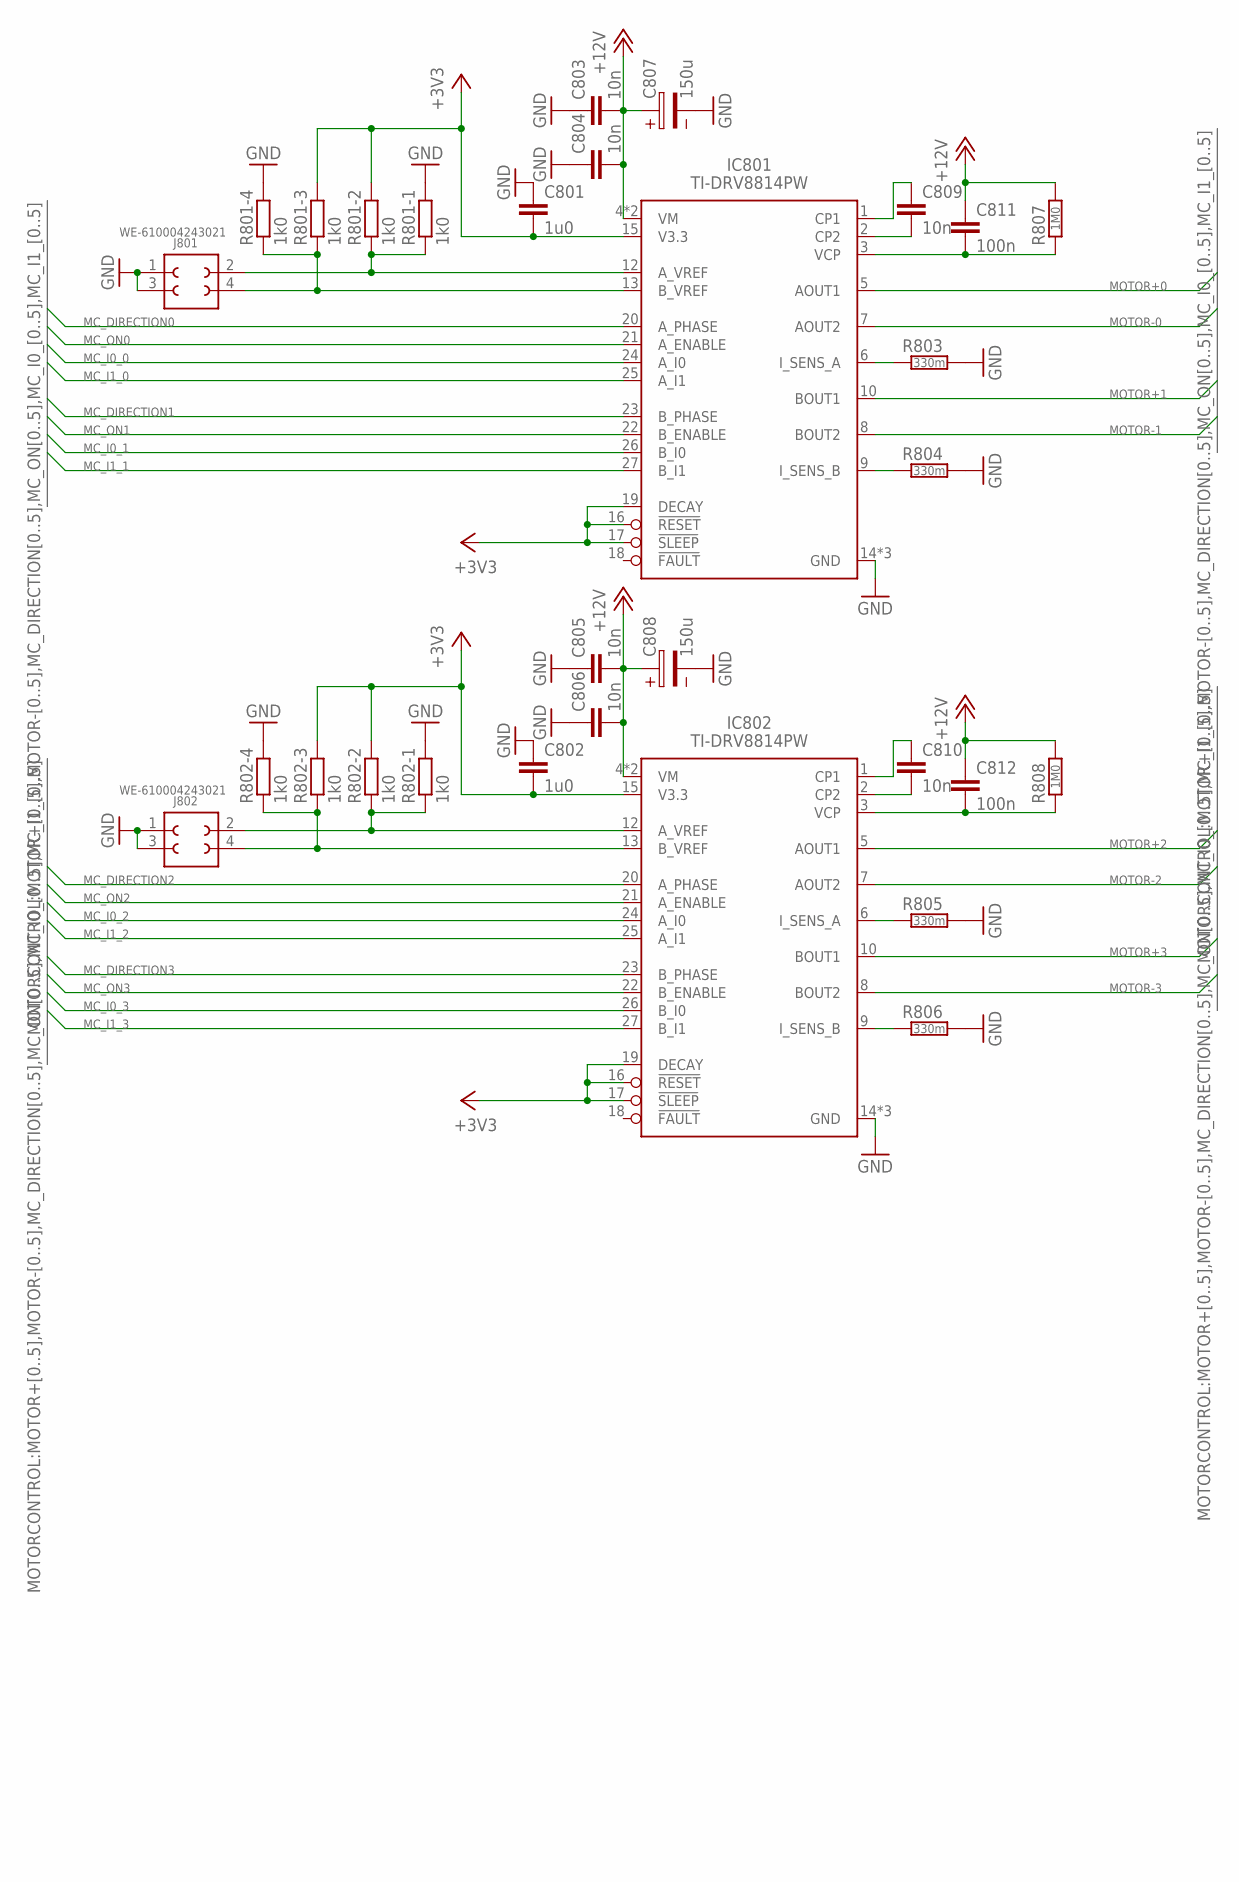
[picture p119: schematic Rover_PCB_2019-02-01.sch, sheet 8]

Parts:
C801, C802: 1u0; CAPC2012X95N
C803, C804, C805, C806, C809, C810: 10n; CAPC2012X95N
C807, C808: 150u; 4.2X1.9X2.8(BXCXA)
C811, C812: 100n; CAPC2012X95N
IC801, IC802: TI-DRV8814PW; SOP29P65_970X640X120L60X24T500X270N
J801, J802: WE-610004243021; 610X04243021
R801, R802: 1k0; CAPCAF80P160X320X70-8L
R803, R804, R805, R806: 330m; RESC160X320X65L50L
R807, R808: 1M0; RESC2012X50N

Connections:
+3V3: C801.2, C802.2, IC801.15 (V3.3), IC801.16 (!RESET), IC801.17 (!SLEEP), IC801.19 (DECAY), IC802.15 (V3.3), IC802.16 (!RESET), IC802.17 (!SLEEP), IC802.19 (DECAY), R801.6 (2), R801.7 (2), R802.6 (2), R802.7 (2); also elsewhere on the board
+12V: C803.2, C804.2, C805.2, C806.2, C807.1, C808.1, C811.1, C812.1, IC801.4 (VM), IC801.11 (VM), IC802.4 (VM), IC802.11 (VM), R807.2, R808.2; also elsewhere on the board
GND: C801.1, C802.1, C803.1, C804.1, C805.1, C806.1, C807.2, C808.2, IC801.14 (GND), IC801.28 (GND), IC801.29 (GND), IC802.14 (GND), IC802.28 (GND), IC802.29 (GND), J801.1, J801.3 (2), J802.1, J802.3 (2), R801.5 (2), R801.8 (2), R802.5 (2), R802.8 (2), R803.2, R804.2, R805.2, R806.2; also elsewhere on the board
MC_DIRECTION0: IC801.20 (A_PHASE); also elsewhere on the board
MC_DIRECTION1: IC801.23 (B_PHASE); also elsewhere on the board
MC_DIRECTION2: IC802.20 (A_PHASE); also elsewhere on the board
MC_DIRECTION3: IC802.23 (B_PHASE); also elsewhere on the board
MC_I0_0: IC801.24 (A_I0); also elsewhere on the board
MC_I0_1: IC801.26 (B_I0); also elsewhere on the board
MC_I0_2: IC802.24 (A_I0); also elsewhere on the board
MC_I0_3: IC802.26 (B_I0); also elsewhere on the board
MC_I1_0: IC801.25 (A_I1); also elsewhere on the board
MC_I1_1: IC801.27 (B_I1); also elsewhere on the board
MC_I1_2: IC802.25 (A_I1); also elsewhere on the board
MC_I1_3: IC802.27 (B_I1); also elsewhere on the board
MC_ON0: IC801.21 (A_ENABLE); also elsewhere on the board
MC_ON1: IC801.22 (B_ENABLE); also elsewhere on the board
MC_ON2: IC802.21 (A_ENABLE); also elsewhere on the board
MC_ON3: IC802.22 (B_ENABLE); also elsewhere on the board
MOTOR+0: IC801.5 (AOUT1); also elsewhere on the board
MOTOR+1: IC801.10 (BOUT1); also elsewhere on the board
MOTOR+2: IC802.5 (AOUT1); also elsewhere on the board
MOTOR+3: IC802.10 (BOUT1); also elsewhere on the board
MOTOR-0: IC801.7 (AOUT2); also elsewhere on the board
MOTOR-1: IC801.8 (BOUT2); also elsewhere on the board
MOTOR-2: IC802.7 (AOUT2); also elsewhere on the board
MOTOR-3: IC802.8 (BOUT2); also elsewhere on the board
unnamed: C811.2, IC801.3 (VCP), R807.1
unnamed: C809.2, IC801.2 (CP2)
unnamed: C809.1, IC801.1 (CP1)
unnamed: IC801.6 (I_SENS_A), R803.1
unnamed: IC801.9 (I_SENS_B), R804.1
unnamed: IC801.13 (B_VREF), J801.4 (3), R801.3 (1), R801.4 (1)
unnamed: IC801.12 (A_VREF), J801.2 (4), R801.1, R801.2 (1)
unnamed: C812.2, IC802.3 (VCP), R808.1
unnamed: C810.2, IC802.2 (CP2)
unnamed: C810.1, IC802.1 (CP1)
unnamed: IC802.6 (I_SENS_A), R805.1
unnamed: IC802.9 (I_SENS_B), R806.1
unnamed: IC802.13 (B_VREF), J802.4 (3), R802.3 (1), R802.4 (1)
unnamed: IC802.12 (A_VREF), J802.2 (4), R802.1, R802.2 (1)

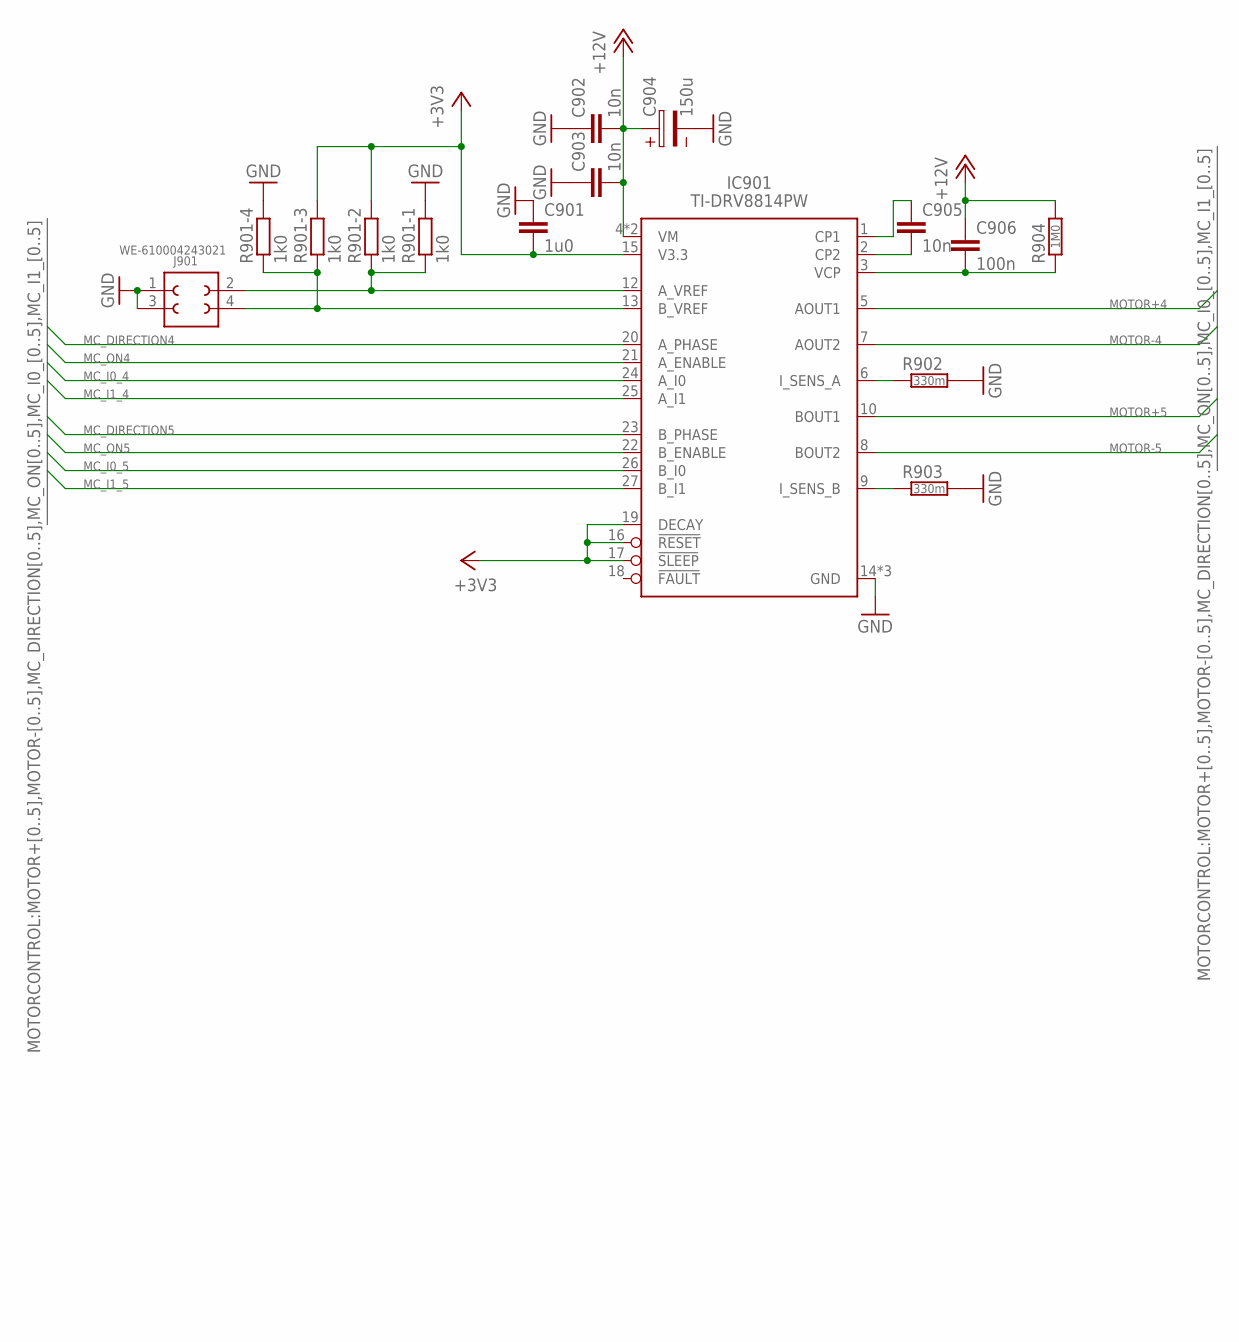
[picture p120: schematic Rover_PCB_2019-02-01.sch, sheet 9]

Parts:
C901: 1u0; CAPC2012X95N
C902, C903, C905: 10n; CAPC2012X95N
C904: 150u; 4.2X1.9X2.8(BXCXA)
C906: 100n; CAPC2012X95N
IC901: TI-DRV8814PW; SOP29P65_970X640X120L60X24T500X270N
J901: WE-610004243021; 610X04243021
R901: 1k0; CAPCAF80P160X320X70-8L
R902, R903: 330m; RESC160X320X65L50L
R904: 1M0; RESC2012X50N

Connections:
+3V3: C901.2, IC901.15 (V3.3), IC901.16 (!RESET), IC901.17 (!SLEEP), IC901.19 (DECAY), R901.6 (2), R901.7 (2); also elsewhere on the board
+12V: C902.2, C903.2, C904.1, C906.1, IC901.4 (VM), IC901.11 (VM), R904.2; also elsewhere on the board
GND: C901.1, C902.1, C903.1, C904.2, IC901.14 (GND), IC901.28 (GND), IC901.29 (GND), J901.1, J901.3 (2), R901.5 (2), R901.8 (2), R902.2, R903.2; also elsewhere on the board
MC_DIRECTION4: IC901.20 (A_PHASE); also elsewhere on the board
MC_DIRECTION5: IC901.23 (B_PHASE); also elsewhere on the board
MC_I0_4: IC901.24 (A_I0); also elsewhere on the board
MC_I0_5: IC901.26 (B_I0); also elsewhere on the board
MC_I1_4: IC901.25 (A_I1); also elsewhere on the board
MC_I1_5: IC901.27 (B_I1); also elsewhere on the board
MC_ON4: IC901.21 (A_ENABLE); also elsewhere on the board
MC_ON5: IC901.22 (B_ENABLE); also elsewhere on the board
MOTOR+4: IC901.5 (AOUT1); also elsewhere on the board
MOTOR+5: IC901.10 (BOUT1); also elsewhere on the board
MOTOR-4: IC901.7 (AOUT2); also elsewhere on the board
MOTOR-5: IC901.8 (BOUT2); also elsewhere on the board
unnamed: C906.2, IC901.3 (VCP), R904.1
unnamed: C905.2, IC901.2 (CP2)
unnamed: C905.1, IC901.1 (CP1)
unnamed: IC901.6 (I_SENS_A), R902.1
unnamed: IC901.9 (I_SENS_B), R903.1
unnamed: IC901.13 (B_VREF), J901.4 (3), R901.3 (1), R901.4 (1)
unnamed: IC901.12 (A_VREF), J901.2 (4), R901.1, R901.2 (1)

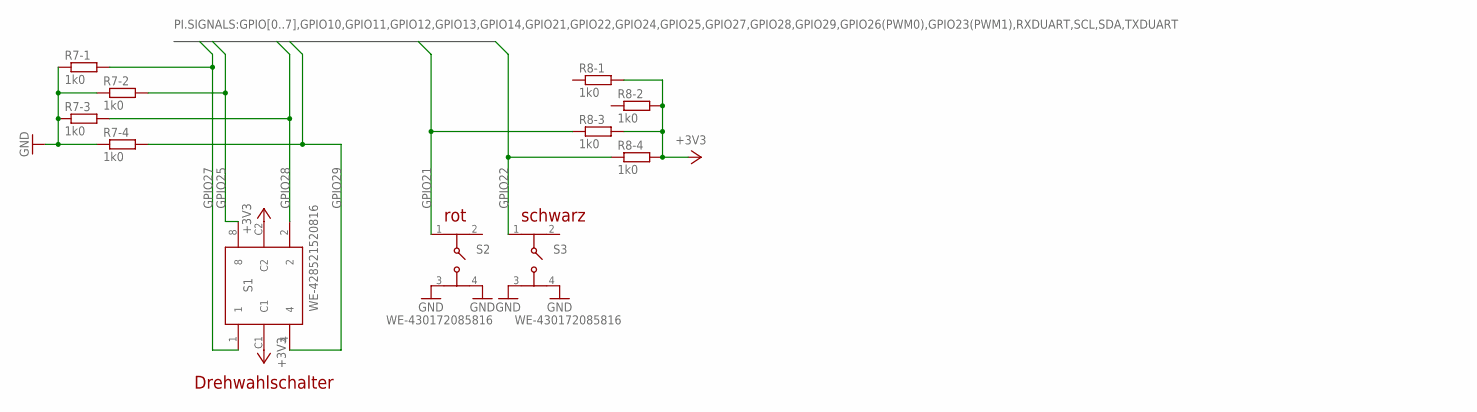
[picture p121: schematic Rover_PCB_2019-02-01.sch, sheet 10]

Parts:
R7, R8: 1k0; CAPCAF80P160X320X70-8L
S1: WE-428521520816; 428521520816
S2, S3: WE-430172085816; 4301X20438X6

Connections:
+3V3: R8.5 (2), R8.6 (2), R8.7 (2), R8.8 (2), S1.C1, S1.C2; also elsewhere on the board
GND: R7.1, R7.2 (1), R7.3 (1), R7.4 (1), S2.3 (2), S2.4, S3.3 (2), S3.4; also elsewhere on the board
GPIO21: R8.3 (1), S2.1; also elsewhere on the board
GPIO22: R8.4 (1), S3.1; also elsewhere on the board
GPIO25: R7.7 (2), S1.8; also elsewhere on the board
GPIO27: R7.8 (2), S1.1; also elsewhere on the board
GPIO28: R7.6 (2), S1.2; also elsewhere on the board
GPIO29: R7.5 (2), S1.4; also elsewhere on the board

Notes on the sheet:
rot
schwarz
Drehwahlschalter

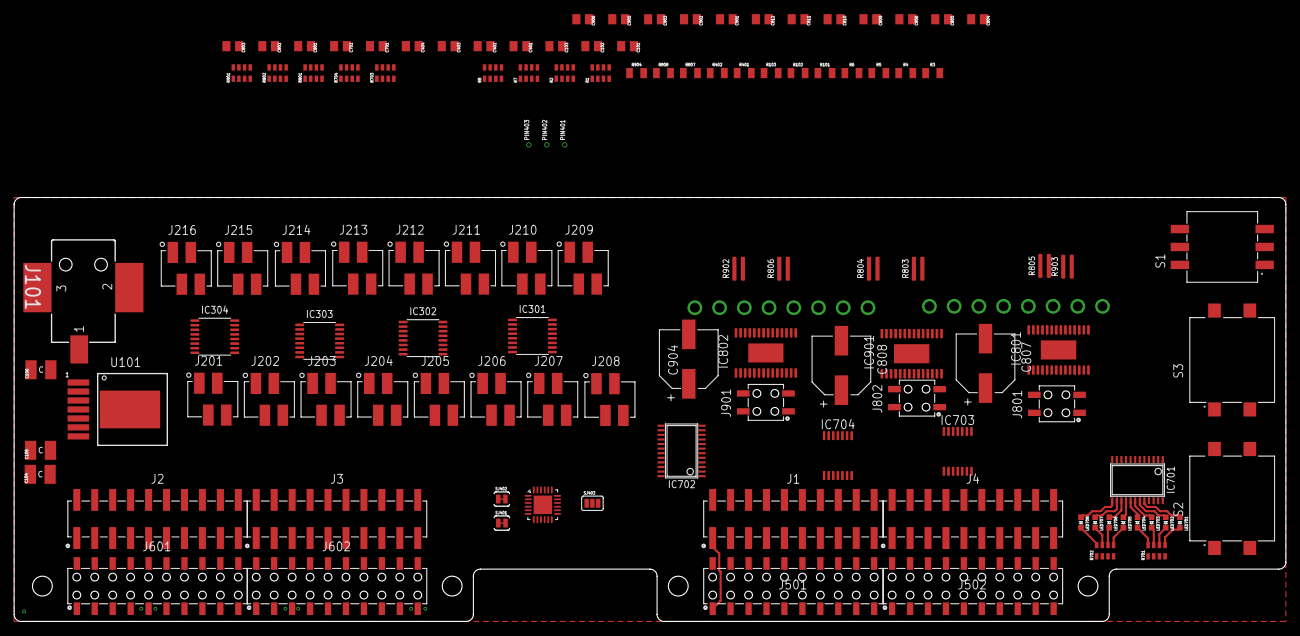
[picture p122: board Rover_PCB_2019-02-01.brd from above]

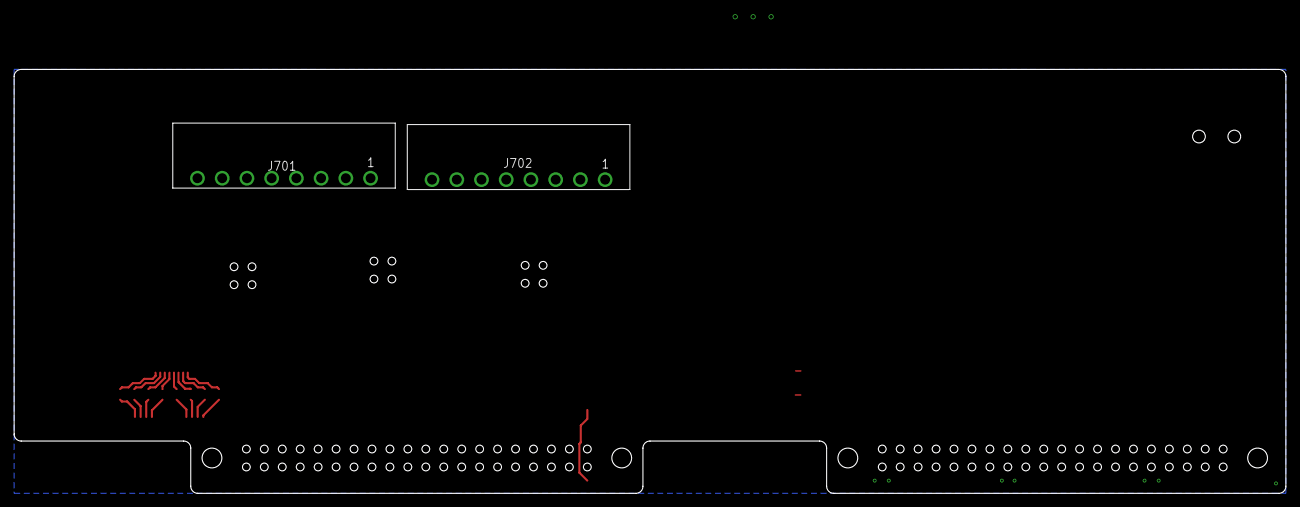
[picture p123: board Rover_PCB_2019-02-01.brd from below]

Board: 4 copper layers, 180.0 x 60.0 mm, 119 parts (2 on the bottom side), 190 nets.
